ElectronicEnthusiast/ElectricSkateboard/Pictures/IDDK_V2_Level2_TestingLEMCurrentSensing/20170704_121624.jpg

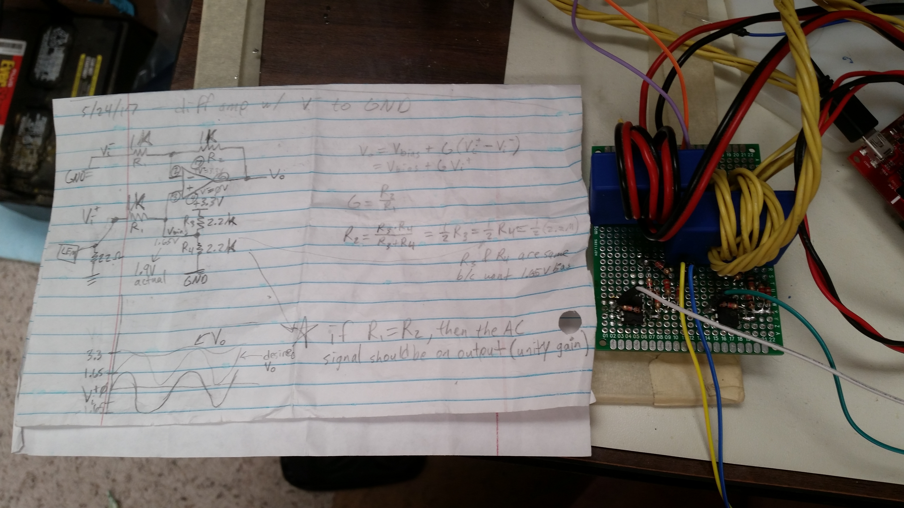
Pictures/IDDK_V2_Level2_TestingLEMCurrentSensing/20170704_121624.jpg
