ElectronicEnthusiast/ElectricSkateboard/Pictures/IDDK_V2_Level1_TestingSVPWM_DirectQuadratureTesting/20170227_211748.jpg-1230x0.jpg

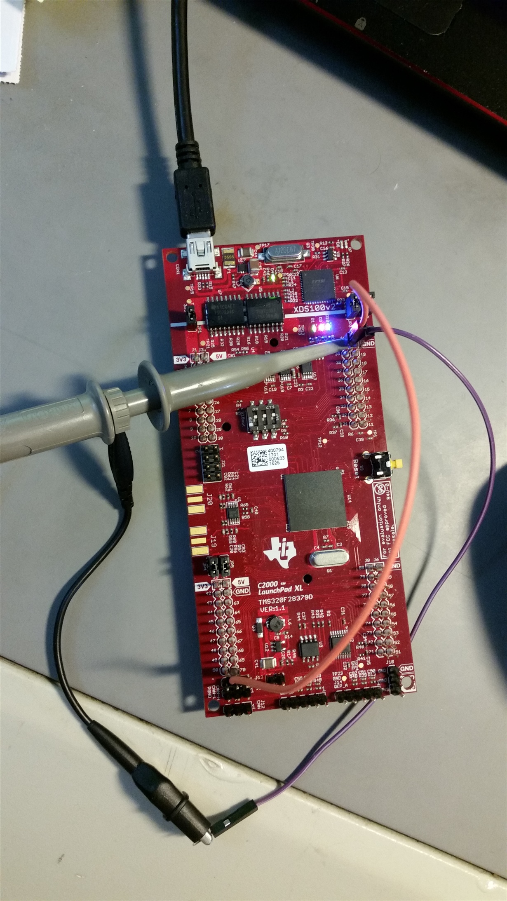
Pictures/IDDK_V2_Level1_TestingSVPWM_DirectQuadratureTesting/20170227_211748.jpg-1230x0.jpg
