ElectronicEnthusiast/ElectricSkateboard/README.md

# MotorController
Inverter Motor Control Board For BLDC Motor - 100V,100A

The motor controller board is generic, so it will comply with all Texas Instruments Launchpads using their "Boosterpack pin layout".
The board software utilizes a high performance F28379D Launchpad microcontroller development board from Texas Instruments.
The motor controller uses Texas Instruments integrated circuits to isolate the logic from the power components.
