ElectronicEnthusiast/ElectricSkateboard/Hardware/Calculations_GateDriverBoard.xlsx

Sheet: MOSFETGateDriver
MOSFET Gate Drive Circuit Component Value Determinations
Referencing TexasInstruments: "tidubx1b.pdf"
VDD input (Volts) | 17
VDDA voltage after diode (volts) | 16.7
UCC21520DW GateDriver IC Limitations:
Max Source current (amps) | 4amps
Max Sink current (amps) | 6amps
Max voltage (VDDA & VDDB) | 25volts
IRFSL4115PBF MOSFET Limitations
Max voltage (Vgs) (volts) | 20
R_MosfetGate (ohms) minimum | 2.2
Source Current Calculation
Rg_ON (ohms) | 10
Rg_OFF (ohms) | 0
Bootstrap Diode and Off Diode | VS-MBRS130L-M3
Schottky Diode (low on time and low diode resistance
Voltage Drop Vdiode (Volts) | 0.3
Sink Current:
Current Consumption per MOSFET turn on (Bootstrap Circuit pumps charge to MOSFET gate)

Sheet: BusVoltageAnalogSensing
Bus Voltage Scaling
Referencing TexasInstruments: "tidubx1b.pdf"
Maximum Input Bus Voltage (Volt) | 100
Sense Voltage Range (Volt) | 0.5 | // this is the input capability of the amplifier (+/- 250mV for AMC1301)
 |  | // 500mV is total range of input +250mV - (-250mV)
R_batt1 (Ohm) | 1000000
R_batt2 (Ohm) | 1000000
R_batt3 (Ohm) | 1000000
R_batt4 (Ohm) | 1000000
HighVoltageResistance (Ohm) | 4000000
Solved Sense Resistor Value (ohm) | 20100.50251 |  | Maximum Output Voltage (Volt) | 0.5
Calculate Voltage Divider after larger voltage divider that shifts the input voltage from 0V-500mV to +/-250mV
Premise: Offset the bottom of the differential signal to give value of +250mV there. This will give -250mV if the top rail sees 0V for the Battery+ voltage
Vsense | 0.5
DesiredVoltageBiasOfBottomVoltage | 0.25
Bias Input Voltage (Volt) | 3.3
R_topSecondVoltageDivider (ohm) | 50000
RBottomSecondVoltageDivider_Solver (ohm) | 4098.360656
Bias Voltage (Volt) | 0.25
AMC1301 Input Differential Low-Pass Filter | fc = 1/(2πRC)
Capacitor | 1e-08
Resistor | 78
Desired Cutoff Frequency | 204044.7988
AMC1301 Output Differential Low-Pass Filter | fc = 1/(2πRC)
Capacitor | 1e-08
Resistor | 9400
Desired Cutoff Frequency | 1693.1377
OPA320 Feedback Low-Pass Filter | fc = 1/(2πRC)
Capacitor | 1e-08
Resistor | 7500
Desired Cutoff Frequency | 2122.0659
OPA320 Output Low-Pass Filter | fc = 1/(2πRC)
Capacitor | 1e-07
Resistor | 100
Desired Cutoff Frequency | 15915.4943

Sheet: TemperatureSensing
H-Bridge Temperature Analog Scaling
Referencing TexasInstruments: "tidubx1b.pdf"
Vsense_Thermistor (Volt) | 0.5 | // this is the input capability of the amplifier (+/- 250mV for AMC1301)
 |  | // 500mV is total range of input +250mV - (-250mV)
Input Thermistor Voltage Divider (Volt) | 3.3
R_thermistor (ohm) | 10000 | //chose common thermistor restance value
R_topThermistorVoltageDivider (ohm) | 56000.0000
Thermistor Resistance (25degC) | 10000
Thermistor Resistance (100degC) | 1000
TemperatureRangeMin (25degC) (Volt) | 0.5 | //at 25degC, the resistance is 10kΩ and voltage at output of thermistor divider is 500mV
TemperatureRangeMax (100degC) (Volt) | 0.05789473684 | //at 100degC, the resistance is 1kΩ and voltage at output of thermistor divider is 57mV
Calculate Voltage Divider after larger voltage divider that shifts the input voltage from 0V-500mV to +/-250mV
Premise: Offset the bottom of the differential signal to give value of +250mV there. This will give -250mV if the thermistor reads 100degC and reads about 0.05789V
Vsense | 0.5
DesiredVoltageBiasOfBottomVoltage | 0.25
Bias Input Voltage (Volt) | 3.3
R_topSecondVoltageDivider (ohm) | 50000
RBottomSecondVoltageDivider_Solver (ohm) | 4098.360656
Bias Voltage (Volt) | 0.25
AMC1301 Input Differential Low-Pass Filter | fc = 1/(2πRC)
Capacitor | 1e-08 | 1.8e-10
Resistor | 78 | 9400
Desired Cutoff Frequency | 204044.7988
AMC1301 Output Differential Low-Pass Filter | fc = 1/(2πRC)
Capacitor | 1e-08
Resistor | 9400
Desired Cutoff Frequency | 1693.1377
OPA320 Feedback Low-Pass Filter | fc = 1/(2πRC)
Capacitor | 1e-08
Resistor | 7500
Desired Cutoff Frequency | 2122.0659
OPA320 Output Low-Pass Filter | fc = 1/(2πRC)
Capacitor | 1e-07
Resistor | 100
Desired Cutoff Frequency | 15915.4943

Sheet: PhaseCurrentSensing
Closed Loop Hall Current Sensing Analog Scaling for "LEM LA 100-P"
Referencing TexasInstruments: "tidubx1b.pdf"
Desired HallCurrentSensor Scaled (AC Volts) | 1.65
Desired DC Bias after Scaling to [-1.65V,1.65V]
Reading 0Amps at Microcontroller [Volts] | 0
Reading 150Amps at Microcontroller [Volts] | 1.65
Input HallCurrentSensor Voltage Divider [Volts] | 15
LEM Rm_total (ohm) == R1+R2 [ohms] | 22 | //total output impedance [ohms] of Hall Sensor (from LEM LA-100P datasheet under 85degC 150Amps max current condition)
Voltage Divider to Calculate Measuring Resistor Values for LEM Current Transducer
R1 | 2.42
R2 | 19.58
IsenseCurrent on secondary @ full LEM primary current of 100A | 0.6818181818
Vin_Max | 15
Vin_Min | -15
Vin range | 30
Vout_Max | 3.3
Vout_Min | 0
Vout range | 3.3
Vbias | 3.3
Vout_bias | 1.65
LEM Full Scale Range Measurement [Amps] | 150
LEM Conversion Turns Ratio [N wire turns] | 2000 | //Denoted by Kn (Conversion Ratio on Datasheet of LEM)
LEM Full Scale Secondary Transformer Current [Amps] | 0.075
Rm | 22

Sheet: Sheet1
LA 100-P | Units
Conversion Turns Ratio | Turns | 2000
Ip_max | Amps | 150
Secondary Current | Amps | 0.075
Measure Resistor | Ohms | 22
Max Voltage | Volts | 1.65
