ElectronicEnthusiast/ElectricSkateboard/Hardware/GateDriver_BLDC_MOSFET_PDF/GateDriver_BLDC_MOSFET.jpg

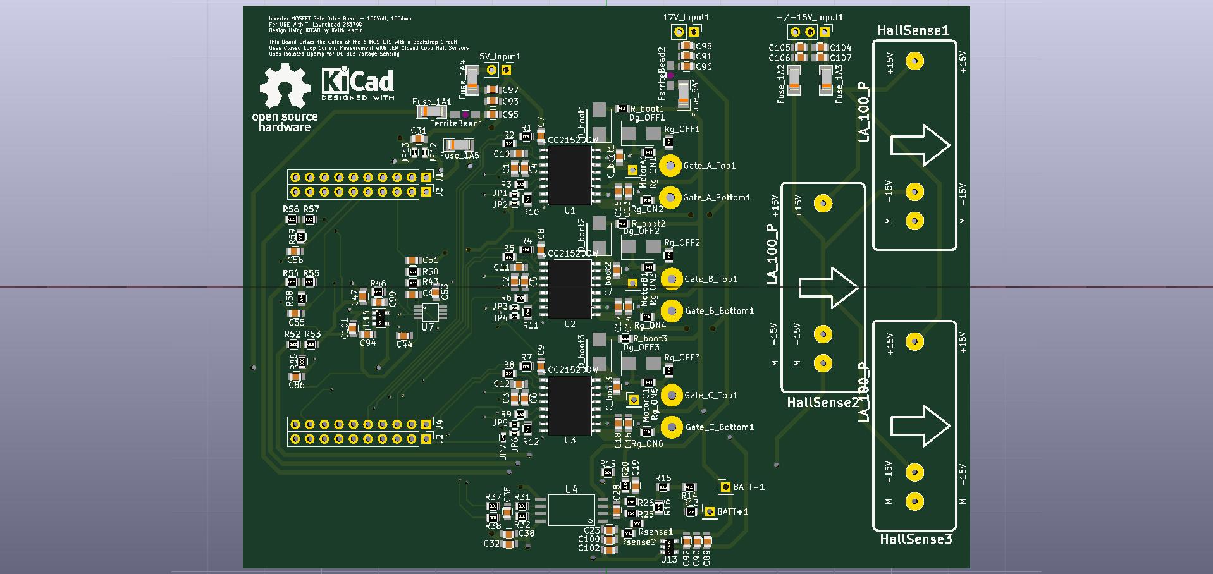
Hardware/GateDriver_BLDC_MOSFET_PDF/GateDriver_BLDC_MOSFET.jpg
