ElectronicEnthusiast/ElectricSkateboard/Hardware/BOM1_Mouser.xlsx

Web Link | Added To Mouser | ref | value5 | Description | footprint |  | part | names | tstamps6 | tstamp | lib7 | part8 | field | name9 | num | name10 | type | description2 | fp | logical | uri | code | name11 | ref12 | pin
 | Y | +/-15V_Input1 | CONN_01X03 |  | Socket_Strips:Socket_Strip_Straight_1x03_Pitch2.54mm |  | CONN_01X03 | /Power_Inputs/ | /581F1F0E/ | 581F75B2
 | Y | 17V_Input1 | CONN_01X02 |  | Socket_Strips:Socket_Strip_Straight_1x02_Pitch2.54mm |  | CONN_01X02 | /Power_Inputs/ | /581F1F0E/ | 582BFE9A
 | Y | 5V_Input1 | CONN_01X02 |  | Socket_Strips:Socket_Strip_Straight_1x02_Pitch2.54mm |  | CONN_01X02 | /Power_Inputs/ | /581F1F0E/ | 582C5D3C
 | Y | BATT+1 | BATT+ |  | Socket_Strips:Socket_Strip_Straight_1x01_Pitch2.54mm |  | PowerPin | /Power_Inputs/ | /581F1F0E/ | 58707C93
 | Y | BATT-1 | BATT- |  | Socket_Strips:Socket_Strip_Straight_1x01_Pitch2.54mm |  | PowerPin | /Power_Inputs/ | /581F1F0E/ | 58707D56
http://www.mouser.com/ProductDetail/GE-Critical-Power/SHHN000A3CL41Z/ | Y | +/-15V_Converter | SHHN000A3CL41Z |  | Isolated DC/DC Converters 9-36Vin, +/-15V out 9W Out | http://www.mouser.com/GE-Critical-Power/ | 894-SHHN000A3CL41Z
http://www.digikey.com/product-detail/en/aavid-thermalloy/6237BG/HS411-ND/1625500 | N | MOSFET Heat Sinks TO-220 HORIZ/VERT HAT SECT. CLIP ON |  |  | 6237BG | http://www.mouser.com/Aavid-Thermalloy/ | HS411-ND
http://www.mouser.com/ProductDetail/TDK/C2012X5R1H475K125AB/ | Y | C_boot1 | 0.47uF_ceramic |  | Capacitors_SMD:C_0805 |  | C | /GateDriveSheet/ | /5802F342/ | 5803E753
http://www.mouser.com/ProductDetail/TDK/C2012X5R1H475K125AB/ | Y | C_boot2 | 0.47uF_ceramic |  | Capacitors_SMD:C_0805 |  | C | /GateDriveSheet/ | /5802F342/ | 5806E60D
http://www.mouser.com/ProductDetail/TDK/C2012X5R1H475K125AB/ | Y | C_boot3 | 0.47uF_ceramic |  | Capacitors_SMD:C_0805 |  | C | /GateDriveSheet/ | /5802F342/ | 58070707
http://www.mouser.com/ProductDetail/Murata-Electronics/GRM21BR61E106KA73L/ | Y | C1 | 10uF_ceramic | Multilayer Ceramic Capacitors MLCC - SMD/SMT 0805 X5R 25V 10uF | Capacitors_SMD:C_0805 |  | C | /GateDriveSheet/ | /5802F342/ | 58038EB1
http://www.mouser.com/ProductDetail/KEMET/C0805C100J5GACTU/?qs=sGAEpiMZZMs0AnBnWHyRQAOlcDrFW2iELdDAK38U86U%3d | Y | C10 | 10pF_ceramic | Multilayer Ceramic Capacitors MLCC - SMD/SMT 50volts 10pF C0G 5% | Capacitors_SMD:C_0805 |  | C | /GateDriveSheet/ | /5802F342/ | 5803D299
http://www.mouser.com/ProductDetail/Murata-Electronics/GRM21BR61E106KA73L/ | Y | C100 | 10uF_ceramic | Multilayer Ceramic Capacitors MLCC - SMD/SMT 0805 X5R 25V 10uF | Capacitors_SMD:C_0805 |  | C_Small | /Power_Inputs/ | /581F1F0E/ | 589CA2C8
http://www.mouser.com/ProductDetail/KEMET/C0805C104K5RACTU/ | Y | C101 | 0.1uF_ceramic | Multilayer Ceramic Capacitors MLCC - SMD/SMT 50volts 0.1uF X7R 10% | Capacitors_SMD:C_0805 |  | C_Small | /Power_Inputs/ | /581F1F0E/ | 582D51F0
http://www.mouser.com/ProductDetail/KEMET/C0805C104K5RACTU/ | Y | C102 | 0.1uF_ceramic | Multilayer Ceramic Capacitors MLCC - SMD/SMT 50volts 0.1uF X7R 10% | Capacitors_SMD:C_0805 |  | C_Small | /Power_Inputs/ | /581F1F0E/ | 58221FE9
http://www.mouser.com/ProductDetail/KEMET/C0805C104K5RACTU/ | Y | C104 | 0.1uF_ceramic | Multilayer Ceramic Capacitors MLCC - SMD/SMT 50volts 0.1uF X7R 10% | Capacitors_SMD:C_0805 |  | C_Small | /Power_Inputs/ | /581F1F0E/ | 5822C599
http://www.mouser.com/ProductDetail/KEMET/C0805C104K5RACTU/ | Y | C105 | 0.1uF_ceramic | Multilayer Ceramic Capacitors MLCC - SMD/SMT 50volts 0.1uF X7R 10% | Capacitors_SMD:C_0805 |  | C_Small | /Power_Inputs/ | /581F1F0E/ | 5822C614
http://www.mouser.com/ProductDetail/Murata-Electronics/GRM21BR61E106KA73L/ | Y | C106 | 10uF_ceramic | Multilayer Ceramic Capacitors MLCC - SMD/SMT 0805 X5R 25V 10uF | Capacitors_SMD:C_0805 |  | C_Small | /Power_Inputs/ | /581F1F0E/ | 5822F04E
http://www.mouser.com/ProductDetail/Murata-Electronics/GRM21BR61E106KA73L/ | Y | C107 | 10uF_ceramic | Multilayer Ceramic Capacitors MLCC - SMD/SMT 0805 X5R 25V 10uF | Capacitors_SMD:C_0805 |  | C_Small | /Power_Inputs/ | /581F1F0E/ | 5822FAB2
http://www.mouser.com/ProductDetail/KEMET/C0805C100J5GACTU/?qs=sGAEpiMZZMs0AnBnWHyRQAOlcDrFW2iELdDAK38U86U%3d | Y | C11 | 10pF_ceramic | Multilayer Ceramic Capacitors MLCC - SMD/SMT 50volts 10pF C0G 5% | Capacitors_SMD:C_0805 |  | C | /GateDriveSheet/ | /5802F342/ | 5806E5E8
http://www.mouser.com/ProductDetail/KEMET/C0805C100J5GACTU/?qs=sGAEpiMZZMs0AnBnWHyRQAOlcDrFW2iELdDAK38U86U%3d | Y | C12 | 10pF_ceramic | Multilayer Ceramic Capacitors MLCC - SMD/SMT 50volts 10pF C0G 5% | Capacitors_SMD:C_0805 |  | C | /GateDriveSheet/ | /5802F342/ | 580706E6
http://www.mouser.com/ProductDetail/Murata-Electronics/GRM21BR61E106KA73L/ | Y | C13 | 10uF_ceramic | Multilayer Ceramic Capacitors MLCC - SMD/SMT 0805 X5R 25V 10uF | Capacitors_SMD:C_0805 |  | C | /GateDriveSheet/ | /5802F342/ | 5803E0BF
http://www.mouser.com/ProductDetail/Murata-Electronics/GRM21BR61E106KA73L/ | Y | C14 | 10uF_ceramic | Multilayer Ceramic Capacitors MLCC - SMD/SMT 0805 X5R 25V 10uF | Capacitors_SMD:C_0805 |  | C | /GateDriveSheet/ | /5802F342/ | 5806E5FE
http://www.mouser.com/ProductDetail/Murata-Electronics/GRM21BR61E106KA73L/ | Y | C15 | 10uF_ceramic | Multilayer Ceramic Capacitors MLCC - SMD/SMT 0805 X5R 25V 10uF | Capacitors_SMD:C_0805 |  | C | /GateDriveSheet/ | /5802F342/ | 580706FC
http://www.mouser.com/ProductDetail/KEMET/C0805C104K5RACTU/ | Y | C16 | 0.1uF_ceramic | Multilayer Ceramic Capacitors MLCC - SMD/SMT 50volts 0.1uF X7R 10% | Capacitors_SMD:C_0805 |  | C | /GateDriveSheet/ | /5802F342/ | 580404E9
http://www.mouser.com/ProductDetail/KEMET/C0805C104K5RACTU/ | Y | C17 | 0.1uF_ceramic | Multilayer Ceramic Capacitors MLCC - SMD/SMT 50volts 0.1uF X7R 10% | Capacitors_SMD:C_0805 |  | C | /GateDriveSheet/ | /5802F342/ | 5806E640
http://www.mouser.com/ProductDetail/KEMET/C0805C104K5RACTU/ | Y | C18 | 0.1uF_ceramic | Multilayer Ceramic Capacitors MLCC - SMD/SMT 50volts 0.1uF X7R 10% | Capacitors_SMD:C_0805 |  | C | /GateDriveSheet/ | /5802F342/ | 58070732
http://www.mouser.com/ProductDetail/KEMET/C0805C103K5RACTU/ | Y | C19 | 0.01uF_ceramic | Multilayer Ceramic Capacitors MLCC - SMD/SMT 50volts 10000pF X7R 10% | Capacitors_SMD:C_0805 |  | C_Small | /AnalogSenseSheet/ | /5802F349/ | 5824C580
http://www.mouser.com/ProductDetail/Murata-Electronics/GRM21BR61E106KA73L/ | Y | C2 | 10uF_ceramic | Multilayer Ceramic Capacitors MLCC - SMD/SMT 0805 X5R 25V 10uF | Capacitors_SMD:C_0805 |  | C | /GateDriveSheet/ | /5802F342/ | 5806E5BF
http://www.mouser.com/ProductDetail/KEMET/C0805C104K5RACTU/ | Y | C23 | 0.1uF_ceramic | Multilayer Ceramic Capacitors MLCC - SMD/SMT 50volts 0.1uF X7R 10% | Capacitors_SMD:C_0805 |  | C_Small | /AnalogSenseSheet/ | /5802F349/ | 589807D1
http://www.mouser.com/ProductDetail/KEMET/C0805C103K5RACTU/ | Y | C28 | 0.01uF_ceramic | Multilayer Ceramic Capacitors MLCC - SMD/SMT 50volts 10000pF X7R 10% | Capacitors_SMD:C_0805 |  | C_Small | /AnalogSenseSheet/ | /5802F349/ | 58237B37
http://www.mouser.com/ProductDetail/Murata-Electronics/GRM21BR61E106KA73L/ | Y | C3 | 10uF_ceramic | Multilayer Ceramic Capacitors MLCC - SMD/SMT 0805 X5R 25V 10uF | Capacitors_SMD:C_0805 |  | C | /GateDriveSheet/ | /5802F342/ | 580706BD
http://www.mouser.com/ProductDetail/KEMET/C0805C103K5RACTU/ | Y | C31 | 0.01uF_ceramic | Multilayer Ceramic Capacitors MLCC - SMD/SMT 50volts 10000pF X7R 10% | Capacitors_SMD:C_0805 |  | C_Small | /AnalogSenseSheet/ | /5802F349/ | 585CB118
http://www.mouser.com/ProductDetail/Murata-Electronics/GRM21BR61E475MA12L/ | Y | C32 | 4.7uF_ceramic | Multilayer Ceramic Capacitors MLCC - SMD/SMT 4.7uF 25Volts 20% | Capacitors_SMD:C_0805 |  | C_Small | /AnalogSenseSheet/ | /5802F349/ | 58237B45
http://www.mouser.com/ProductDetail/KEMET/C0805C103K5RACTU/ | Y | C35 | 0.01uF_ceramic | Multilayer Ceramic Capacitors MLCC - SMD/SMT 50volts 10000pF X7R 10% | Capacitors_SMD:C_0805 |  | C_Small | /AnalogSenseSheet/ | /5802F349/ | 5829134F
http://www.mouser.com/ProductDetail/KEMET/C0805C104K5RACTU/ | Y | C38 | 0.1uF_ceramic | Multilayer Ceramic Capacitors MLCC - SMD/SMT 50volts 0.1uF X7R 10% | Capacitors_SMD:C_0805 |  | C_Small | /AnalogSenseSheet/ | /5802F349/ | 58237B3E
http://www.mouser.com/ProductDetail/KEMET/C0805C104K5RACTU/ | Y | C4 | 0.1uF_ceramic | Multilayer Ceramic Capacitors MLCC - SMD/SMT 50volts 0.1uF X7R 10% | Capacitors_SMD:C_0805 |  | C | /GateDriveSheet/ | /5802F342/ | 5803F699
http://www.mouser.com/ProductDetail/KEMET/C0805C181K5GACTU/ | Y | C43 | 180pF_ceramic | Multilayer Ceramic Capacitors MLCC - SMD/SMT 50volts 180pF C0G 10% | Capacitors_SMD:C_0805 |  | C_Small | /AnalogSenseSheet/ | /5802F349/ | 5829B698
http://www.mouser.com/ProductDetail/KEMET/C0805C103K5RACTU/ | Y | C44 | 0.01uF_ceramic | Multilayer Ceramic Capacitors MLCC - SMD/SMT 50volts 10000pF X7R 10% | Capacitors_SMD:C_0805 |  | C_Small | /AnalogSenseSheet/ | /5802F349/ | 58274015
http://www.mouser.com/ProductDetail/KEMET/C0805C103K5RACTU/ | Y | C47 | 0.01uF_ceramic | Multilayer Ceramic Capacitors MLCC - SMD/SMT 50volts 10000pF X7R 10% | Capacitors_SMD:C_0805 |  | C_Small | /AnalogSenseSheet/ | /5802F349/ | 58292266
http://www.mouser.com/ProductDetail/KEMET/C0805C104K5RACTU/ | Y | C5 | 0.1uF_ceramic | Multilayer Ceramic Capacitors MLCC - SMD/SMT 50volts 0.1uF X7R 10% | Capacitors_SMD:C_0805 |  | C | /GateDriveSheet/ | /5802F342/ | 5806E630
http://www.mouser.com/ProductDetail/KEMET/C0805C104K5RACTU/ | Y | C51 | 0.1uF_ceramic | Multilayer Ceramic Capacitors MLCC - SMD/SMT 50volts 0.1uF X7R 10% | Capacitors_SMD:C_0805 |  | C_Small | /AnalogSenseSheet/ | /5802F349/ | 587D199E
http://www.mouser.com/ProductDetail/KEMET/C0805C103K5RACTU/ | Y | C53 | 0.01uF_ceramic | Multilayer Ceramic Capacitors MLCC - SMD/SMT 50volts 10000pF X7R 10% | Capacitors_SMD:C_0805 |  | C_Small | /AnalogSenseSheet/ | /5802F349/ | 582ABBA9
http://www.mouser.com/ProductDetail/AVX/08051A152JAT2A/?qs=sGAEpiMZZMs0AnBnWHyRQFTaD8luxIJIHyCBcpdDB0k%3d | Y | C55 | 1500pF_ceramic | Multilayer Ceramic Capacitors MLCC - SMD/SMT 100V 1500pF C0G 0805 5% Tol | Capacitors_SMD:C_0805 |  | C_Small | /AnalogSenseSheet/ | /5802F349/ | 589B255D
http://www.mouser.com/ProductDetail/AVX/08051A152JAT2A/?qs=sGAEpiMZZMs0AnBnWHyRQFTaD8luxIJIHyCBcpdDB0k%3d | Y | C56 | 1500pF_ceramic | Multilayer Ceramic Capacitors MLCC - SMD/SMT 100V 1500pF C0G 0805 5% Tol | Capacitors_SMD:C_0805 |  | C_Small | /AnalogSenseSheet/ | /5802F349/ | 589B6A22
http://www.mouser.com/ProductDetail/KEMET/C0805C104K5RACTU/ | Y | C6 | 0.1uF_ceramic | Multilayer Ceramic Capacitors MLCC - SMD/SMT 50volts 0.1uF X7R 10% | Capacitors_SMD:C_0805 |  | C | /GateDriveSheet/ | /5802F342/ | 58070728
http://www.mouser.com/ProductDetail/KEMET/C0805C100J5GACTU/?qs=sGAEpiMZZMs0AnBnWHyRQAOlcDrFW2iELdDAK38U86U%3d | Y | C7 | 10pF_ceramic | Multilayer Ceramic Capacitors MLCC - SMD/SMT 50volts 10pF C0G 5% | Capacitors_SMD:C_0805 |  | C | /GateDriveSheet/ | /5802F342/ | 5803D228
http://www.mouser.com/ProductDetail/KEMET/C0805C100J5GACTU/?qs=sGAEpiMZZMs0AnBnWHyRQAOlcDrFW2iELdDAK38U86U%3d | Y | C8 | 10pF_ceramic | Multilayer Ceramic Capacitors MLCC - SMD/SMT 50volts 10pF C0G 5% | Capacitors_SMD:C_0805 |  | C | /GateDriveSheet/ | /5802F342/ | 5806E5E2
http://www.mouser.com/ProductDetail/AVX/08051A152JAT2A/?qs=sGAEpiMZZMs0AnBnWHyRQFTaD8luxIJIHyCBcpdDB0k%3d | Y | C86 | 1500pF_ceramic | Multilayer Ceramic Capacitors MLCC - SMD/SMT 100V 1500pF C0G 0805 5% Tol | Capacitors_SMD:C_0805 |  | C_Small | /AnalogSenseSheet/ | /5802F349/ | 587F38EC
http://www.mouser.com/ProductDetail/Murata-Electronics/GRM21BR61E106KA73L/ | Y | C89 | 10uF_ceramic | Multilayer Ceramic Capacitors MLCC - SMD/SMT 0805 X5R 25V 10uF | Capacitors_SMD:C_0805 |  | C_Small | /Power_Inputs/ | /581F1F0E/ | 58221F6A
http://www.mouser.com/ProductDetail/KEMET/C0805C100J5GACTU/?qs=sGAEpiMZZMs0AnBnWHyRQAOlcDrFW2iELdDAK38U86U%3d | Y | C9 | 10pF_ceramic | Multilayer Ceramic Capacitors MLCC - SMD/SMT 50volts 10pF C0G 5% | Capacitors_SMD:C_0805 |  | C | /GateDriveSheet/ | /5802F342/ | 580706E0
http://www.mouser.com/ProductDetail/Murata-Electronics/GRM21BR61E106KA73L/ | Y | C90 | 10uF_ceramic | Multilayer Ceramic Capacitors MLCC - SMD/SMT 0805 X5R 25V 10uF | Capacitors_SMD:C_0805 |  | C_Small | /Power_Inputs/ | /581F1F0E/ | 589CB414
http://www.mouser.com/ProductDetail/Murata-Electronics/GRM21BR61E475MA12L/ | Y | C91 | 4.7uF_ceramic | Multilayer Ceramic Capacitors MLCC - SMD/SMT 4.7uF 25Volts 20% | Capacitors_SMD:C_0805 |  | C_Small | /Power_Inputs/ | /581F1F0E/ | 5821CE02
http://www.mouser.com/ProductDetail/KEMET/C0805C104K5RACTU/ | Y | C92 | 0.1uF_ceramic | Multilayer Ceramic Capacitors MLCC - SMD/SMT 50volts 0.1uF X7R 10% | Capacitors_SMD:C_0805 |  | C_Small | /Power_Inputs/ | /581F1F0E/ | 58221CE4
http://www.mouser.com/ProductDetail/Murata-Electronics/GRM21BR61E475MA12L/ | Y | C93 | 4.7uF_ceramic | Multilayer Ceramic Capacitors MLCC - SMD/SMT 4.7uF 25Volts 20% | Capacitors_SMD:C_0805 |  | C_Small | /Power_Inputs/ | /581F1F0E/ | 582C678D
http://www.mouser.com/ProductDetail/KEMET/C0805C104K5RACTU/ | Y | C94 | 0.1uF_ceramic | Multilayer Ceramic Capacitors MLCC - SMD/SMT 50volts 0.1uF X7R 10% | Capacitors_SMD:C_0805 |  | C_Small | /Power_Inputs/ | /581F1F0E/ | 582D725C
http://www.mouser.com/ProductDetail/Murata-Electronics/GRM21BR61E106KA73L/ | Y | C95 | 10uF_ceramic | Multilayer Ceramic Capacitors MLCC - SMD/SMT 0805 X5R 25V 10uF | Capacitors_SMD:C_0805 |  | C_Small | /Power_Inputs/ | /581F1F0E/ | 582C6794
http://www.mouser.com/ProductDetail/Murata-Electronics/GRM21BR61E106KA73L/ | Y | C96 | 10uF_ceramic | Multilayer Ceramic Capacitors MLCC - SMD/SMT 0805 X5R 25V 10uF | Capacitors_SMD:C_0805 |  | C_Small | /Power_Inputs/ | /581F1F0E/ | 5821E84D
http://www.mouser.com/ProductDetail/KEMET/C0805C104K5RACTU/ | Y | C97 | 0.1uF_ceramic | Multilayer Ceramic Capacitors MLCC - SMD/SMT 50volts 0.1uF X7R 10% | Capacitors_SMD:C_0805 |  | C_Small | /Power_Inputs/ | /581F1F0E/ | 582C6786
http://www.mouser.com/ProductDetail/KEMET/C0805C104K5RACTU/ | Y | C98 | 0.1uF_ceramic | Multilayer Ceramic Capacitors MLCC - SMD/SMT 50volts 0.1uF X7R 10% | Capacitors_SMD:C_0805 |  | C_Small | /Power_Inputs/ | /581F1F0E/ | 5821CDE9
http://www.mouser.com/ProductDetail/KEMET/C0805C104K5RACTU/ | Y | C99 | 0.1uF_ceramic | Multilayer Ceramic Capacitors MLCC - SMD/SMT 50volts 0.1uF X7R 10% | Capacitors_SMD:C_0805 |  | C_Small | /Power_Inputs/ | /581F1F0E/ | 582D63D0
http://www.mouser.com/ProductDetail/Vishay/VS-MBRS130L-M3-5BT/ | Y | D_boot1 | VS-MBRS130L-M3 | Schottky Diodes & Rectifiers 1A 30V Single Die Schottky Rectifier | Diodes_SMD:D_SMB_Standard |  | D_Schottky | /GateDriveSheet/ | /5802F342/ | 58A5D18F
http://www.mouser.com/ProductDetail/Vishay/VS-MBRS130L-M3-5BT/ | Y | D_boot2 | VS-MBRS130L-M3 | Schottky Diodes & Rectifiers 1A 30V Single Die Schottky Rectifier | Diodes_SMD:D_SMB_Standard |  | D_Schottky | /GateDriveSheet/ | /5802F342/ | 58A650B2
http://www.mouser.com/ProductDetail/Vishay/VS-MBRS130L-M3-5BT/ | Y | D_boot3 | VS-MBRS130L-M3 | Schottky Diodes & Rectifiers 1A 30V Single Die Schottky Rectifier | Diodes_SMD:D_SMB_Standard |  | D_Schottky | /GateDriveSheet/ | /5802F342/ | 58A6A6DD
http://www.mouser.com/ProductDetail/Vishay/VS-MBRS130L-M3-5BT/ | Y | Dg_OFF1 | VS-MBRS130L-M3 | Schottky Diodes & Rectifiers 1A 30V Single Die Schottky Rectifier | Diodes_SMD:D_SMB_Standard |  | D_Schottky | /GateDriveSheet/ | /5802F342/ | 58A5BA1F
http://www.mouser.com/ProductDetail/Vishay/VS-MBRS130L-M3-5BT/ | Y | Dg_OFF2 | VS-MBRS130L-M3 | Schottky Diodes & Rectifiers 1A 30V Single Die Schottky Rectifier | Diodes_SMD:D_SMB_Standard |  | D_Schottky | /GateDriveSheet/ | /5802F342/ | 58A69641
http://www.mouser.com/ProductDetail/Vishay/VS-MBRS130L-M3-5BT/ | Y | Dg_OFF3 | VS-MBRS130L-M3 | Schottky Diodes & Rectifiers 1A 30V Single Die Schottky Rectifier | Diodes_SMD:D_SMB_Standard |  | D_Schottky | /GateDriveSheet/ | /5802F342/ | 58A6AE3D
http://www.mouser.com/ProductDetail/Murata/BLM31SN500SH1L/ | Y | FerriteBead1 | BLM31SN500SH1L | Ferrite Beads 1206 50ohms 12A DCR=.0016ohm AutoPWR | Choke_SMD:Choke_SMD_1206_Standard |  | L_Small | /Power_Inputs/ | /581F1F0E/ | 582C8724
http://www.mouser.com/ProductDetail/Murata/BLM31SN500SH1L/ | Y | FerriteBead2 | BLM31SN500SH1L | Ferrite Beads 1206 50ohms 12A DCR=.0016ohm AutoPWR | Choke_SMD:Choke_SMD_1206_Standard |  | L_Small | /Power_Inputs/ | /581F1F0E/ | 582206E3
http://www.mouser.com/ProductDetail/Vishay/MFU1206FF01000P100/ | Y | Fuse_1A1 | MFU1206FF01000P100 | Surface Mount Fuses 63V 1.0A Fast Act Very Quick | SMD_Packages:SMD-1206_Pol |  | F_Small | /Power_Inputs/ | /581F1F0E/ | 582C8E2D
http://www.mouser.com/ProductDetail/Vishay/MFU1206FF01000P100/ | Y | Fuse_1A2 | MFU1206FF01000P100 | Surface Mount Fuses 63V 1.0A Fast Act Very Quick | SMD_Packages:SMD-1206_Pol |  | F_Small | /Power_Inputs/ | /581F1F0E/ | 5820C334
http://www.mouser.com/ProductDetail/Vishay/MFU1206FF01000P100/ | Y | Fuse_1A3 | MFU1206FF01000P100 | Surface Mount Fuses 63V 1.0A Fast Act Very Quick | SMD_Packages:SMD-1206_Pol |  | F_Small | /Power_Inputs/ | /581F1F0E/ | 5820B4DE
http://www.mouser.com/ProductDetail/Vishay/MFU1206FF01000P100/ | Y | Fuse_1A4 | MFU1206FF01000P100 | Surface Mount Fuses 63V 1.0A Fast Act Very Quick | SMD_Packages:SMD-1206_Pol |  | F_Small | /Power_Inputs/ | /581F1F0E/ | 58A8478B
http://www.mouser.com/ProductDetail/Vishay/MFU1206FF01000P100/ | Y | Fuse_1A5 | MFU1206FF01000P100 | Surface Mount Fuses 63V 1.0A Fast Act Very Quick | SMD_Packages:SMD-1206_Pol |  | F_Small | /AnalogSenseSheet/ | /5802F349/ | 58A9F4D3
http://www.mouser.com/ProductDetail/Vishay/MFU1206FF05000P100/ | Y | Fuse_5A1 | MFU1206FF05000P100 | Surface Mount Fuses 63V 5.0A Fast Act Very Quick | SMD_Packages:SMD-1206_Pol |  | F_Small | /Power_Inputs/ | /581F1F0E/ | 5820B73F
 | Y | Gate_A_Bottom1 | Gate_A_Bottom |  | Wire_Pads:SolderWirePad_single_1-5mmDrill |  | TEST_1P | /GateDriveSheet/ | /5802F342/ | 5899AA7E
 | Y | Gate_A_Top1 | Gate_A_Top |  | Wire_Pads:SolderWirePad_single_1-5mmDrill |  | TEST_1P | /GateDriveSheet/ | /5802F342/ | 58999AFA
 | Y | Gate_B_Bottom1 | Gate_B_Bottom |  | Wire_Pads:SolderWirePad_single_1-5mmDrill |  | TEST_1P | /GateDriveSheet/ | /5802F342/ | 589A1964
 | Y | Gate_B_Top1 | Gate_B_Top |  | Wire_Pads:SolderWirePad_single_1-5mmDrill |  | TEST_1P | /GateDriveSheet/ | /5802F342/ | 589A1C06
 | Y | Gate_C_Bottom1 | Gate_C_Bottom |  | Wire_Pads:SolderWirePad_single_1-5mmDrill |  | TEST_1P | /GateDriveSheet/ | /5802F342/ | 589C7ACE
 | Y | Gate_C_Top1 | Gate_C_Top |  | Wire_Pads:SolderWirePad_single_1-5mmDrill |  | TEST_1P | /GateDriveSheet/ | /5802F342/ | 589D212C
 | N | HallSense1 | LA_100_P |  | KicadPcbPackages:la_55_p |  | LA_55_P | /AnalogSenseSheet/ | /5802F349/ | 589E9DB1
 | N | HallSense2 | LA_100_P |  | KicadPcbPackages:la_55_p |  | LA_55_P | /AnalogSenseSheet/ | /5802F349/ | 589F2BB4
 | N | HallSense3 | LA_100_P |  | KicadPcbPackages:la_55_p |  | LA_55_P | /AnalogSenseSheet/ | /5802F349/ | 589F76D2
 | N | J1 | TI_BOOSTER_40_J1 |  | Socket_Strips:Socket_Strip_Straight_1x10_Pitch2.54mm |  | Ti_Booster_40_J1 | /AnalogSenseSheet/ | /5802F349/ | 5802FB8D
 | N | J2 | TI_BOOSTER_40_J2 |  | Socket_Strips:Socket_Strip_Straight_1x10_Pitch2.54mm |  | Ti_Booster_40_J2 | /GateDriveSheet/ | /5802F342/ | 5802FC8E
 | N | J3 | TI_BOOSTER_40_J3 |  | Socket_Strips:Socket_Strip_Straight_1x10_Pitch2.54mm |  | Ti_Booster_40_J3 | /AnalogSenseSheet/ | /5802F349/ | 5802FB94
 | N | J4 | TI_BOOSTER_40_J4 |  | Socket_Strips:Socket_Strip_Straight_1x10_Pitch2.54mm |  | Ti_Booster_40_J4 | /GateDriveSheet/ | /5802F342/ | 5802FC95
 | Y | JP1 | Jumper_NC_Small |  | Resistors_SMD:R_0603 |  | Jumper_NC_Small | /GateDriveSheet/ | /5802F342/ | 580351DD
 | Y | JP12 | Jumper_NC_Small |  | Resistors_SMD:R_0603 |  | Jumper_NC_Small | /AnalogSenseSheet/ | /5802F349/ | 582105B3
 | Y | JP13 | Jumper_NC_Small |  | Resistors_SMD:R_0603 |  | Jumper_NC_Small | /AnalogSenseSheet/ | /5802F349/ | 5809CADA
 | Y | JP2 | Jumper_NO_Small |  | Resistors_SMD:R_0603 |  | Jumper_NO_Small | /GateDriveSheet/ | /5802F342/ | 5803523C
 | Y | JP3 | Jumper_NC_Small |  | Resistors_SMD:R_0603 |  | Jumper_NC_Small | /GateDriveSheet/ | /5802F342/ | 5806E5AF
 | Y | JP4 | Jumper_NO_Small |  | Resistors_SMD:R_0603 |  | Jumper_NO_Small | /GateDriveSheet/ | /5802F342/ | 5806E5B5
 | Y | JP5 | Jumper_NC_Small |  | Resistors_SMD:R_0603 |  | Jumper_NC_Small | /GateDriveSheet/ | /5802F342/ | 580706AE
 | Y | JP6 | Jumper_NO_Small |  | Resistors_SMD:R_0603 |  | Jumper_NO_Small | /GateDriveSheet/ | /5802F342/ | 580706B4
 | Y | JP7 | Jumper_NC_Small |  | Resistors_SMD:R_0603 |  | Jumper_NC_Small | /GateDriveSheet/ | /5802F342/ | 58212600
 | Y | MotorA1 | MotorA |  | Socket_Strips:Socket_Strip_Straight_1x01_Pitch2.54mm |  | PowerPin | /GateDriveSheet/ | /5802F342/ | 58702D9C
 | Y | MotorB1 | MotorB |  | Socket_Strips:Socket_Strip_Straight_1x01_Pitch2.54mm |  | PowerPin | /GateDriveSheet/ | /5802F342/ | 587053F1
 | Y | MotorC1 | MotorC |  | Socket_Strips:Socket_Strip_Straight_1x01_Pitch2.54mm |  | PowerPin | /GateDriveSheet/ | /5802F342/ | 589B7308
http://www.mouser.com/ProductDetail/Vishay-Draloric/CRCW08052R20JNEAHP/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 | Y | R_boot1 | 2.2 | Thick Film Resistors - SMD 1/2watt 2.2ohms 5% High Power AEC-Q200 | Resistors_SMD:R_0805 |  | R | /GateDriveSheet/ | /5802F342/ | 5803DBCA
http://www.mouser.com/ProductDetail/Vishay-Draloric/CRCW08052R20JNEAHP/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 | Y | R_boot2 | 2.2 | Thick Film Resistors - SMD 1/2watt 2.2ohms 5% High Power AEC-Q200 | Resistors_SMD:R_0805 |  | R | /GateDriveSheet/ | /5802F342/ | 5806E5F2
http://www.mouser.com/ProductDetail/Vishay-Draloric/CRCW08052R20JNEAHP/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 | Y | R_boot3 | 2.2 | Thick Film Resistors - SMD 1/2watt 2.2ohms 5% High Power AEC-Q200 | Resistors_SMD:R_0805 |  | R | /GateDriveSheet/ | /5802F342/ | 580706F0
http://www.mouser.com/ProductDetail/Vishay-Draloric/CRCW080510R0FKEAHP/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 | Y | R1 | 10 |  | Resistors_SMD:R_0805 |  | R | /GateDriveSheet/ | /5802F342/ | 580338C3
http://www.mouser.com/ProductDetail/Panasonic/ERJ-6ENF1001V/ | Y | R10 | 1k | Thick Film Resistors - SMD 0805 1Kohms 1% AEC-Q200 | Resistors_SMD:R_0805 |  | R | /GateDriveSheet/ | /5802F342/ | 5803A80F
http://www.mouser.com/ProductDetail/Panasonic/ERJ-6ENF1001V/ | Y | R11 | 1k | Thick Film Resistors - SMD 0805 1Kohms 1% AEC-Q200 | Resistors_SMD:R_0805 |  | R | /GateDriveSheet/ | /5802F342/ | 5806E5DA
http://www.mouser.com/ProductDetail/Panasonic/ERJ-6ENF1001V/ | Y | R12 | 1k | Thick Film Resistors - SMD 0805 1Kohms 1% AEC-Q200 | Resistors_SMD:R_0805 |  | R | /GateDriveSheet/ | /5802F342/ | 580706D8
http://www.mouser.com/ProductDetail/ROHM-Semiconductor/KTR10EZPF1004/ | Y | R13 | 1M | Thick Film Resistors - SMD 0805 1MOhm 1% High VoltageAEC-Q200 | Resistors_SMD:R_0805 |  | R | /AnalogSenseSheet/ | /5802F349/ | 5823DD0F
http://www.mouser.com/ProductDetail/ROHM-Semiconductor/KTR10EZPF1004/ | Y | R14 | 1M | Thick Film Resistors - SMD 0805 1MOhm 1% High VoltageAEC-Q201 | Resistors_SMD:R_0805 |  | R | /AnalogSenseSheet/ | /5802F349/ | 5823D851
http://www.mouser.com/ProductDetail/ROHM-Semiconductor/KTR10EZPF1004/ | Y | R15 | 1M | Thick Film Resistors - SMD 0805 1MOhm 1% High VoltageAEC-Q202 | Resistors_SMD:R_0805 |  | R | /AnalogSenseSheet/ | /5802F349/ | 5823D7CE
http://www.mouser.com/ProductDetail/ROHM-Semiconductor/KTR10EZPF1004/ | Y | R16 | 1M | Thick Film Resistors - SMD 0805 1MOhm 1% High VoltageAEC-Q203 | Resistors_SMD:R_0805 |  | R | /AnalogSenseSheet/ | /5802F349/ | 5823D41F
http://www.mouser.com/ProductDetail/Panasonic/ERJ-6ENF4992V/ | Y | R19 | 50k | Thick Film Resistors - SMD 0805 49.9Kohms 1% AEC-Q200 | Resistors_SMD:R_0805 |  | R | /AnalogSenseSheet/ | /5802F349/ | 58242DC5
http://www.mouser.com/ProductDetail/Vishay-Draloric/CRCW080510R0FKEAHP/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 | Y | R2 | 10 | Thick Film Resistors - SMD 1/2watt 10ohms 1% High Power AEC-Q200 | Resistors_SMD:R_0805 |  | R | /GateDriveSheet/ | /5802F342/ | 58033B11
http://www.mouser.com/ProductDetail/Vishay/CRCW08054K12FKEA/ | Y | R20 | 4.1k | Thick Film Resistors - SMD 1/8watt 4.12Kohms 1% 100ppm | Resistors_SMD:R_0805 |  | R | /AnalogSenseSheet/ | /5802F349/ | 582426F3
http://www.mouser.com/ProductDetail/Vishay/CRCW080539R0FKEA/ | Y | R25 | 39 | Thick Film Resistors - SMD 1/8watt 39ohms 1% | Resistors_SMD:R_0805 |  | R | /AnalogSenseSheet/ | /5802F349/ | 58237B23
http://www.mouser.com/ProductDetail/Vishay/CRCW080539R0FKEA/ | Y | R26 | 39 | Thick Film Resistors - SMD 1/8watt 39ohms 1% | Resistors_SMD:R_0805 |  | R | /AnalogSenseSheet/ | /5802F349/ | 58237B2A
http://www.mouser.com/ProductDetail/Vishay-Draloric/CRCW080510R0FKEAHP/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 | Y | R3 | 10 | Thick Film Resistors - SMD 1/2watt 10ohms 1% High Power AEC-Q200 | Resistors_SMD:R_0805 |  | R | /GateDriveSheet/ | /5802F342/ | 58035181
http://www.mouser.com/ProductDetail/Vishay/CRCW08054K70JNEA/ | Y | R31 | 4.7k | Thick Film Resistors - SMD 1/8watt 4.7Kohms 5% 200ppm | Resistors_SMD:R_0805 |  | R | /AnalogSenseSheet/ | /5802F349/ | 58237B04
http://www.mouser.com/ProductDetail/Vishay/CRCW08054K70JNEA/ | Y | R32 | 4.7k | Thick Film Resistors - SMD 1/8watt 4.7Kohms 5% 200ppm | Resistors_SMD:R_0805 |  | R | /AnalogSenseSheet/ | /5802F349/ | 58237B0B
http://www.mouser.com/ProductDetail/Vishay/CRCW08054K70JNEA/ | Y | R37 | 4.7k | Thick Film Resistors - SMD 1/8watt 4.7Kohms 5% 200ppm | Resistors_SMD:R_0805 |  | R | /AnalogSenseSheet/ | /5802F349/ | 5827277F
http://www.mouser.com/ProductDetail/Vishay/CRCW08054K70JNEA/ | Y | R38 | 4.7k | Thick Film Resistors - SMD 1/8watt 4.7Kohms 5% 200ppm | Resistors_SMD:R_0805 |  | R | /AnalogSenseSheet/ | /5802F349/ | 58272863
http://www.mouser.com/ProductDetail/Vishay-Draloric/CRCW080510R0FKEAHP/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 | Y | R4 | 10 | Thick Film Resistors - SMD 1/2watt 10ohms 1% High Power AEC-Q200 | Resistors_SMD:R_0805 |  | R | /GateDriveSheet/ | /5802F342/ | 5806E590
http://www.mouser.com/ProductDetail/Vishay/CRCW08057K50FKEA/ | Y | R43 | 7.5k | Thick Film Resistors - SMD 1/8watt 7.5Kohms 1% 100ppm | Resistors_SMD:R_0805 |  | R | /AnalogSenseSheet/ | /5802F349/ | 5829B559
http://www.mouser.com/ProductDetail/Vishay/CRCW08054K70JNEA/ | Y | R46 | 4.7k | Thick Film Resistors - SMD 1/8watt 4.7Kohms 5% 200ppm | Resistors_SMD:R_0805 |  | R | /AnalogSenseSheet/ | /5802F349/ | 58291CDA
http://www.mouser.com/ProductDetail/Vishay-Draloric/CRCW080510R0FKEAHP/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 | Y | R5 | 10 | Thick Film Resistors - SMD 1/2watt 10ohms 1% High Power AEC-Q200 | Resistors_SMD:R_0805 |  | R | /GateDriveSheet/ | /5802F342/ | 5806E596
http://www.mouser.com/ProductDetail/Vishay/CRCW0805100RFKEA/ | Y | R50 | 100 | Thick Film Resistors - SMD 1/8watt 100ohms 1% 100ppm | Resistors_SMD:R_0805 |  | R | /AnalogSenseSheet/ | /5802F349/ | 587D1998
 | N | R52 | 17.16 | USING 10kohm with potentiometer INSTEAD OF FIXED VALUES | Resistors_SMD:R_0805 |  | R | /AnalogSenseSheet/ | /5802F349/ | 58248DE7
http://www.mouser.com/ProductDetail/Bourns/3309P-11-103/?qs=sGAEpiMZZMtC25l1F4XBU9QhtPcWQTAN3zXdoT5i49g%3d | N | R53 | 4.84 | USING POTENTIOMETER INSTEAD OF FIXED VALUES | Resistors_SMD:R_0805 |  | R | /AnalogSenseSheet/ | /5802F349/ | 5824947A
 | N | R54 | 17.16 | USING 10kohm with potentiometer INSTEAD OF FIXED VALUES | Resistors_SMD:R_0805 |  | R | /AnalogSenseSheet/ | /5802F349/ | 583E861C
http://www.mouser.com/ProductDetail/Bourns/3309P-11-103/?qs=sGAEpiMZZMtC25l1F4XBU9QhtPcWQTAN3zXdoT5i49g%3d | N | R55 | 4.84 | USING POTENTIOMETER INSTEAD OF FIXED VALUES | Resistors_SMD:R_0805 |  | R | /AnalogSenseSheet/ | /5802F349/ | 583E8622
 | N | R56 | 17.16 | USING 10kohm with potentiometer INSTEAD OF FIXED VALUES | Resistors_SMD:R_0805 |  | R | /AnalogSenseSheet/ | /5802F349/ | 5856FB5C
http://www.mouser.com/ProductDetail/Bourns/3309P-11-103/?qs=sGAEpiMZZMtC25l1F4XBU9QhtPcWQTAN3zXdoT5i49g%3d | N | R57 | 4.84 | USING POTENTIOMETER INSTEAD OF FIXED VALUES | Resistors_SMD:R_0805 |  | R | /AnalogSenseSheet/ | /5802F349/ | 5856FB62
http://www.mouser.com/ProductDetail/Panasonic/ERJ-P06J220V/?qs=sGAEpiMZZMu61qfTUdNhG5rFB6Qizrus3R51PmrkmB4%3d | Y | R58 | 22 | Thick Film Resistors - SMD 0805 22ohms 0.5W 5% AEC-Q200 | Resistors_SMD:R_0805 |  | R | /AnalogSenseSheet/ | /5802F349/ | 589B2557
http://www.mouser.com/ProductDetail/Panasonic/ERJ-P06J220V/?qs=sGAEpiMZZMu61qfTUdNhG5rFB6Qizrus3R51PmrkmB4%3d | Y | R59 | 22 | Thick Film Resistors - SMD 0805 22ohms 0.5W 5% AEC-Q200 | Resistors_SMD:R_0805 |  | R | /AnalogSenseSheet/ | /5802F349/ | 589B6A1C
http://www.mouser.com/ProductDetail/Vishay-Draloric/CRCW080510R0FKEAHP/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 | Y | R6 | 10 | Thick Film Resistors - SMD 1/2watt 10ohms 1% High Power AEC-Q200 | Resistors_SMD:R_0805 |  | R | /GateDriveSheet/ | /5802F342/ | 5806E5A8
http://www.mouser.com/ProductDetail/Vishay-Draloric/CRCW080510R0FKEAHP/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 | Y | R7 | 10 | Thick Film Resistors - SMD 1/2watt 10ohms 1% High Power AEC-Q200 | Resistors_SMD:R_0805 |  | R | /GateDriveSheet/ | /5802F342/ | 58070691
http://www.mouser.com/ProductDetail/Vishay-Draloric/CRCW080510R0FKEAHP/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 | Y | R8 | 10 | Thick Film Resistors - SMD 1/2watt 10ohms 1% High Power AEC-Q200 | Resistors_SMD:R_0805 |  | R | /GateDriveSheet/ | /5802F342/ | 58070697
http://www.mouser.com/ProductDetail/Panasonic/ERJ-P06J220V/?qs=sGAEpiMZZMu61qfTUdNhG5rFB6Qizrus3R51PmrkmB4%3d | Y | R88 | 22 | Thick Film Resistors - SMD 0805 22ohms 0.5W 5% AEC-Q200 | Resistors_SMD:R_0805 |  | R | /AnalogSenseSheet/ | /5802F349/ | 587F38E6
http://www.mouser.com/ProductDetail/Vishay-Draloric/CRCW080510R0FKEAHP/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 | Y | R9 | 10 | Thick Film Resistors - SMD 1/2watt 10ohms 1% High Power AEC-Q200 | Resistors_SMD:R_0805 |  | R | /GateDriveSheet/ | /5802F342/ | 580706A7
http://www.mouser.com/ProductDetail/Vishay-Draloric/CRCW08050000Z0EAHP/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 | Y | Rg_OFF1 | 0 | Thick Film Resistors - SMD 1/2W Zeroohm Jumper High Power AEC-Q200 | Resistors_SMD:R_0805 |  | R | /GateDriveSheet/ | /5802F342/ | 5803F1D9
http://www.mouser.com/ProductDetail/Vishay-Draloric/CRCW08050000Z0EAHP/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 | Y | Rg_OFF2 | 0 | Thick Film Resistors - SMD 1/2W Zeroohm Jumper High Power AEC-Q201 | Resistors_SMD:R_0805 |  | R | /GateDriveSheet/ | /5802F342/ | 5806E62A
http://www.mouser.com/ProductDetail/Vishay-Draloric/CRCW08050000Z0EAHP/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 | Y | Rg_OFF3 | 0 | Thick Film Resistors - SMD 1/2W Zeroohm Jumper High Power AEC-Q202 | Resistors_SMD:R_0805 |  | R | /GateDriveSheet/ | /5802F342/ | 58070722
http://www.mouser.com/ProductDetail/Vishay-Draloric/CRCW080510R0FKEAHP/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 | Y | Rg_ON1 | 10 | Thick Film Resistors - SMD 1/2watt 10ohms 1% High Power AEC-Q200 | Resistors_SMD:R_0805 |  | R | /GateDriveSheet/ | /5802F342/ | 5803F0BF
http://www.mouser.com/ProductDetail/Vishay-Draloric/CRCW080510R0FKEAHP/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 | Y | Rg_ON2 | 10 | Thick Film Resistors - SMD 1/2watt 10ohms 1% High Power AEC-Q200 | Resistors_SMD:R_0805 |  | R | /GateDriveSheet/ | /5802F342/ | 5803F171
http://www.mouser.com/ProductDetail/Vishay-Draloric/CRCW080510R0FKEAHP/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 | Y | Rg_ON3 | 10 | Thick Film Resistors - SMD 1/2watt 10ohms 1% High Power AEC-Q200 | Resistors_SMD:R_0805 |  | R | /GateDriveSheet/ | /5802F342/ | 5806E61E
http://www.mouser.com/ProductDetail/Vishay-Draloric/CRCW080510R0FKEAHP/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 | Y | Rg_ON4 | 10 | Thick Film Resistors - SMD 1/2watt 10ohms 1% High Power AEC-Q200 | Resistors_SMD:R_0805 |  | R | /GateDriveSheet/ | /5802F342/ | 5806E624
http://www.mouser.com/ProductDetail/Vishay-Draloric/CRCW080510R0FKEAHP/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 | Y | Rg_ON5 | 10 | Thick Film Resistors - SMD 1/2watt 10ohms 1% High Power AEC-Q200 | Resistors_SMD:R_0805 |  | R | /GateDriveSheet/ | /5802F342/ | 58070716
http://www.mouser.com/ProductDetail/Vishay-Draloric/CRCW080510R0FKEAHP/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 | Y | Rg_ON6 | 10 | Thick Film Resistors - SMD 1/2watt 10ohms 1% High Power AEC-Q200 | Resistors_SMD:R_0805 |  | R | /GateDriveSheet/ | /5802F342/ | 5807071C
http://www.mouser.com/ProductDetail/Vishay/CRCW0805100RFKEA/ | Y | Rsense1 | 100 | Thick Film Resistors - SMD 1/8watt 100ohms 1% 100ppm | Resistors_SMD:R_0805 |  | R | /AnalogSenseSheet/ | /5802F349/ | 58241C41
http://www.mouser.com/ProductDetail/Vishay-Draloric/CRCW080520K0FKEAHP/ | Y | Rsense2 | 20k | Thick Film Resistors - SMD 1/2watt 20Kohms 1% High Power AEC-Q200 | Resistors_SMD:R_0805 |  | R | /AnalogSenseSheet/ | /5802F349/ | 58266936
http://www.mouser.com/ProductDetail/Texas-Instruments/UCC21520DW/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 | Y | U1 | UCC21520DW | Gate Drivers 4A/6A, 5.7 kVrms Isolated Dual Channel Gate Driver 16-SOIC -40 to 125 | KicadPcbPackages:SOIC-16W_7.5x10.3mm_Pitch1.27mm |  | UCC21520DW | /GateDriveSheet/ | /5802F342/ | 580304BA
http://www.mouser.com/ProductDetail/Texas-Instruments/TLV70433DBVR/ | Y | U13 | TLV70433DBVR | LDO Voltage Regulators 150mAUltra-Low IQ High Vin LDO Reg | TO_SOT_Packages_SMD:SOT-23-5 |  | TLV70433DBVR | /Power_Inputs/ | /581F1F0E/ | 58221B44
http://www.mouser.com/ProductDetail/Texas-Instruments/REF2033AIDDCR/ | Y | U14 | REF2033AIDDCR | Voltage References Low-Drift, Lw-Pwr Dual Output Volt Ref | TO_SOT_Packages_SMD:SOT-23-5 |  | REF2033AIDDCR | /Power_Inputs/ | /581F1F0E/ | 582B9EFA
http://www.mouser.com/ProductDetail/Texas-Instruments/UCC21520DW/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 | Y | U2 | UCC21520DW | Gate Drivers 4A/6A, 5.7 kVrms Isolated Dual Channel Gate Driver 16-SOIC -40 to 125 | KicadPcbPackages:SOIC-16W_7.5x10.3mm_Pitch1.27mm |  | UCC21520DW | /GateDriveSheet/ | /5802F342/ | 5806E578
http://www.mouser.com/ProductDetail/Texas-Instruments/UCC21520DW/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 | Y | U3 | UCC21520DW | Gate Drivers 4A/6A, 5.7 kVrms Isolated Dual Channel Gate Driver 16-SOIC -40 to 125 | KicadPcbPackages:SOIC-16W_7.5x10.3mm_Pitch1.27mm |  | UCC21520DW | /GateDriveSheet/ | /5802F342/ | 58070679
http://www.mouser.com/ProductDetail/Texas-Instruments/AMC1301DWVR/ | Y | U4 | AMC1301DWVR | Isolation Amplifiers +/-250-mV Input 3-us Delay | KicadPcbPackages:SOIC-8-DWV |  | AMC1301DWVR | /AnalogSenseSheet/ | /5802F349/ | 58237AEA
http://www.mouser.com/ProductDetail/Texas-Instruments/OPA2320AIDGKR/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 | Y | U7 | OPA2320AIDGKR | Precision Amplifiers Prec20MHz0.9pA Ib RRIOCMOS Op Amp | KicadPcbPackages:VSSOP-8 |  | OPA2320AIDGKR | /AnalogSenseSheet/ | /5802F349/ | 5828517B
 |  |  |  |  |  |  |  |  |  |  | GateDriver_BLDC_MOSFET-cache | AMC1301DWVR | U | Reference
 |  |  |  |  |  |  |  |  |  |  | GateDriver_BLDC_MOSFET-cache | AMC1301DWVR | AMC1301DWVR | Value
 |  |  |  |  |  |  |  |  |  |  | GateDriver_BLDC_MOSFET-cache | AMC1301DWVR |  |  | 1 | VDD1 | input
 |  |  |  |  |  |  |  |  |  |  | GateDriver_BLDC_MOSFET-cache | AMC1301DWVR |  |  | 2 | VINP | input
 |  |  |  |  |  |  |  |  |  |  | GateDriver_BLDC_MOSFET-cache | AMC1301DWVR |  |  | 3 | VINN | input
 |  |  |  |  |  |  |  |  |  |  | GateDriver_BLDC_MOSFET-cache | AMC1301DWVR |  |  | 4 | GND1 | input
 |  |  |  |  |  |  |  |  |  |  | GateDriver_BLDC_MOSFET-cache | AMC1301DWVR |  |  | 5 | GND2 | input
 |  |  |  |  |  |  |  |  |  |  | GateDriver_BLDC_MOSFET-cache | AMC1301DWVR |  |  | 6 | VOUTN | input
 |  |  |  |  |  |  |  |  |  |  | GateDriver_BLDC_MOSFET-cache | AMC1301DWVR |  |  | 7 | VOUTP | input
 |  |  |  |  |  |  |  |  |  |  | GateDriver_BLDC_MOSFET-cache | AMC1301DWVR |  |  | 8 | VDD2 | input
 |  |  |  |  |  |  |  |  |  |  | device | C | C | Reference |  |  |  | Unpolarized capacitor
 |  |  |  |  |  |  |  |  |  |  | device | C | C | Value |  |  |  | Unpolarized capacitor
 |  |  |  |  |  |  |  |  |  |  | device | C |  |  | 1 | ~ | passive | Unpolarized capacitor
 |  |  |  |  |  |  |  |  |  |  | device | C |  |  | 2 | ~ | passive | Unpolarized capacitor
 |  |  |  |  |  |  |  |  |  |  | device | C |  |  |  |  |  | Unpolarized capacitor | C?
 |  |  |  |  |  |  |  |  |  |  | device | C |  |  |  |  |  | Unpolarized capacitor | C_????_*
 |  |  |  |  |  |  |  |  |  |  | device | C |  |  |  |  |  | Unpolarized capacitor | C_????
 |  |  |  |  |  |  |  |  |  |  | device | C |  |  |  |  |  | Unpolarized capacitor | SMD*_c
 |  |  |  |  |  |  |  |  |  |  | device | C |  |  |  |  |  | Unpolarized capacitor | Capacitor*
 |  |  |  |  |  |  |  |  |  |  | conn | CONN_01X02 | P | Reference |  |  |  | Connector, single row, 01x02
 |  |  |  |  |  |  |  |  |  |  | conn | CONN_01X02 | CONN_01X02 | Value |  |  |  | Connector, single row, 01x02
 |  |  |  |  |  |  |  |  |  |  | conn | CONN_01X02 |  |  | 1 | P1 | passive | Connector, single row, 01x02
 |  |  |  |  |  |  |  |  |  |  | conn | CONN_01X02 |  |  | 2 | P2 | passive | Connector, single row, 01x02
 |  |  |  |  |  |  |  |  |  |  | conn | CONN_01X02 |  |  |  |  |  | Connector, single row, 01x02 | Pin_Header_Straight_1X02
 |  |  |  |  |  |  |  |  |  |  | conn | CONN_01X02 |  |  |  |  |  | Connector, single row, 01x02 | Pin_Header_Angled_1X02
 |  |  |  |  |  |  |  |  |  |  | conn | CONN_01X02 |  |  |  |  |  | Connector, single row, 01x02 | Socket_Strip_Straight_1X02
 |  |  |  |  |  |  |  |  |  |  | conn | CONN_01X02 |  |  |  |  |  | Connector, single row, 01x02 | Socket_Strip_Angled_1X02
 |  |  |  |  |  |  |  |  |  |  | conn | CONN_01X03 | P | Reference |  |  |  | Connector, single row, 01x03
 |  |  |  |  |  |  |  |  |  |  | conn | CONN_01X03 | CONN_01X03 | Value |  |  |  | Connector, single row, 01x03
 |  |  |  |  |  |  |  |  |  |  | conn | CONN_01X03 |  |  | 1 | P1 | passive | Connector, single row, 01x03
 |  |  |  |  |  |  |  |  |  |  | conn | CONN_01X03 |  |  | 2 | P2 | passive | Connector, single row, 01x03
 |  |  |  |  |  |  |  |  |  |  | conn | CONN_01X03 |  |  | 3 | P3 | passive | Connector, single row, 01x03
 |  |  |  |  |  |  |  |  |  |  | conn | CONN_01X03 |  |  |  |  |  | Connector, single row, 01x03 | Pin_Header_Straight_1X03
 |  |  |  |  |  |  |  |  |  |  | conn | CONN_01X03 |  |  |  |  |  | Connector, single row, 01x03 | Pin_Header_Angled_1X03
 |  |  |  |  |  |  |  |  |  |  | conn | CONN_01X03 |  |  |  |  |  | Connector, single row, 01x03 | Socket_Strip_Straight_1X03
 |  |  |  |  |  |  |  |  |  |  | conn | CONN_01X03 |  |  |  |  |  | Connector, single row, 01x03 | Socket_Strip_Angled_1X03
 |  |  |  |  |  |  |  |  |  |  | device | C_Small | C | Reference |  |  |  | Unpolarized capacitor
 |  |  |  |  |  |  |  |  |  |  | device | C_Small | C_Small | Value |  |  |  | Unpolarized capacitor
 |  |  |  |  |  |  |  |  |  |  | device | C_Small |  |  | 1 | ~ | passive | Unpolarized capacitor
 |  |  |  |  |  |  |  |  |  |  | device | C_Small |  |  | 2 | ~ | passive | Unpolarized capacitor
 |  |  |  |  |  |  |  |  |  |  | device | C_Small |  |  |  |  |  | Unpolarized capacitor | C?
 |  |  |  |  |  |  |  |  |  |  | device | C_Small |  |  |  |  |  | Unpolarized capacitor | C_????_*
 |  |  |  |  |  |  |  |  |  |  | device | C_Small |  |  |  |  |  | Unpolarized capacitor | C_????
 |  |  |  |  |  |  |  |  |  |  | device | C_Small |  |  |  |  |  | Unpolarized capacitor | SMD*_c
 |  |  |  |  |  |  |  |  |  |  | device | C_Small |  |  |  |  |  | Unpolarized capacitor | Capacitor*
 |  |  |  |  |  |  |  |  |  |  | device | D_Schottky | D | Reference |  |  |  | Schottky diode
 |  |  |  |  |  |  |  |  |  |  | device | D_Schottky | D_Schottky | Value |  |  |  | Schottky diode
 |  |  |  |  |  |  |  |  |  |  | device | D_Schottky |  |  | 1 | K | passive | Schottky diode
 |  |  |  |  |  |  |  |  |  |  | device | D_Schottky |  |  | 2 | A | passive | Schottky diode
 |  |  |  |  |  |  |  |  |  |  | device | D_Schottky |  |  |  |  |  | Schottky diode | Diode_*
 |  |  |  |  |  |  |  |  |  |  | device | D_Schottky |  |  |  |  |  | Schottky diode | D-*
 |  |  |  |  |  |  |  |  |  |  | device | D_Schottky |  |  |  |  |  | Schottky diode | *SingleDiode
 |  |  |  |  |  |  |  |  |  |  | device | D_Schottky |  |  |  |  |  | Schottky diode | *_Diode_*
 |  |  |  |  |  |  |  |  |  |  | device | D_Schottky |  |  |  |  |  | Schottky diode | *SingleDiode*
 |  |  |  |  |  |  |  |  |  |  | device | D_Schottky |  |  |  |  |  | Schottky diode | D_*
 |  |  |  |  |  |  |  |  |  |  | GateDriver_BLDC_MOSFET-cache | F_Small | F | Reference
 |  |  |  |  |  |  |  |  |  |  | GateDriver_BLDC_MOSFET-cache | F_Small | F_Small | Value
 |  |  |  |  |  |  |  |  |  |  | GateDriver_BLDC_MOSFET-cache | F_Small |  |  | 1 | ~ | passive
 |  |  |  |  |  |  |  |  |  |  | GateDriver_BLDC_MOSFET-cache | F_Small |  |  | 2 | ~ | passive
 |  |  |  |  |  |  |  |  |  |  | GateDriver_BLDC_MOSFET-cache | F_Small |  |  |  |  |  |  | CP*
 |  |  |  |  |  |  |  |  |  |  | GateDriver_BLDC_MOSFET-cache | F_Small |  |  |  |  |  |  | SM*
 |  |  |  |  |  |  |  |  |  |  | device | Jumper_NC_Small | JP | Reference |  |  |  | Jumper, normally closed
 |  |  |  |  |  |  |  |  |  |  | device | Jumper_NC_Small | Jumper_NC_Small | Value |  |  |  | Jumper, normally closed
 |  |  |  |  |  |  |  |  |  |  | device | Jumper_NC_Small |  |  | 1 | 1 | passive | Jumper, normally closed
 |  |  |  |  |  |  |  |  |  |  | device | Jumper_NC_Small |  |  | 2 | 2 | passive | Jumper, normally closed
 |  |  |  |  |  |  |  |  |  |  | device | Jumper_NO_Small | JP | Reference |  |  |  | Jumper, normally open
 |  |  |  |  |  |  |  |  |  |  | device | Jumper_NO_Small | Jumper_NO_Small | Value |  |  |  | Jumper, normally open
 |  |  |  |  |  |  |  |  |  |  | device | Jumper_NO_Small |  |  | 1 | 1 | passive | Jumper, normally open
 |  |  |  |  |  |  |  |  |  |  | device | Jumper_NO_Small |  |  | 2 | 2 | passive | Jumper, normally open
 |  |  |  |  |  |  |  |  |  |  | la_55_p | LA_55_P | HallSense | Reference
 |  |  |  |  |  |  |  |  |  |  | la_55_p | LA_55_P | LA_55_P | Value
 |  |  |  |  |  |  |  |  |  |  | la_55_p | LA_55_P |  |  | 1 | +15V | input
 |  |  |  |  |  |  |  |  |  |  | la_55_p | LA_55_P |  |  | 2 | -15V | input
 |  |  |  |  |  |  |  |  |  |  | la_55_p | LA_55_P |  |  | 3 | M | output
 |  |  |  |  |  |  |  |  |  |  | device | L_Small | L | Reference |  |  |  | Inductor, small symbol
 |  |  |  |  |  |  |  |  |  |  | device | L_Small | L_Small | Value |  |  |  | Inductor, small symbol
 |  |  |  |  |  |  |  |  |  |  | device | L_Small |  |  | 1 | ~ | passive | Inductor, small symbol
 |  |  |  |  |  |  |  |  |  |  | device | L_Small |  |  | 2 | ~ | passive | Inductor, small symbol
 |  |  |  |  |  |  |  |  |  |  | device | L_Small |  |  |  |  |  | Inductor, small symbol | Choke_*
 |  |  |  |  |  |  |  |  |  |  | device | L_Small |  |  |  |  |  | Inductor, small symbol | *Coil*
 |  |  |  |  |  |  |  |  |  |  | GateDriver_BLDC_MOSFET-cache | OPA2320AIDGKR | U | Reference
 |  |  |  |  |  |  |  |  |  |  | GateDriver_BLDC_MOSFET-cache | OPA2320AIDGKR | OPA2320AIDGKR | Value
 |  |  |  |  |  |  |  |  |  |  | GateDriver_BLDC_MOSFET-cache | OPA2320AIDGKR |  |  | 1 | OutA | input
 |  |  |  |  |  |  |  |  |  |  | GateDriver_BLDC_MOSFET-cache | OPA2320AIDGKR |  |  | 2 | -InA | input
 |  |  |  |  |  |  |  |  |  |  | GateDriver_BLDC_MOSFET-cache | OPA2320AIDGKR |  |  | 3 | +InA | input
 |  |  |  |  |  |  |  |  |  |  | GateDriver_BLDC_MOSFET-cache | OPA2320AIDGKR |  |  | 4 | V- | input
 |  |  |  |  |  |  |  |  |  |  | GateDriver_BLDC_MOSFET-cache | OPA2320AIDGKR |  |  | 5 | +InB | input
 |  |  |  |  |  |  |  |  |  |  | GateDriver_BLDC_MOSFET-cache | OPA2320AIDGKR |  |  | 6 | -InB | input
 |  |  |  |  |  |  |  |  |  |  | GateDriver_BLDC_MOSFET-cache | OPA2320AIDGKR |  |  | 7 | OutB | input
 |  |  |  |  |  |  |  |  |  |  | GateDriver_BLDC_MOSFET-cache | OPA2320AIDGKR |  |  | 8 | V+ | input
 |  |  |  |  |  |  |  |  |  |  | GateDriver_BLDC_MOSFET-cache | PowerPin | Pin | Reference
 |  |  |  |  |  |  |  |  |  |  | GateDriver_BLDC_MOSFET-cache | PowerPin | PowerPin | Value
 |  |  |  |  |  |  |  |  |  |  | GateDriver_BLDC_MOSFET-cache | PowerPin |  |  | 1 | Power | input
 |  |  |  |  |  |  |  |  |  |  | GateDriver_BLDC_MOSFET-cache | PowerPin |  |  | ?? | Power | input
 |  |  |  |  |  |  |  |  |  |  | device | R | R | Reference |  |  |  | Resistor
 |  |  |  |  |  |  |  |  |  |  | device | R | R | Value |  |  |  | Resistor
 |  |  |  |  |  |  |  |  |  |  | device | R |  |  | 1 | ~ | passive | Resistor
 |  |  |  |  |  |  |  |  |  |  | device | R |  |  | 2 | ~ | passive | Resistor
 |  |  |  |  |  |  |  |  |  |  | device | R |  |  |  |  |  | Resistor | R_*
 |  |  |  |  |  |  |  |  |  |  | device | R |  |  |  |  |  | Resistor | Resistor_*
 |  |  |  |  |  |  |  |  |  |  | GateDriver_BLDC_MOSFET-cache | REF2033AIDDCR | U | Reference
 |  |  |  |  |  |  |  |  |  |  | GateDriver_BLDC_MOSFET-cache | REF2033AIDDCR | REF2033AIDDCR | Value
 |  |  |  |  |  |  |  |  |  |  | GateDriver_BLDC_MOSFET-cache | REF2033AIDDCR |  |  | 1 | VBIAS | input
 |  |  |  |  |  |  |  |  |  |  | GateDriver_BLDC_MOSFET-cache | REF2033AIDDCR |  |  | 2 | GND | input
 |  |  |  |  |  |  |  |  |  |  | GateDriver_BLDC_MOSFET-cache | REF2033AIDDCR |  |  | 3 | EN | input
 |  |  |  |  |  |  |  |  |  |  | GateDriver_BLDC_MOSFET-cache | REF2033AIDDCR |  |  | 4 | VIN | input
 |  |  |  |  |  |  |  |  |  |  | GateDriver_BLDC_MOSFET-cache | REF2033AIDDCR |  |  | 5 | VREF | input
 |  |  |  |  |  |  |  |  |  |  | conn | TEST_1P | W | Reference |  |  |  | point
 |  |  |  |  |  |  |  |  |  |  | conn | TEST_1P | TEST_1P | Value |  |  |  | point
 |  |  |  |  |  |  |  |  |  |  | conn | TEST_1P |  |  | 1 | 1 | passive | point
 |  |  |  |  |  |  |  |  |  |  | GateDriver_BLDC_MOSFET-cache | TLV70433DBVR | U | Reference
 |  |  |  |  |  |  |  |  |  |  | GateDriver_BLDC_MOSFET-cache | TLV70433DBVR | TLV70433DBVR | Value
 |  |  |  |  |  |  |  |  |  |  | GateDriver_BLDC_MOSFET-cache | TLV70433DBVR |  |  | 1 | GND | input
 |  |  |  |  |  |  |  |  |  |  | GateDriver_BLDC_MOSFET-cache | TLV70433DBVR |  |  | 2 | IN | input
 |  |  |  |  |  |  |  |  |  |  | GateDriver_BLDC_MOSFET-cache | TLV70433DBVR |  |  | 3 | OUT | input
 |  |  |  |  |  |  |  |  |  |  | GateDriver_BLDC_MOSFET-cache | TLV70433DBVR |  |  | 4 | NC1 | NotConnected
 |  |  |  |  |  |  |  |  |  |  | GateDriver_BLDC_MOSFET-cache | TLV70433DBVR |  |  | 5 | NC1 | NotConnected
 |  |  |  |  |  |  |  |  |  |  | boosterpack | Ti_Booster_40_J1 | J | Reference
 |  |  |  |  |  |  |  |  |  |  | boosterpack | Ti_Booster_40_J1 | Ti_Booster_40_J1 | Value
 |  |  |  |  |  |  |  |  |  |  | boosterpack | Ti_Booster_40_J1 |  |  | 1 | 1.01/Vcc | power_out
 |  |  |  |  |  |  |  |  |  |  | boosterpack | Ti_Booster_40_J1 |  |  | 2 | 1.02/PB5 | BiDi
 |  |  |  |  |  |  |  |  |  |  | boosterpack | Ti_Booster_40_J1 |  |  | 3 | 1.03/PB0/Rxd | BiDi
 |  |  |  |  |  |  |  |  |  |  | boosterpack | Ti_Booster_40_J1 |  |  | 4 | 1.04/PB1/TxD | BiDi
 |  |  |  |  |  |  |  |  |  |  | boosterpack | Ti_Booster_40_J1 |  |  | 5 | 1.05/PE4 | BiDi
 |  |  |  |  |  |  |  |  |  |  | boosterpack | Ti_Booster_40_J1 |  |  | 6 | 1.06/PE5 | BiDi
 |  |  |  |  |  |  |  |  |  |  | boosterpack | Ti_Booster_40_J1 |  |  | 7 | 1.07/PB4 | BiDi
 |  |  |  |  |  |  |  |  |  |  | boosterpack | Ti_Booster_40_J1 |  |  | 8 | 1.08/PA5 | BiDi
 |  |  |  |  |  |  |  |  |  |  | boosterpack | Ti_Booster_40_J1 |  |  | 9 | 1.09/PA6 | BiDi
 |  |  |  |  |  |  |  |  |  |  | boosterpack | Ti_Booster_40_J1 |  |  | 10 | 1.10/PA7 | BiDi
 |  |  |  |  |  |  |  |  |  |  | boosterpack | Ti_Booster_40_J2 | J | Reference
 |  |  |  |  |  |  |  |  |  |  | boosterpack | Ti_Booster_40_J2 | Ti_Booster_40_J2 | Value
 |  |  |  |  |  |  |  |  |  |  | boosterpack | Ti_Booster_40_J2 |  |  | 1 | 2.01/GND | power_out
 |  |  |  |  |  |  |  |  |  |  | boosterpack | Ti_Booster_40_J2 |  |  | 2 | 2.02/PB2 | BiDi
 |  |  |  |  |  |  |  |  |  |  | boosterpack | Ti_Booster_40_J2 |  |  | 3 | 2.03/PE0 | BiDi
 |  |  |  |  |  |  |  |  |  |  | boosterpack | Ti_Booster_40_J2 |  |  | 4 | 2.04/PF0 | BiDi
 |  |  |  |  |  |  |  |  |  |  | boosterpack | Ti_Booster_40_J2 |  |  | 5 | 2.05/RESET | BiDi
 |  |  |  |  |  |  |  |  |  |  | boosterpack | Ti_Booster_40_J2 |  |  | 6 | 2.06/PB7 | BiDi
 |  |  |  |  |  |  |  |  |  |  | boosterpack | Ti_Booster_40_J2 |  |  | 7 | 2.07/PB6 | BiDi
 |  |  |  |  |  |  |  |  |  |  | boosterpack | Ti_Booster_40_J2 |  |  | 8 | 2.08/PA4 | BiDi
 |  |  |  |  |  |  |  |  |  |  | boosterpack | Ti_Booster_40_J2 |  |  | 9 | 2.09/PA3 | BiDi
 |  |  |  |  |  |  |  |  |  |  | boosterpack | Ti_Booster_40_J2 |  |  | 10 | 2.10/PA2 | BiDi
 |  |  |  |  |  |  |  |  |  |  | boosterpack | Ti_Booster_40_J3 | J | Reference
 |  |  |  |  |  |  |  |  |  |  | boosterpack | Ti_Booster_40_J3 | Ti_Booster_40_J3 | Value
 |  |  |  |  |  |  |  |  |  |  | boosterpack | Ti_Booster_40_J3 |  |  | 1 | 3.01/+5V | power_out
 |  |  |  |  |  |  |  |  |  |  | boosterpack | Ti_Booster_40_J3 |  |  | 2 | 3.02/GND | BiDi
 |  |  |  |  |  |  |  |  |  |  | boosterpack | Ti_Booster_40_J3 |  |  | 3 | 3.03/PD0 | BiDi
 |  |  |  |  |  |  |  |  |  |  | boosterpack | Ti_Booster_40_J3 |  |  | 4 | 3.04/PD1 | BiDi
 |  |  |  |  |  |  |  |  |  |  | boosterpack | Ti_Booster_40_J3 |  |  | 5 | 3.05/PD2 | BiDi
 |  |  |  |  |  |  |  |  |  |  | boosterpack | Ti_Booster_40_J3 |  |  | 6 | 3.06/PD3 | BiDi
 |  |  |  |  |  |  |  |  |  |  | boosterpack | Ti_Booster_40_J3 |  |  | 7 | 3.07/PE1 | BiDi
 |  |  |  |  |  |  |  |  |  |  | boosterpack | Ti_Booster_40_J3 |  |  | 8 | 3.08/PE2 | BiDi
 |  |  |  |  |  |  |  |  |  |  | boosterpack | Ti_Booster_40_J3 |  |  | 9 | 3.09/PE3 | BiDi
 |  |  |  |  |  |  |  |  |  |  | boosterpack | Ti_Booster_40_J3 |  |  | 10 | 3.10/PF1 | BiDi
 |  |  |  |  |  |  |  |  |  |  | boosterpack | Ti_Booster_40_J4 | J | Reference
 |  |  |  |  |  |  |  |  |  |  | boosterpack | Ti_Booster_40_J4 | Ti_Booster_40_J4 | Value
 |  |  |  |  |  |  |  |  |  |  | boosterpack | Ti_Booster_40_J4 |  |  | 1 | 4.01/PF2 | BiDi
 |  |  |  |  |  |  |  |  |  |  | boosterpack | Ti_Booster_40_J4 |  |  | 2 | 4.02/PF3 | BiDi
 |  |  |  |  |  |  |  |  |  |  | boosterpack | Ti_Booster_40_J4 |  |  | 3 | 4.03/PB3 | BiDi
 |  |  |  |  |  |  |  |  |  |  | boosterpack | Ti_Booster_40_J4 |  |  | 4 | 4.04/PC4 | BiDi
 |  |  |  |  |  |  |  |  |  |  | boosterpack | Ti_Booster_40_J4 |  |  | 5 | 4.05/PC5 | BiDi
 |  |  |  |  |  |  |  |  |  |  | boosterpack | Ti_Booster_40_J4 |  |  | 6 | 4.06/PC6 | BiDi
 |  |  |  |  |  |  |  |  |  |  | boosterpack | Ti_Booster_40_J4 |  |  | 7 | 4.07/PC7 | BiDi
 |  |  |  |  |  |  |  |  |  |  | boosterpack | Ti_Booster_40_J4 |  |  | 8 | 4.08/PD6 | BiDi
 |  |  |  |  |  |  |  |  |  |  | boosterpack | Ti_Booster_40_J4 |  |  | 9 | 4.09/PD7 | BiDi
 |  |  |  |  |  |  |  |  |  |  | boosterpack | Ti_Booster_40_J4 |  |  | 10 | 4.10/PF4 | BiDi
 |  |  |  |  |  |  |  |  |  |  | GateDriver_BLDC_MOSFET-cache | UCC21520DW | U | Reference
 |  |  |  |  |  |  |  |  |  |  | GateDriver_BLDC_MOSFET-cache | UCC21520DW | UCC21520DW | Value
 |  |  |  |  |  |  |  |  |  |  | GateDriver_BLDC_MOSFET-cache | UCC21520DW |  |  | 1 | INA | input
 |  |  |  |  |  |  |  |  |  |  | GateDriver_BLDC_MOSFET-cache | UCC21520DW |  |  | 2 | INB | input
 |  |  |  |  |  |  |  |  |  |  | GateDriver_BLDC_MOSFET-cache | UCC21520DW |  |  | 3 | VCCI | input
 |  |  |  |  |  |  |  |  |  |  | GateDriver_BLDC_MOSFET-cache | UCC21520DW |  |  | 4 | GND | input
 |  |  |  |  |  |  |  |  |  |  | GateDriver_BLDC_MOSFET-cache | UCC21520DW |  |  | 5 | DISABLE | input
 |  |  |  |  |  |  |  |  |  |  | GateDriver_BLDC_MOSFET-cache | UCC21520DW |  |  | 6 | DeadTime | input
 |  |  |  |  |  |  |  |  |  |  | GateDriver_BLDC_MOSFET-cache | UCC21520DW |  |  | 8 | VCCI | input
 |  |  |  |  |  |  |  |  |  |  | GateDriver_BLDC_MOSFET-cache | UCC21520DW |  |  | 9 | VSSB | input
 |  |  |  |  |  |  |  |  |  |  | GateDriver_BLDC_MOSFET-cache | UCC21520DW |  |  | 10 | OUTB | output
 |  |  |  |  |  |  |  |  |  |  | GateDriver_BLDC_MOSFET-cache | UCC21520DW |  |  | 11 | VDDB | input
 |  |  |  |  |  |  |  |  |  |  | GateDriver_BLDC_MOSFET-cache | UCC21520DW |  |  | 14 | VSSA | input
 |  |  |  |  |  |  |  |  |  |  | GateDriver_BLDC_MOSFET-cache | UCC21520DW |  |  | 15 | OUTA | output
 |  |  |  |  |  |  |  |  |  |  | GateDriver_BLDC_MOSFET-cache | UCC21520DW |  |  | 16 | VDDA | input
 |  |  |  |  |  |  |  |  |  |  |  |  |  |  |  |  |  |  |  | device | C:\Program Files\KiCad\share\kicad\library\device.lib
 |  |  |  |  |  |  |  |  |  |  |  |  |  |  |  |  |  |  |  | conn | C:\Program Files\KiCad\share\kicad\library\conn.lib
 |  |  |  |  |  |  |  |  |  |  |  |  |  |  |  |  |  |  |  | la_55_p | C:\Users\Keith\Documents\GitHub\MotorController\Hardware\GateDriver_BLDC_MOSFET\Kicad_Custom_Libraries\la_55_p.lib
 |  |  |  |  |  |  |  |  |  |  |  |  |  |  |  |  |  |  |  | GateDriver_BLDC_MOSFET-cache | C:\Users\Keith\Documents\GitHub\MotorController\Hardware\GateDriver_BLDC_MOSFET\GateDriver_BLDC_MOSFET-cache.lib
 |  |  |  |  |  |  |  |  |  |  |  |  |  |  |  |  |  |  |  | boosterpack | C:\Users\Keith\Documents\GitHub\MotorController\Hardware\GateDriver_BLDC_MOSFET\boosterpack.lib
 |  |  |  |  |  |  |  |  |  |  |  |  |  |  |  |  |  |  |  |  |  | 1 | Net-(Dg_OFF1-Pad2) | Rg_OFF1 | 2
 |  |  |  |  |  |  |  |  |  |  |  |  |  |  |  |  |  |  |  |  |  | 1 | Net-(Dg_OFF1-Pad2) | Dg_OFF1 | 2
 |  |  |  |  |  |  |  |  |  |  |  |  |  |  |  |  |  |  |  |  |  | 2 | Net-(JP3-Pad2) | R11 | 1
 |  |  |  |  |  |  |  |  |  |  |  |  |  |  |  |  |  |  |  |  |  | 2 | Net-(JP3-Pad2) | U2 | 6
 |  |  |  |  |  |  |  |  |  |  |  |  |  |  |  |  |  |  |  |  |  | 2 | Net-(JP3-Pad2) | JP3 | 2
 |  |  |  |  |  |  |  |  |  |  |  |  |  |  |  |  |  |  |  |  |  | 3 | Net-(J4-Pad9) | R6 | 2
 |  |  |  |  |  |  |  |  |  |  |  |  |  |  |  |  |  |  |  |  |  | 3 | Net-(J4-Pad9) | J4 | 9
 |  |  |  |  |  |  |  |  |  |  |  |  |  |  |  |  |  |  |  |  |  | 4 | Net-(R6-Pad1) | R6 | 1
 |  |  |  |  |  |  |  |  |  |  |  |  |  |  |  |  |  |  |  |  |  | 4 | Net-(R6-Pad1) | U2 | 5
 |  |  |  |  |  |  |  |  |  |  |  |  |  |  |  |  |  |  |  |  |  | 5 | Net-(J4-Pad4) | R5 | 2
 |  |  |  |  |  |  |  |  |  |  |  |  |  |  |  |  |  |  |  |  |  | 5 | Net-(J4-Pad4) | J4 | 4
 |  |  |  |  |  |  |  |  |  |  |  |  |  |  |  |  |  |  |  |  |  | 6 | Net-(J4-Pad3) | R4 | 2
 |  |  |  |  |  |  |  |  |  |  |  |  |  |  |  |  |  |  |  |  |  | 6 | Net-(J4-Pad3) | J4 | 3
 |  |  |  |  |  |  |  |  |  |  |  |  |  |  |  |  |  |  |  |  |  | 7 | Net-(Gate_A_Top1-Pad1) | Rg_OFF1 | 1
 |  |  |  |  |  |  |  |  |  |  |  |  |  |  |  |  |  |  |  |  |  | 7 | Net-(Gate_A_Top1-Pad1) | Gate_A_Top1 | 1
 |  |  |  |  |  |  |  |  |  |  |  |  |  |  |  |  |  |  |  |  |  | 7 | Net-(Gate_A_Top1-Pad1) | Rg_ON1 | 1
 |  |  |  |  |  |  |  |  |  |  |  |  |  |  |  |  |  |  |  |  |  | 8 | Net-(C_boot2-Pad1) | D_boot2 | 1
 |  |  |  |  |  |  |  |  |  |  |  |  |  |  |  |  |  |  |  |  |  | 8 | Net-(C_boot2-Pad1) | U2 | 16
 |  |  |  |  |  |  |  |  |  |  |  |  |  |  |  |  |  |  |  |  |  | 8 | Net-(C_boot2-Pad1) | C_boot2 | 1
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
 |  |  |  |  |  |  |  |  |  |  |  |  |  |  |  |  |  |  |  |  |  | 122 | Net-(+/-15V_Input1-Pad3) | +/-15V_Input1 | 3
 |  |  |  |  |  |  |  |  |  |  |  |  |  |  |  |  |  |  |  |  |  | 122 | Net-(+/-15V_Input1-Pad3) | C106 | 2
 |  |  |  |  |  |  |  |  |  |  |  |  |  |  |  |  |  |  |  |  |  | 122 | Net-(+/-15V_Input1-Pad3) | C105 | 2
 |  |  |  |  |  |  |  |  |  |  |  |  |  |  |  |  |  |  |  |  |  | 123 | Net-(17V_Input1-Pad2) | 17V_Input1 | 2
 |  |  |  |  |  |  |  |  |  |  |  |  |  |  |  |  |  |  |  |  |  | 123 | Net-(17V_Input1-Pad2) | FerriteBead2 | 2
 |  |  |  |  |  |  |  |  |  |  |  |  |  |  |  |  |  |  |  |  |  | 123 | Net-(17V_Input1-Pad2) | C96 | 1
 |  |  |  |  |  |  |  |  |  |  |  |  |  |  |  |  |  |  |  |  |  | 123 | Net-(17V_Input1-Pad2) | C98 | 1
 |  |  |  |  |  |  |  |  |  |  |  |  |  |  |  |  |  |  |  |  |  | 123 | Net-(17V_Input1-Pad2) | C91 | 1
