ElectronicEnthusiast/ElectricSkateboard/Hardware/Mouser_Cart_Mar09_0848PM_Final_WithDoubleOfEachItem.xls

SHOPPING CART
This is not an invoice
Mar 09, 2017 20:57:15
 | Mouser # | Mfr. # | Manufacturer | Customer # | Description | RoHS | Lifecycle | Order Qty. | Price (USD) | Ext.: (USD)
1 | 894-SHHN000A3CL41Z | SHHN000A3CL41Z | GE (General Electric) |  | Isolated DC/DC Converters 9-36Vin, +/-15V out 9W Out | RoHS Compliant |  | 2 | $13.98 | $27.96
2 | 810-C2012X5R1H475K | C2012X5R1H475K125AB | TDK |  | Multilayer Ceramic Capacitors MLCC - SMD/SMT 0805 4.7uF 50volts X5R 10% | RoHS Compliant |  | 10 | $0.67 | $6.70
3 | 81-GRM21BR61E106MA3L | GRM21BR61E106MA73L | Murata |  | Multilayer Ceramic Capacitors MLCC - SMD/SMT 0805 10uF 25volts X5R 20% | RoHS Compliant |  | 30 | $0.085 | $2.55
4 | 80-C0805C100J5G | C0805C100J5GACTU | Kemet |  | Multilayer Ceramic Capacitors MLCC - SMD/SMT 50volts 10pF C0G 5% | RoHS Compliant |  | 20 | $0.035 | $0.70
5 | 80-C0805C104K5R | C0805C104K5RACTU | Kemet |  | Multilayer Ceramic Capacitors MLCC - SMD/SMT 50volts 0.1uF X7R 10% | RoHS Compliant |  | 40 | $0.027 | $1.08
6 | 80-C0805C103K5R | C0805C103K5RACTU | Kemet |  | Multilayer Ceramic Capacitors MLCC - SMD/SMT 50volts 10000pF X7R 10% | RoHS Compliant |  | 20 | $0.018 | $0.36
7 | 81-GRM21BR61E475MA2L | GRM21BR61E475MA12L | Murata |  | Multilayer Ceramic Capacitors MLCC - SMD/SMT 4.7uF 25Volts 20% | RoHS Compliant |  | 20 | $0.057 | $1.14
8 | 581-08051A152JAT2A | 08051A152JAT2A | AVX |  | Multilayer Ceramic Capacitors MLCC - SMD/SMT 100V 1500pF C0G 0805 5% Tol | RoHS Compliant | New Product | 6 | $0.15 | $0.90
9 | 80-C0805C181K5G | C0805C181K5GACTU | Kemet |  | Multilayer Ceramic Capacitors MLCC - SMD/SMT 50volts 180pF C0G 10% | RoHS Compliant |  | 2 | $0.10 | $0.20
10 | 78-VS-MBRS130L-M35BT | VS-MBRS130L-M3/5BT | Vishay |  | Schottky Diodes & Rectifiers 1A 30V Single Die Schottky Rectifier | RoHS Compliant | New At Mouser | 12 | $0.261 | $3.13
11 | 81-BLM31SN500SH1L | BLM31SN500SH1L | Murata |  | Ferrite Beads 1206 50ohms 12A DCR=.0016ohm AutoPWR | RoHS Compliant | New Product | 10 | $0.223 | $2.23
12 | 594-MFU1206FF01000P1 | MFU1206FF01000P100 | Vishay |  | Surface Mount Fuses 63V 1.0A Fast Act Very Quick | RoHS Compliant |  | 10 | $0.54 | $5.40
13 | 594-MFU1206FF05000P1 | MFU1206FF05000P100 | Vishay |  | Surface Mount Fuses 63V 5.0A Fast Act Very Quick | RoHS Compliant |  | 2 | $0.54 | $1.08
14 | 71-CRCW08052R20JNEAH | CRCW08052R20JNEAHP | Vishay |  | Thick Film Resistors - SMD 1/2watt 2.2ohms 5% High Power AEC-Q200 | RoHS Compliant By Exemption |  | 6 | $0.41 | $2.46
15 | 71-CRCW080510R0FKEAH | CRCW080510R0FKEAHP | Vishay |  | Thick Film Resistors - SMD 1/2watt 10ohms 1% High Power AEC-Q200 | RoHS Compliant By Exemption |  | 30 | $0.16 | $4.80
16 | 667-ERJ-6ENF1001V | ERJ-6ENF1001V | Panasonic |  | Thick Film Resistors - SMD 0805 1Kohms 1% AEC-Q200 | RoHS Compliant By Exemption |  | 20 | $0.022 | $0.44
17 | 755-KTR10EZPF1004 | KTR10EZPF1004 | ROHM Semiconductor |  | Thick Film Resistors - SMD 0805 1MOhm 1% High VoltageAEC-Q200 | RoHS Compliant | New Product | 10 | $0.154 | $1.54
18 | 667-ERJ-6ENF4992V | ERJ-6ENF4992V | Panasonic |  | Thick Film Resistors - SMD 0805 49.9Kohms 1% AEC-Q200 | RoHS Compliant By Exemption |  | 2 | $0.10 | $0.20
19 | 71-CRCW0805-4.12K-E3 | CRCW08054K12FKEA | Vishay |  | Thick Film Resistors - SMD 1/8watt 4.12Kohms 1% 100ppm | RoHS Compliant By Exemption |  | 2 | $0.10 | $0.20
20 | 71-CRCW080539R0FKEA | CRCW080539R0FKEA | Vishay |  | Thick Film Resistors - SMD 1/8watt 39ohms 1% | RoHS Compliant By Exemption |  | 4 | $0.10 | $0.40
21 | 71-CRCW0805J-4.7K-E3 | CRCW08054K70JNEA | Vishay |  | Thick Film Resistors - SMD 1/8watt 4.7Kohms 5% 200ppm | RoHS Compliant By Exemption |  | 20 | $0.042 | $0.84
22 | 71-CRCW0805-7.5K-E3 | CRCW08057K50FKEA | Vishay |  | Thick Film Resistors - SMD 1/8watt 7.5Kohms 1% 100ppm | RoHS Compliant By Exemption |  | 2 | $0.10 | $0.20
23 | 71-CRCW0805-100-E3 | CRCW0805100RFKEA | Vishay |  | Thick Film Resistors - SMD 1/8watt 100ohms 1% 100ppm | RoHS Compliant By Exemption |  | 20 | $0.049 | $0.98
24 | 667-ERJ-P06J220V | ERJ-P06J220V | Panasonic |  | Thick Film Resistors - SMD 0805 22ohms 0.5W 5% AEC-Q200 | RoHS Compliant By Exemption |  | 20 | $0.058 | $1.16
25 | 652-PTV09A4020SB103 | PTV09A-4020S-B103 | Bourns |  | Potentiometers PANEL CONTROL 9MM-ST-CARBON | RoHS Compliant |  | 6 | $0.81 | $4.86
26 | 71-CRCW08050000Z0EAH | CRCW08050000Z0EAHP | Vishay |  | Thick Film Resistors - SMD 1/2W Zeroohm Jumper High Power AEC-Q200 | RoHS Compliant By Exemption |  | 30 | $0.148 | $4.44
27 | 71-CRCW080520K0FKEAH | CRCW080520K0FKEAHP | Vishay |  | Thick Film Resistors - SMD 1/2watt 20Kohms 1% High Power AEC-Q200 | RoHS Compliant By Exemption |  | 5 | $0.29 | $1.45
28 | 595-UCC21520DW | UCC21520DW | Texas Instruments |  | Gate Drivers 4A/6A, 5.7 kVrms Isolated Dual Channel Gate Driver 16-SOIC -40 to 125 | RoHS Compliant | New Product | 7 | $6.17 | $43.19
29 | 595-REF2033AIDDCR | REF2033AIDDCR | Texas Instruments |  | Voltage References Low-Drift, Lw-Pwr Dual Output Volt Ref | RoHS Compliant |  | 3 | $3.33 | $9.99
30 | 595-AMC1301DWVR | AMC1301DWVR | Texas Instruments |  | Isolation Amplifiers +/-250-mV Input 3-us Delay | RoHS Compliant | New Product | 3 | $6.21 | $18.63
31 | 595-OPA2320AIDGKR | OPA2320AIDGKR | Texas Instruments |  | Precision Amplifiers Prec20MHz0.9pA Ib RRIOCMOS Op Amp | RoHS Compliant |  | 3 | $2.98 | $8.94
32 | 905-KBPC5006T | KBPC5006T | GeneSiC Semiconductor |  | Bridge Rectifiers 600 V - 50 A | RoHS Compliant |  | 1 | $5.23 | $5.23
By submitting your order you agree to these terms and conditions. (http://www.mouser.com/saleterms) |  |  |  |  |  |  |  |  | Merchandise Total: | $163.38
Prices are reflected at the date and time shown. |  |  |  |  |  |  |  |  | Shipping Charge: | Estimate
