ElectronicEnthusiast/ElectricSkateboard/(list of files, cad)

Other CAD files:
Software/IDDK_PM_Servo_F2837x-v2/F2837x_FLASH/resolver.obj
Software/IDDK_PM_Servo_F2837x-v2/F2837x_RAM/F2837xD_GlobalVariableDefs.obj
Software/IDDK_PM_Servo_F2837x-v2/F2837x_FLASH/IDDK_PM_Servo_F2837x.obj
Software/IDDK_PM_Servo_F2837x-v2/F2837x_RAM/resolver.obj
Software/IDDK_PM_Servo_F2837x-v2/F2837x_FLASH/bissc.obj
Software/IDDK_PM_Servo_F2837x-v2/F2837x_RAM/F2837xD_PieVect.obj
Software/IDDK_PM_Servo_F2837x-v2/F2837x_FLASH/F2837xD_PieCtrl.obj
Software/IDDK_PM_Servo_F2837x-v2/F2837x_RAM/endat.obj
Software/IDDK_PM_Servo_F2837x-v2/F2837x_FLASH/F2837xD_GlobalVariableDefs.obj
Software/IDDK_PM_Servo_F2837x-v2/F2837x_RAM/IDDK_PM_Servo_F2837x.obj
Software/IDDK_PM_Servo_F2837x-v2/F2837x_FLASH/F2837xD_Gpio.obj
Software/IDDK_PM_Servo_F2837x-v2/F2837x_RAM/F2837xD_DefaultISR.obj
Software/IDDK_PM_Servo_F2837x-v2/F2837x_FLASH/F2837xD_Adc.obj
Software/IDDK_PM_Servo_F2837x-v2/F2837x_RAM/F2837xD_Gpio.obj
Software/IDDK_PM_Servo_F2837x-v2/F2837x_FLASH/endat.obj
Software/IDDK_PM_Servo_F2837x-v2/F2837x_RAM/F2837xD_EPwm.obj
Software/IDDK_PM_Servo_F2837x-v2/F2837x_FLASH/F2837xD_sdfm_drivers.obj
Software/IDDK_PM_Servo_F2837x-v2/F2837x_RAM/F2837xD_SysCtrl.obj
Software/IDDK_PM_Servo_F2837x-v2/F2837x_FLASH/F2837xD_EPwm.obj
Software/IDDK_PM_Servo_F2837x-v2/F2837x_RAM/F2837xD_CodeStartBranch.obj
Software/IDDK_PM_Servo_F2837x-v2/F2837x_FLASH/F2837xD_DefaultISR.obj
Software/IDDK_PM_Servo_F2837x-v2/F2837x_RAM/F2837xD_sdfm_drivers.obj
Software/IDDK_PM_Servo_F2837x-v2/F2837x_FLASH/F2837xD_CodeStartBranch.obj
Software/IDDK_PM_Servo_F2837x-v2/F2837x_RAM/DLOG_4CH_F.obj
Software/IDDK_PM_Servo_F2837x-v2/F2837x_FLASH/F2837xD_SysCtrl.obj
Software/IDDK_PM_Servo_F2837x-v2/F2837x_RAM/bissc.obj
Software/IDDK_PM_Servo_F2837x-v2/F2837x_FLASH/DLOG_4CH_F.obj
Software/IDDK_PM_Servo_F2837x-v2/F2837x_RAM/F2837xD_Adc.obj
Software/IDDK_PM_Servo_F2837x-v2/F2837x_FLASH/F2837xD_usDelay.obj
Software/IDDK_PM_Servo_F2837x-v2/F2837x_RAM/F2837xD_PieCtrl.obj
Software/IDDK_PM_Servo_F2837x-v2/F2837x_FLASH/F2837xD_PieVect.obj
Software/IDDK_PM_Servo_F2837x-v2/F2837x_RAM/F2837xD_usDelay.obj
