ElectronicEnthusiast/ElectricSkateboard/Pictures/IDDK_V2_Level1_TestingSVPWM_DirectQuadratureTesting/Step1_ImportProjectIntoCCS.png

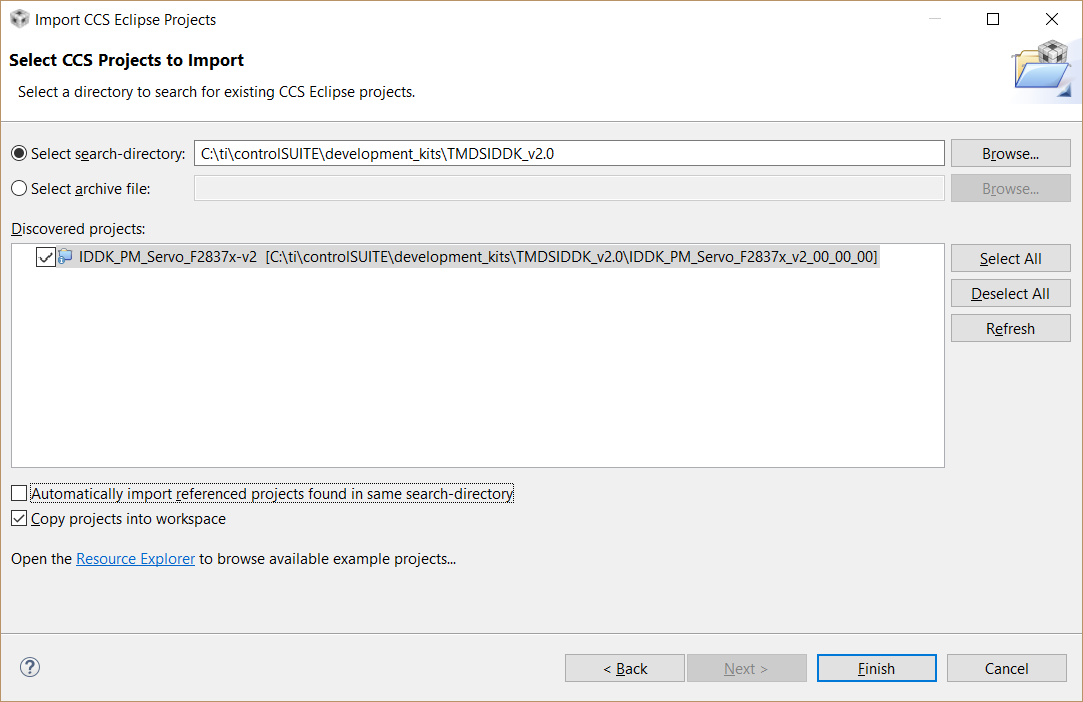
Pictures/IDDK_V2_Level1_TestingSVPWM_DirectQuadratureTesting/Step1_ImportProjectIntoCCS.png
