ElectronicEnthusiast/ElectricSkateboard/Pictures/IDDK_V2_Level1_TestingSVPWM_DirectQuadratureTesting/Step2_ProjectProperties_BuildSettings.png

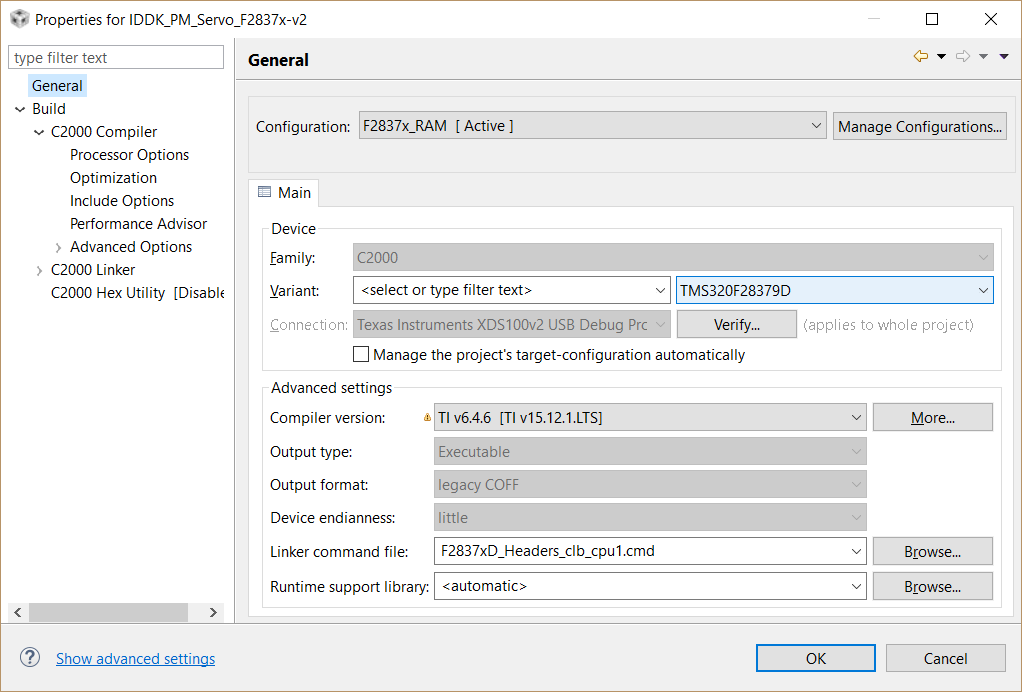
Pictures/IDDK_V2_Level1_TestingSVPWM_DirectQuadratureTesting/Step2_ProjectProperties_BuildSettings.png
