ElectronicEnthusiast/ElectricSkateboard/Pictures/IDDK_V2_Level1_TestingSVPWM_DirectQuadratureTesting/Step3_StrangeOutputFromOpenLoopPWMFor_IDDK_PM_Servo_F2837x-v2_UsingLaunchpadF28379D.png

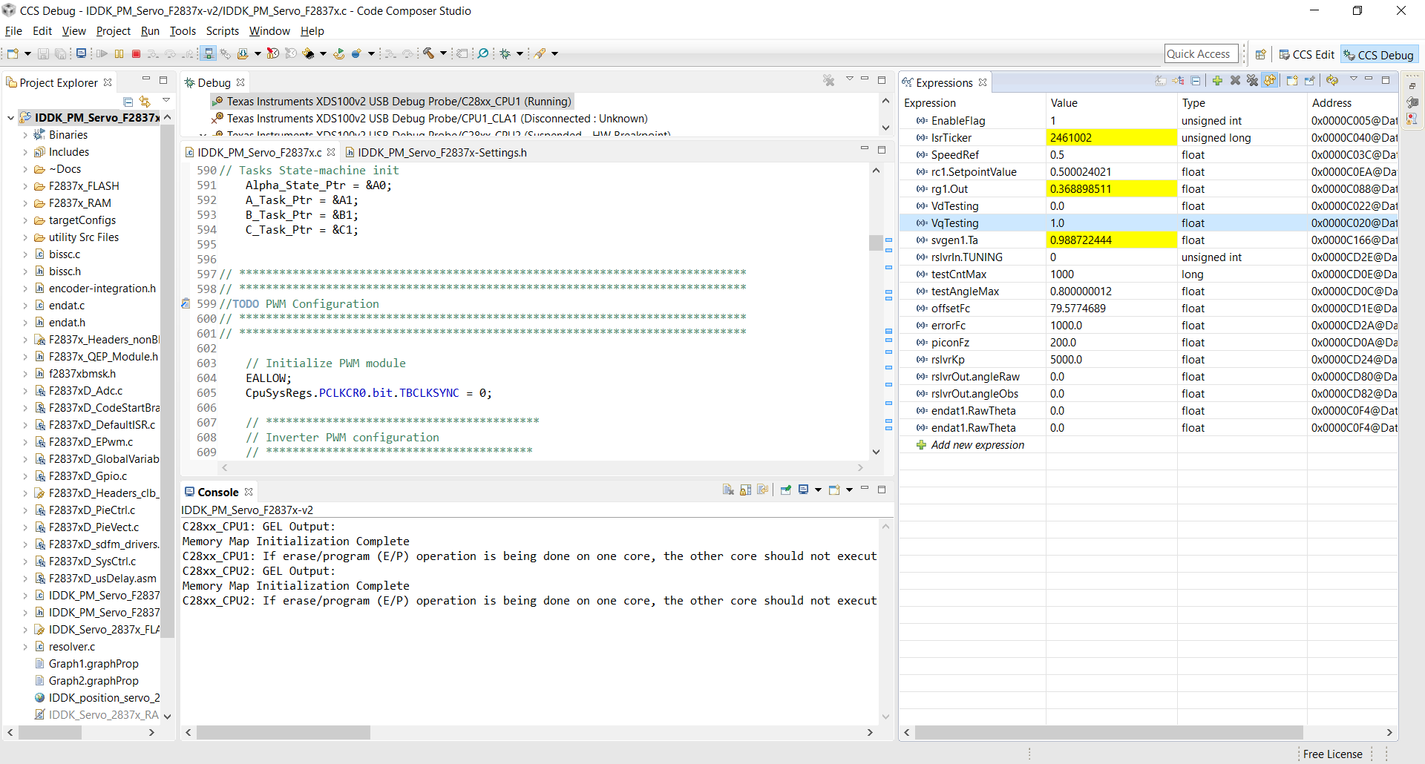
Pictures/IDDK_V2_Level1_TestingSVPWM_DirectQuadratureTesting/Step3_StrangeOutputFromOpenLoopPWMFor_IDDK_PM_Servo_F2837x-v2_UsingLaunchpadF28379D.png
