ElectronicEnthusiast/ElectricSkateboard/Pictures/IDDK_V2_Level2_TestingLEMCurrentSensing/WorkingLEM_CurrentSensing.png

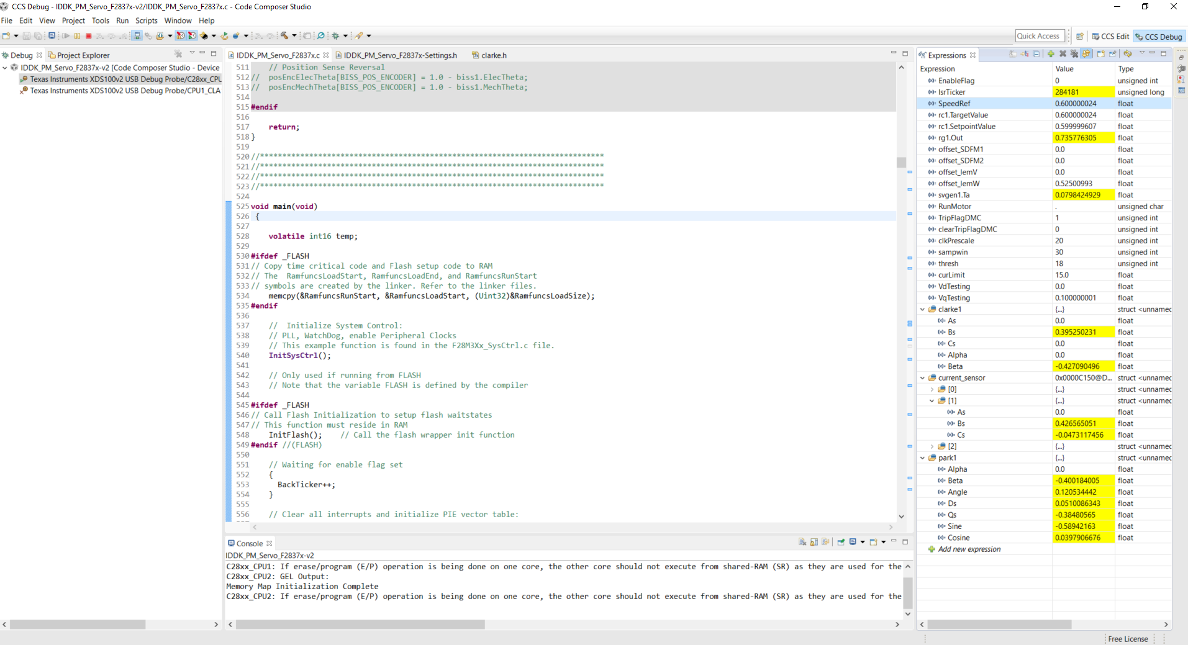
Pictures/IDDK_V2_Level2_TestingLEMCurrentSensing/WorkingLEM_CurrentSensing.png
