ElectronicEnthusiast/ElectricSkateboard/Pictures/LEM_CurrentSensorTestingWithScalingfor0To3.3V/LEMscalingFrom+-1.65V_To_0to3.3V_UsingMCP601opamp2.png

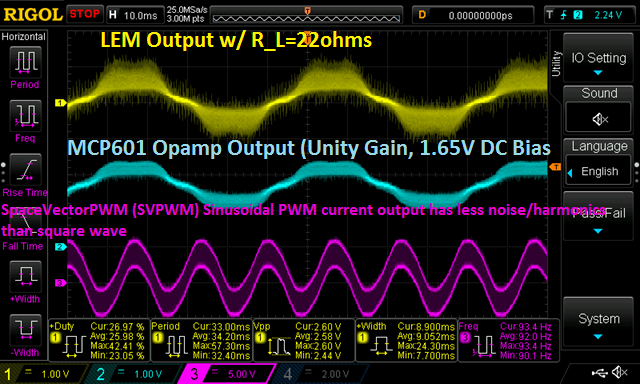
Pictures/LEM_CurrentSensorTestingWithScalingfor0To3.3V/LEMscalingFrom+-1.65V_To_0to3.3V_UsingMCP601opamp2.png
