ElectronicEnthusiast/ElectricSkateboard/Pictures/LEM_CurrentSensorTestingWithScalingfor0To3.3V/Schematic_TestingOpampDCoffsetWithLEMusingOPAMP.png

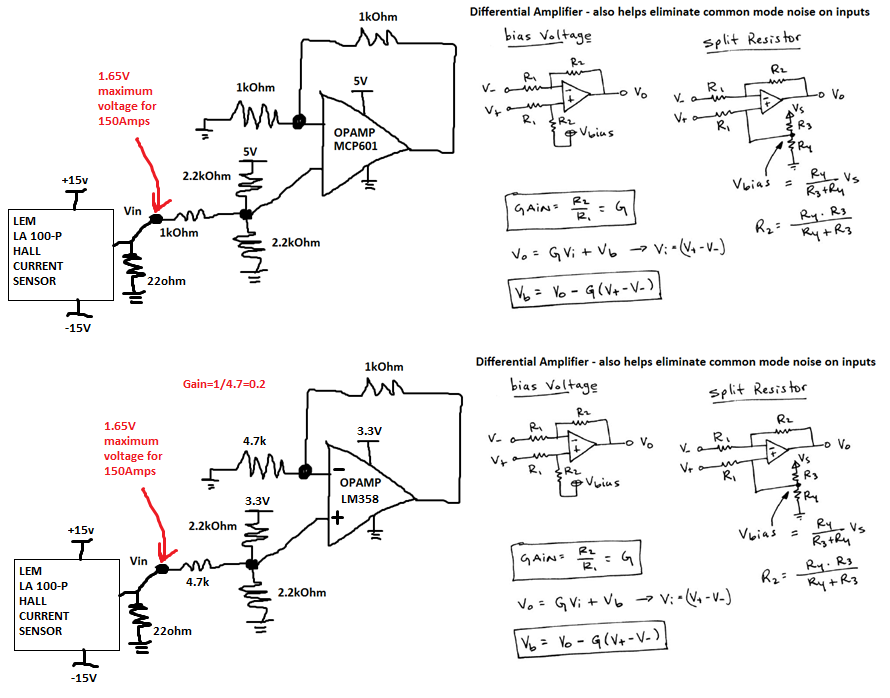
Pictures/LEM_CurrentSensorTestingWithScalingfor0To3.3V/Schematic_TestingOpampDCoffsetWithLEMusingOPAMP.png
