ElectronicEnthusiast/ElectricSkateboard/Hardware/DebuggingUCC21520WithTI/GateDriveSheet-GateDriveSheet.pdf

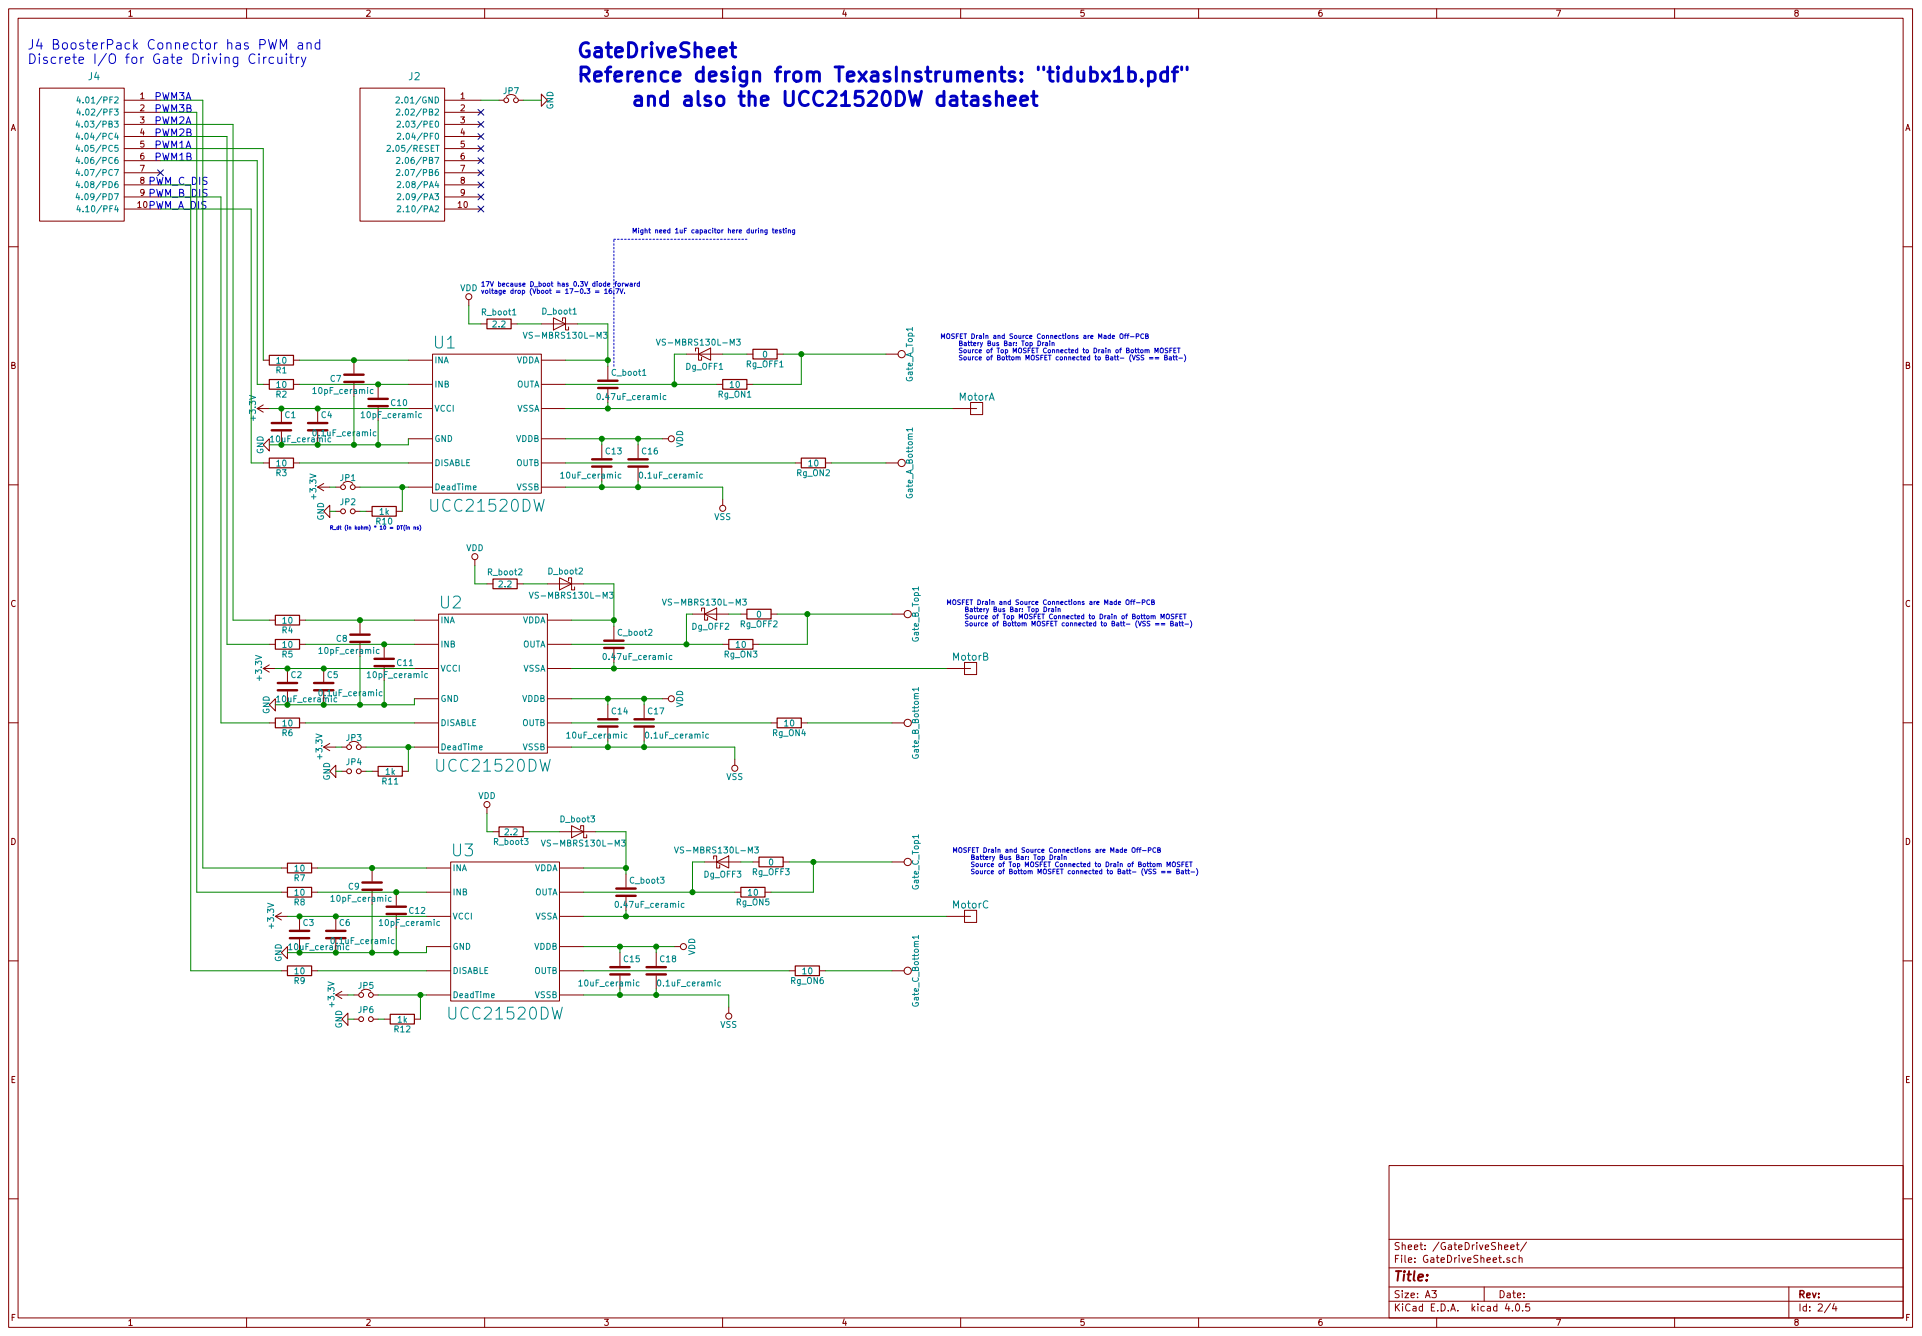
[picture p21: page 1]

Might need 1uF capacitor here during testing J4 BoosterPack Connector has PWM and
Discrete I/O for Gate Driving Circuitry

Reference design from TexasInstruments: "tidubx1b.pdf"
and also the UCC21520DW datasheet

VSS VDD VDD VDD

MOSFET Drain and Source Connections are Made Off-PCB
Battery Bus Bar: Top Drain
Source of Top MOSFET Connected to Drain of Bottom MOSFET

Source of Bottom MOSFET connected to Batt- (VSS == Batt-) MOSFET Drain and Source Connections are Made Off-PCB

Source of Bottom MOSFET connected to Batt- (VSS == Batt-)
