ElectronicEnthusiast/ElectricSkateboard/Hardware/GateDriver_BLDC_MOSFET_PDF/GateDriver_BLDC_MOSFET-F.SilkS.pdf

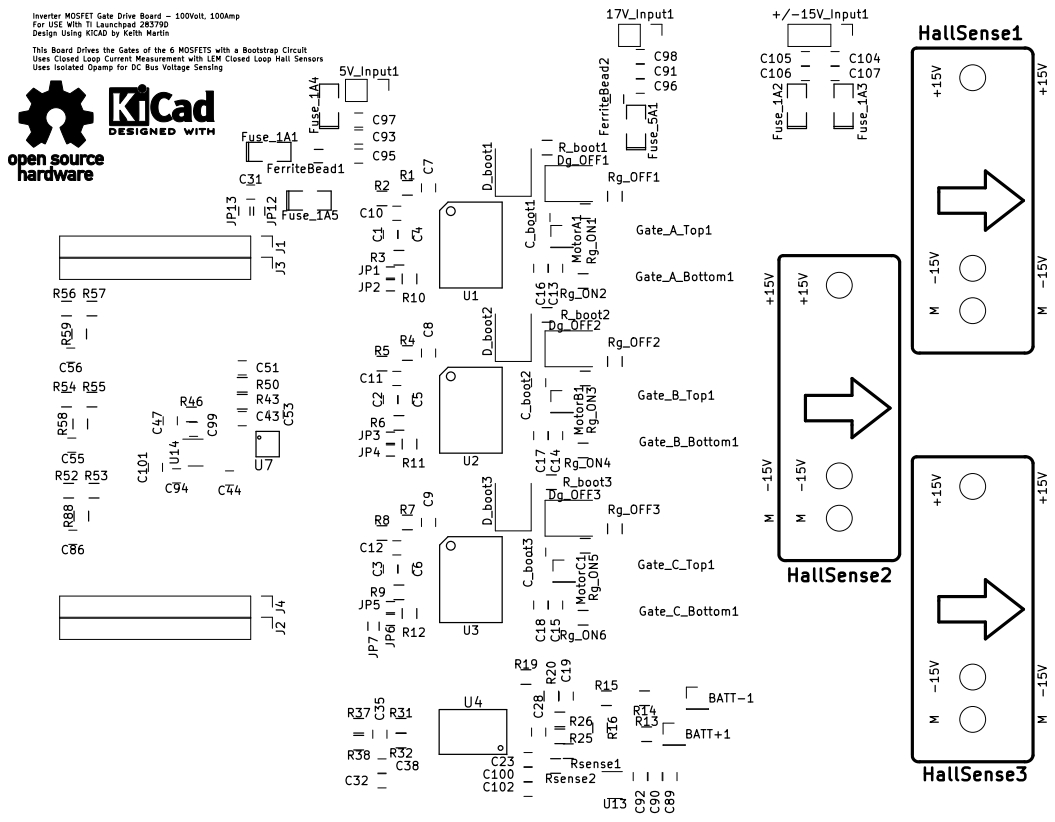
[picture p22: page 1]

Inverter MOSFET Gate Drive Board - 100Volt, 100Amp
For USE With TI Launchpad 28379D
Design Using KiCAD by Keith Martin
