ElectronicEnthusiast/ElectricSkateboard/Hardware/GateDriver_BLDC_MOSFET_PDF_Exports_V3.pdf

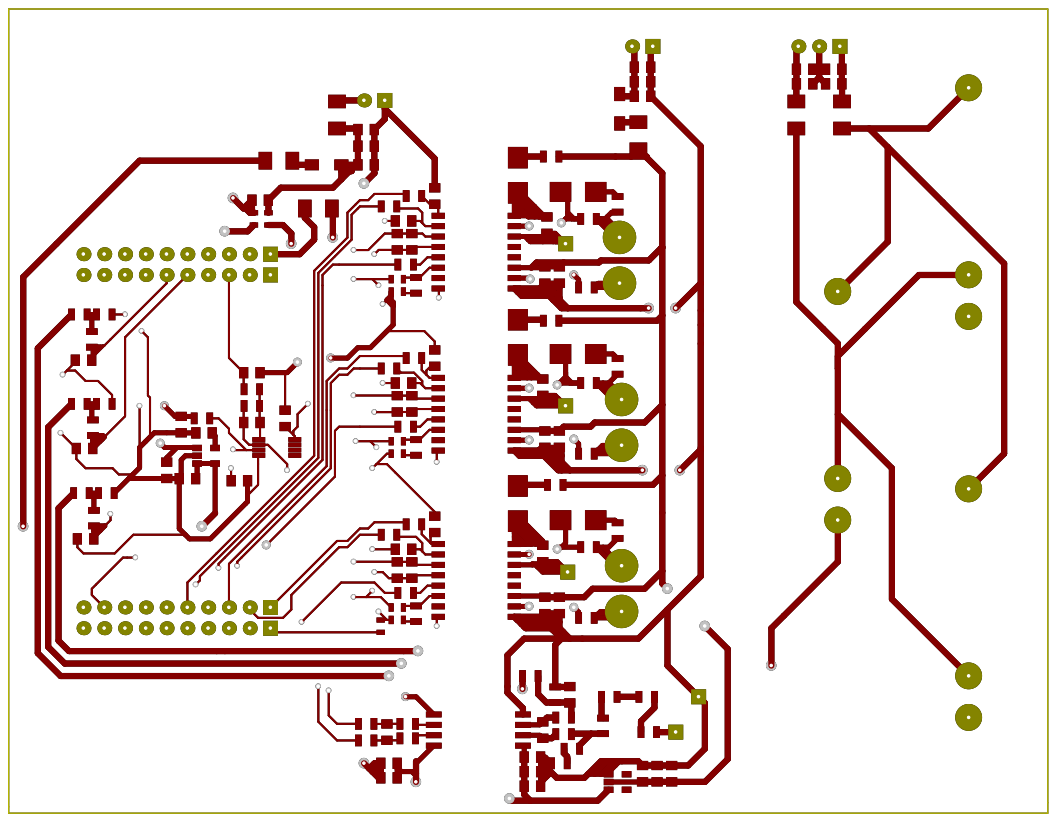
[picture p23: page 1]

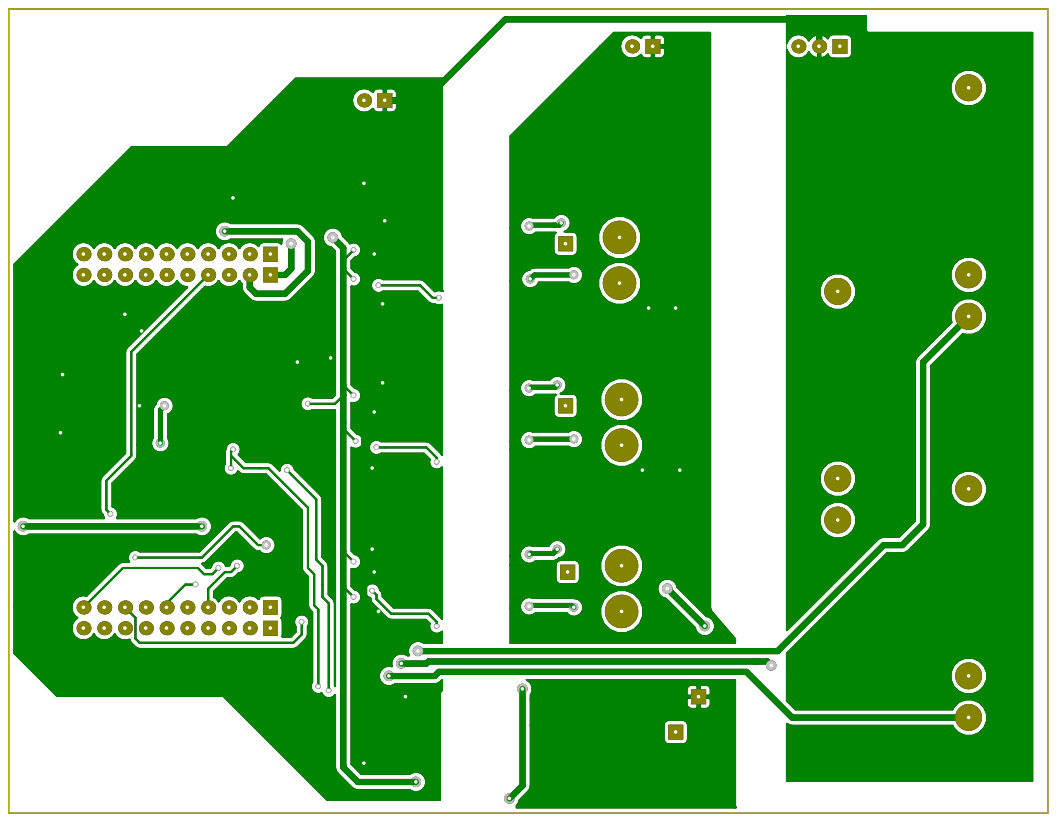
[picture p24: page 2]

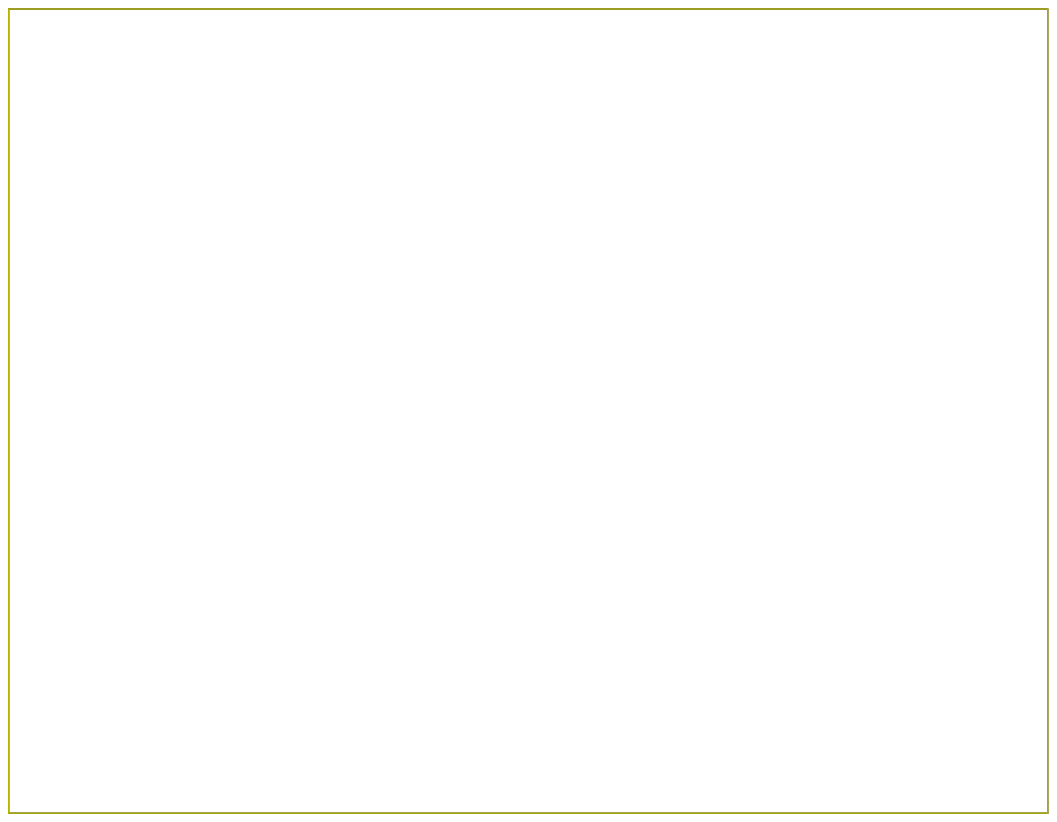
[picture p25: page 3]

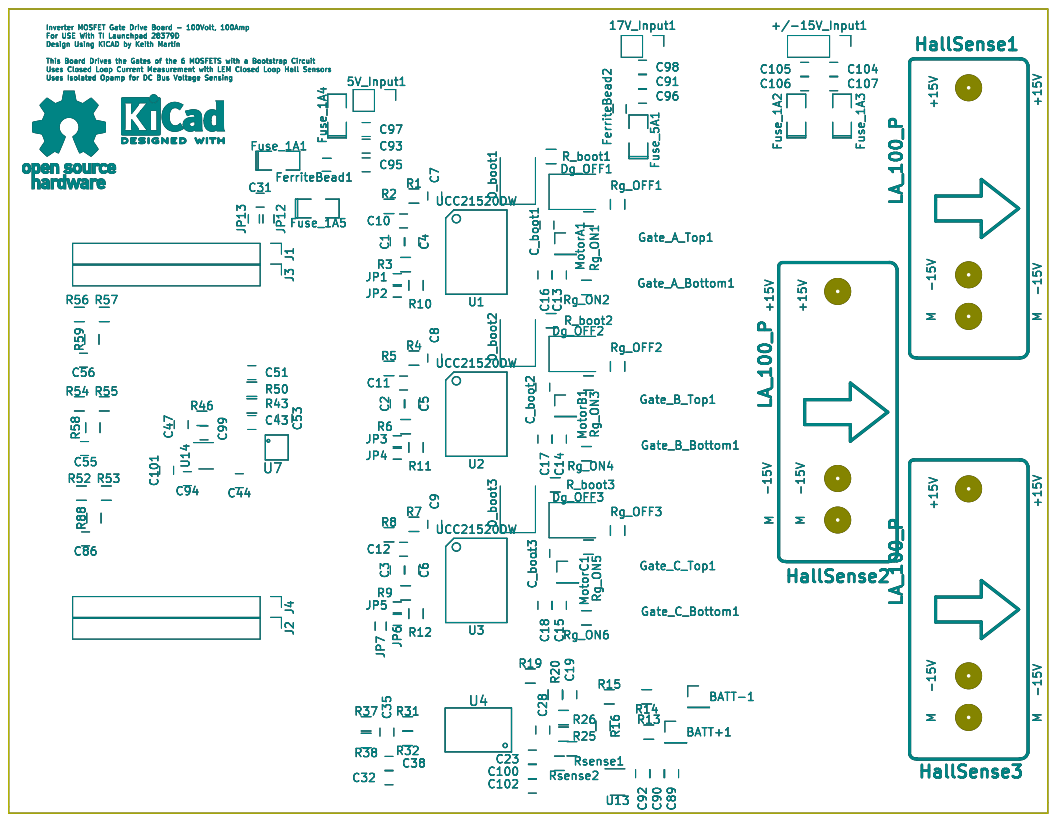
[picture p26: page 4]

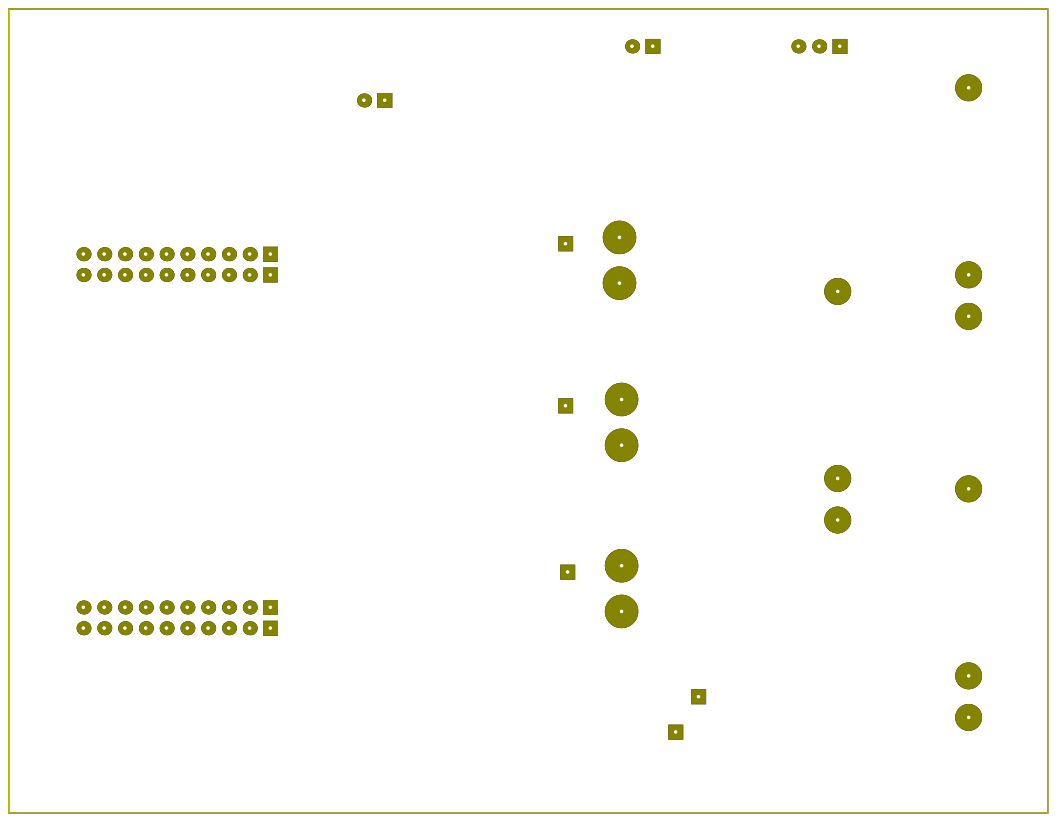
[picture p27: page 5]

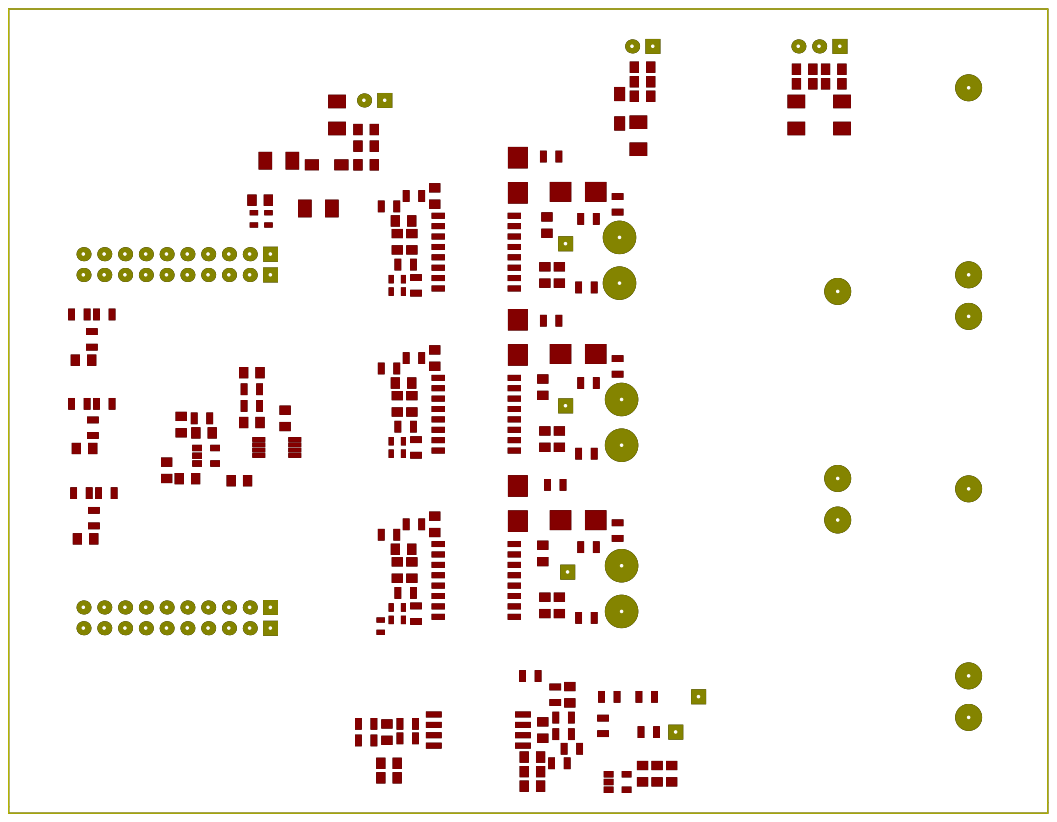
[picture p28: page 6]
