ElectronicEnthusiast/ElectricSkateboard/Hardware/GateDriver_BLDC_MOSFET_PDF/GateDriver_BLDC_MOSFET-B.Cu.pdf

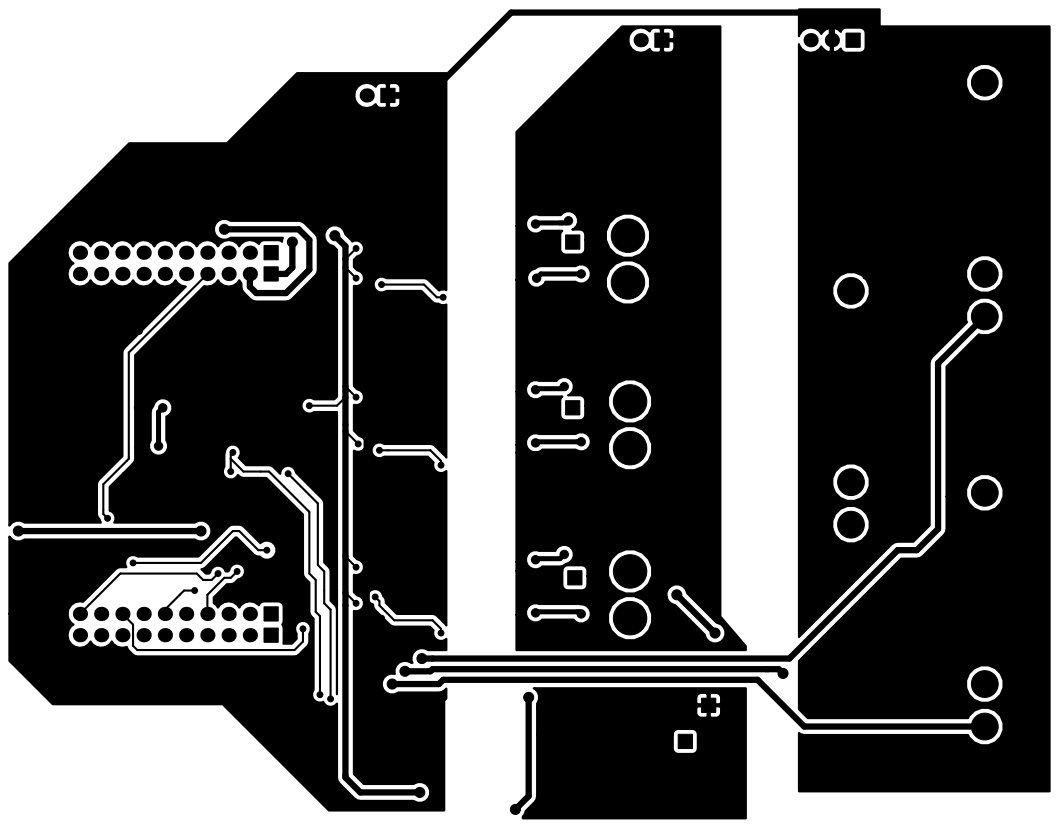
[picture p29: page 1]
