ElectronicEnthusiast/ElectricSkateboard/Hardware/GateDriver_BLDC_MOSFET_PDF/GateDriver_BLDC_MOSFET-B.Mask.pdf

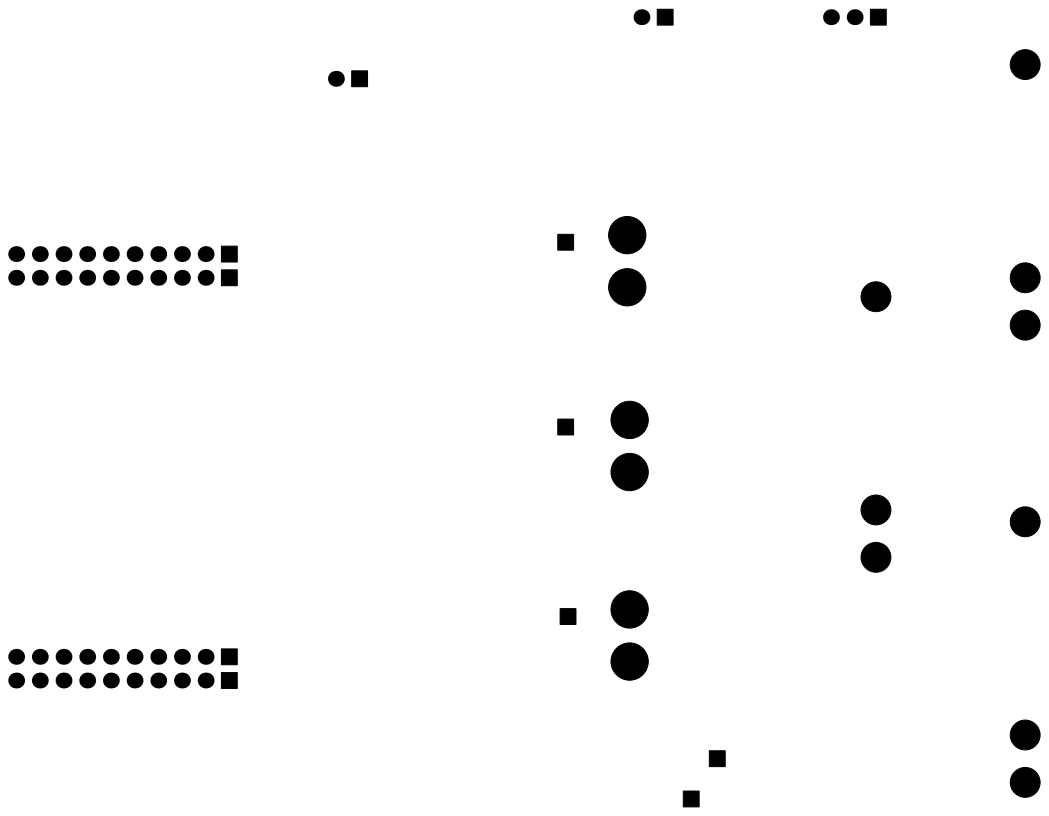
[picture p30: page 1]
