ElectronicEnthusiast/ElectricSkateboard/Hardware/GateDriver_BLDC_MOSFET_PDF/GateDriver_BLDC_MOSFET-F.Cu.pdf

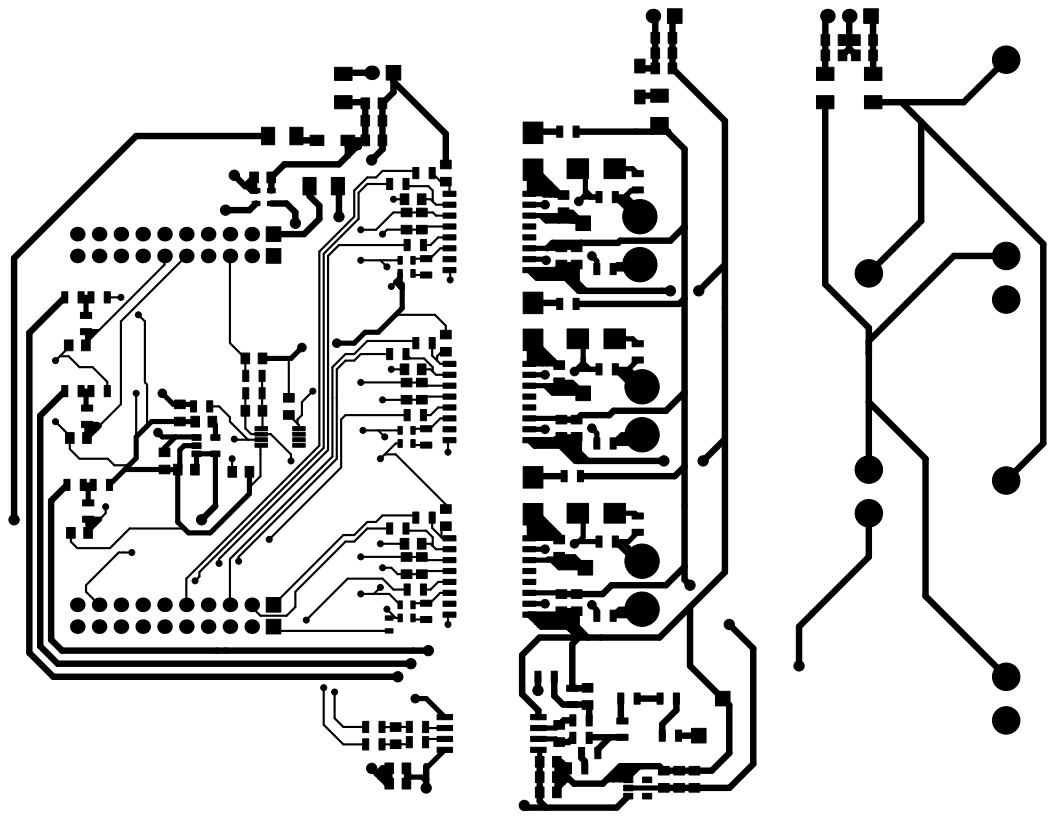
[picture p31: page 1]
