ElectronicEnthusiast/ElectricSkateboard/Hardware/GateDriver_BLDC_MOSFET_PDF_Exports_V2_old.pdf

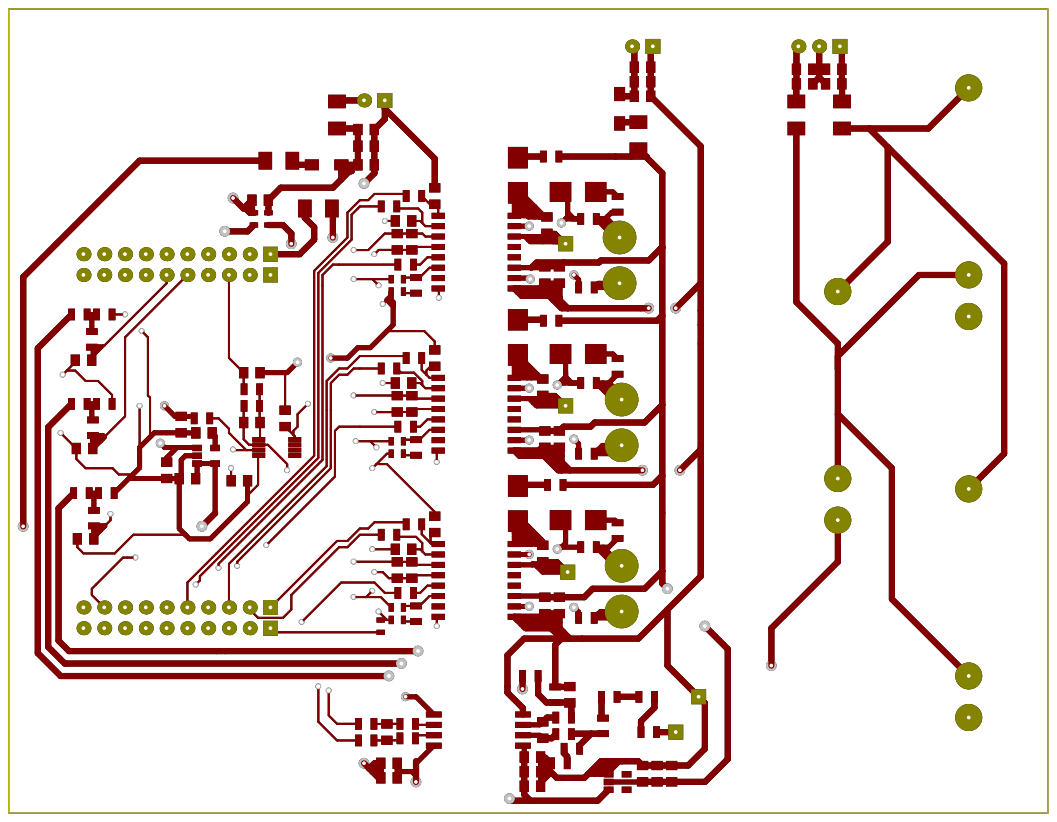
[picture p34: page 1]

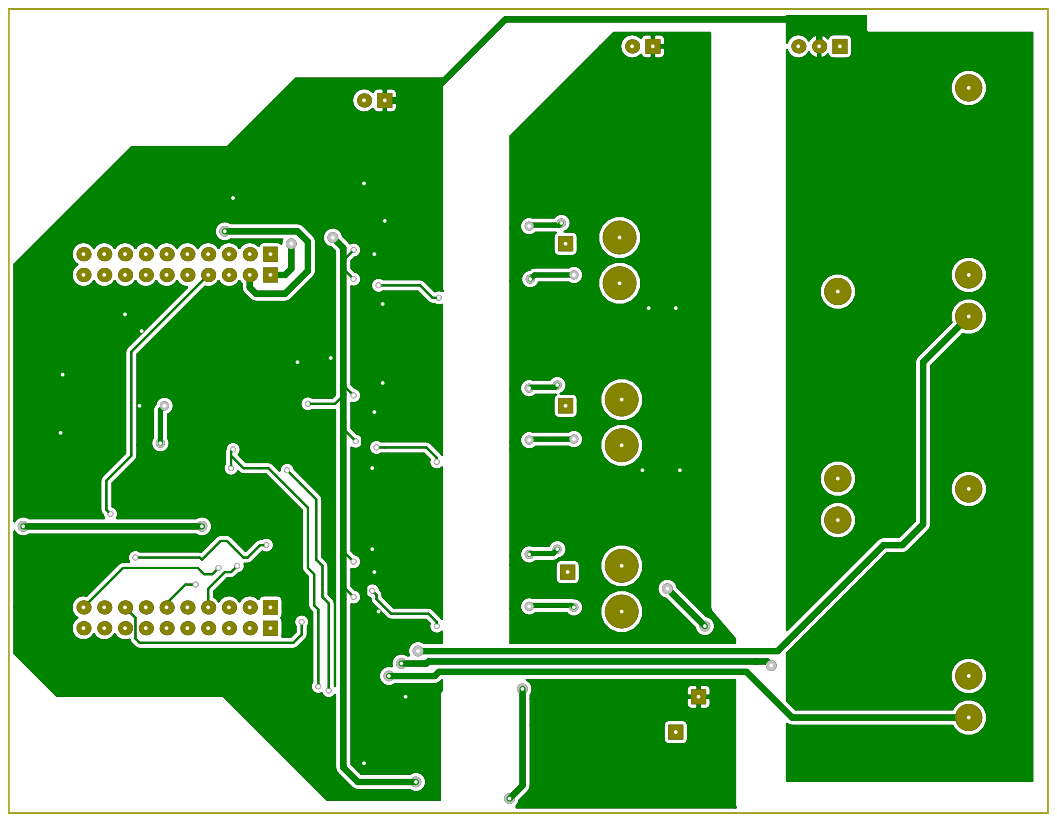
[picture p35: page 2]

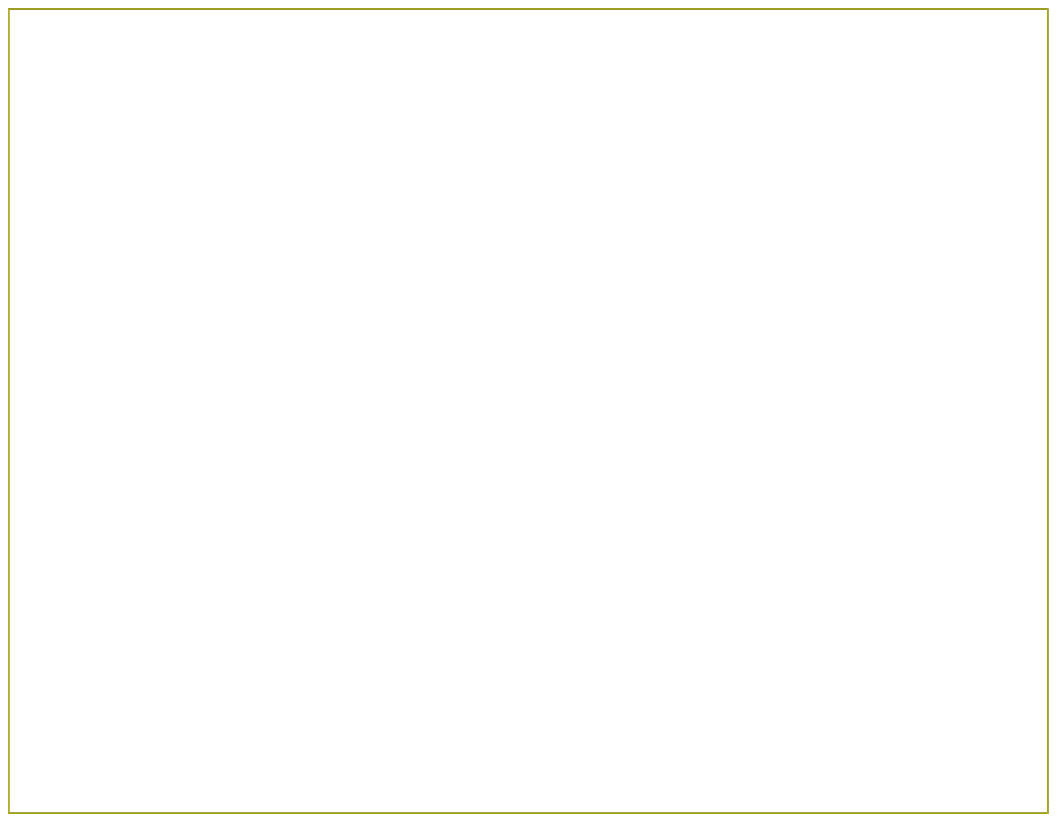
[picture p36: page 3]

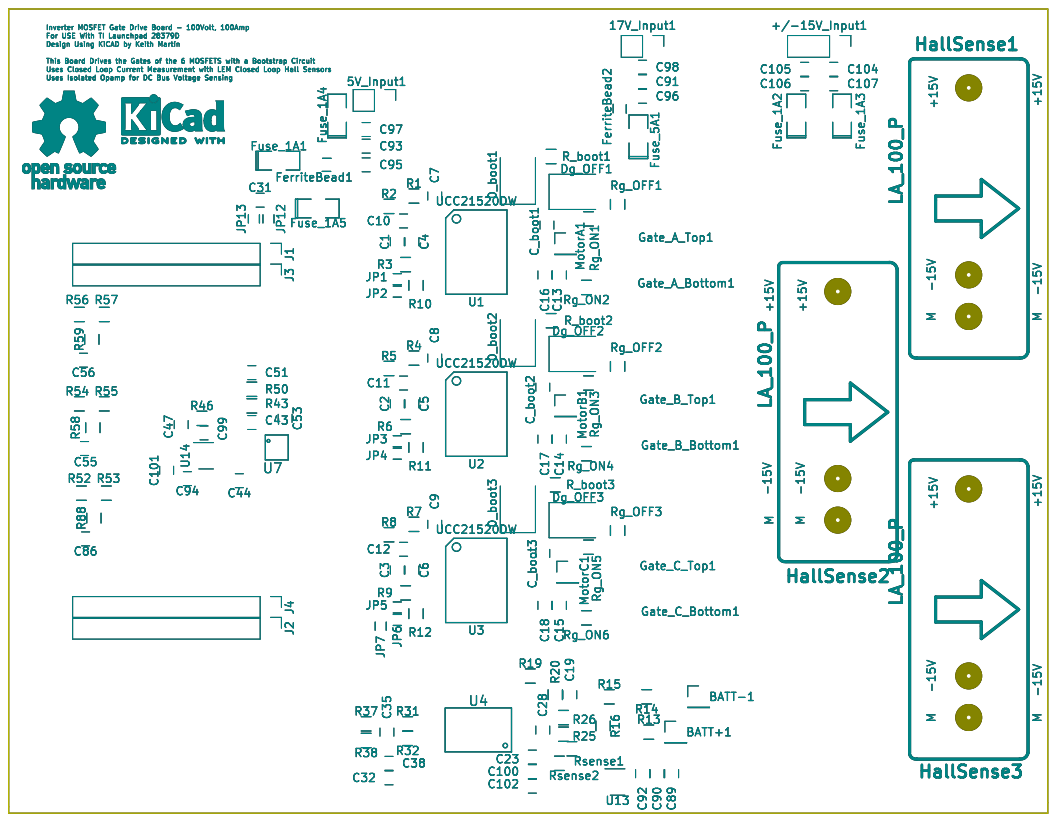
[picture p37: page 4]

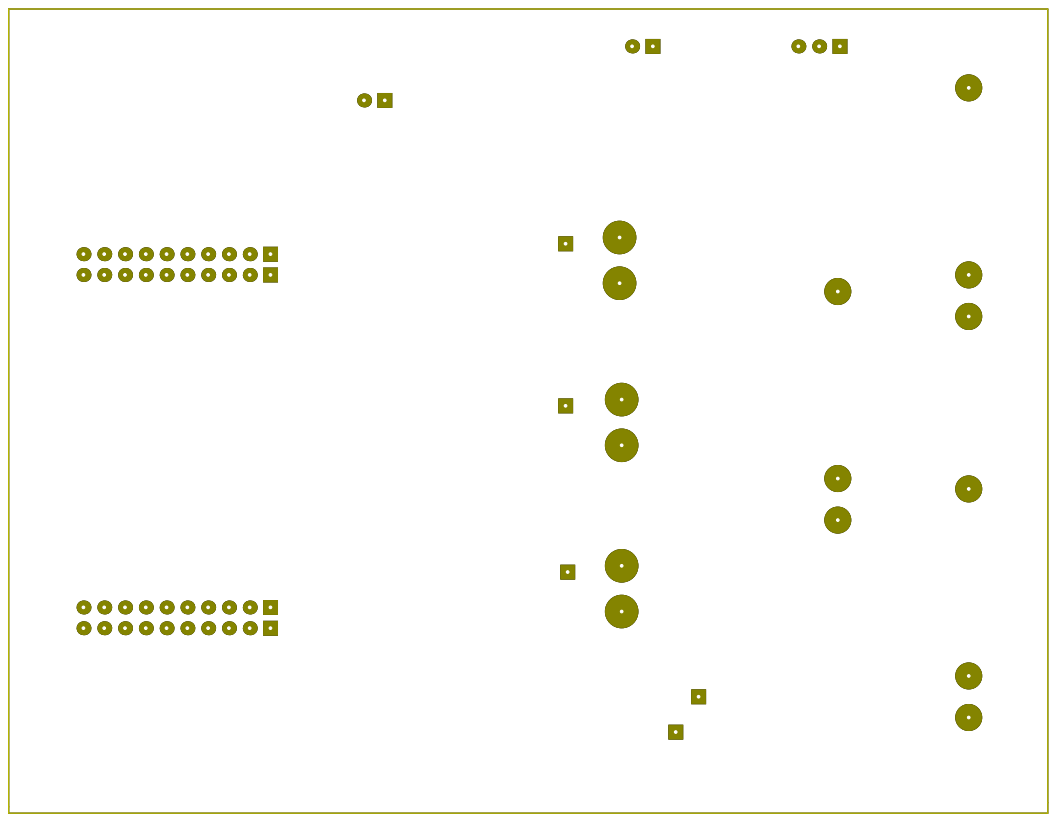
[picture p38: page 5]

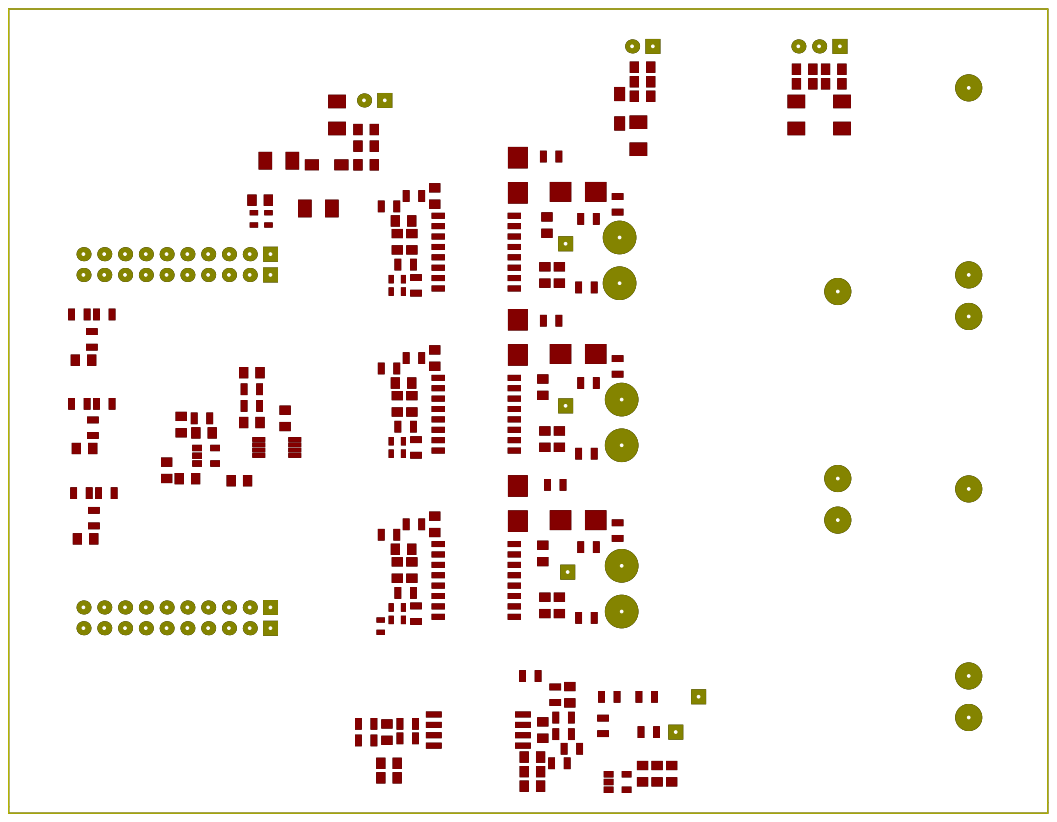
[picture p39: page 6]
