ElectronicEnthusiast/ElectricSkateboard/Hardware/GateDriver_BLDC_MOSFET/GateDriver_BLDC_MOSFET.kicad_pcb

## KiCad design Hardware/GateDriver_BLDC_MOSFET/GateDriver_BLDC_MOSFET.kicad_pcb (2017-05-28)

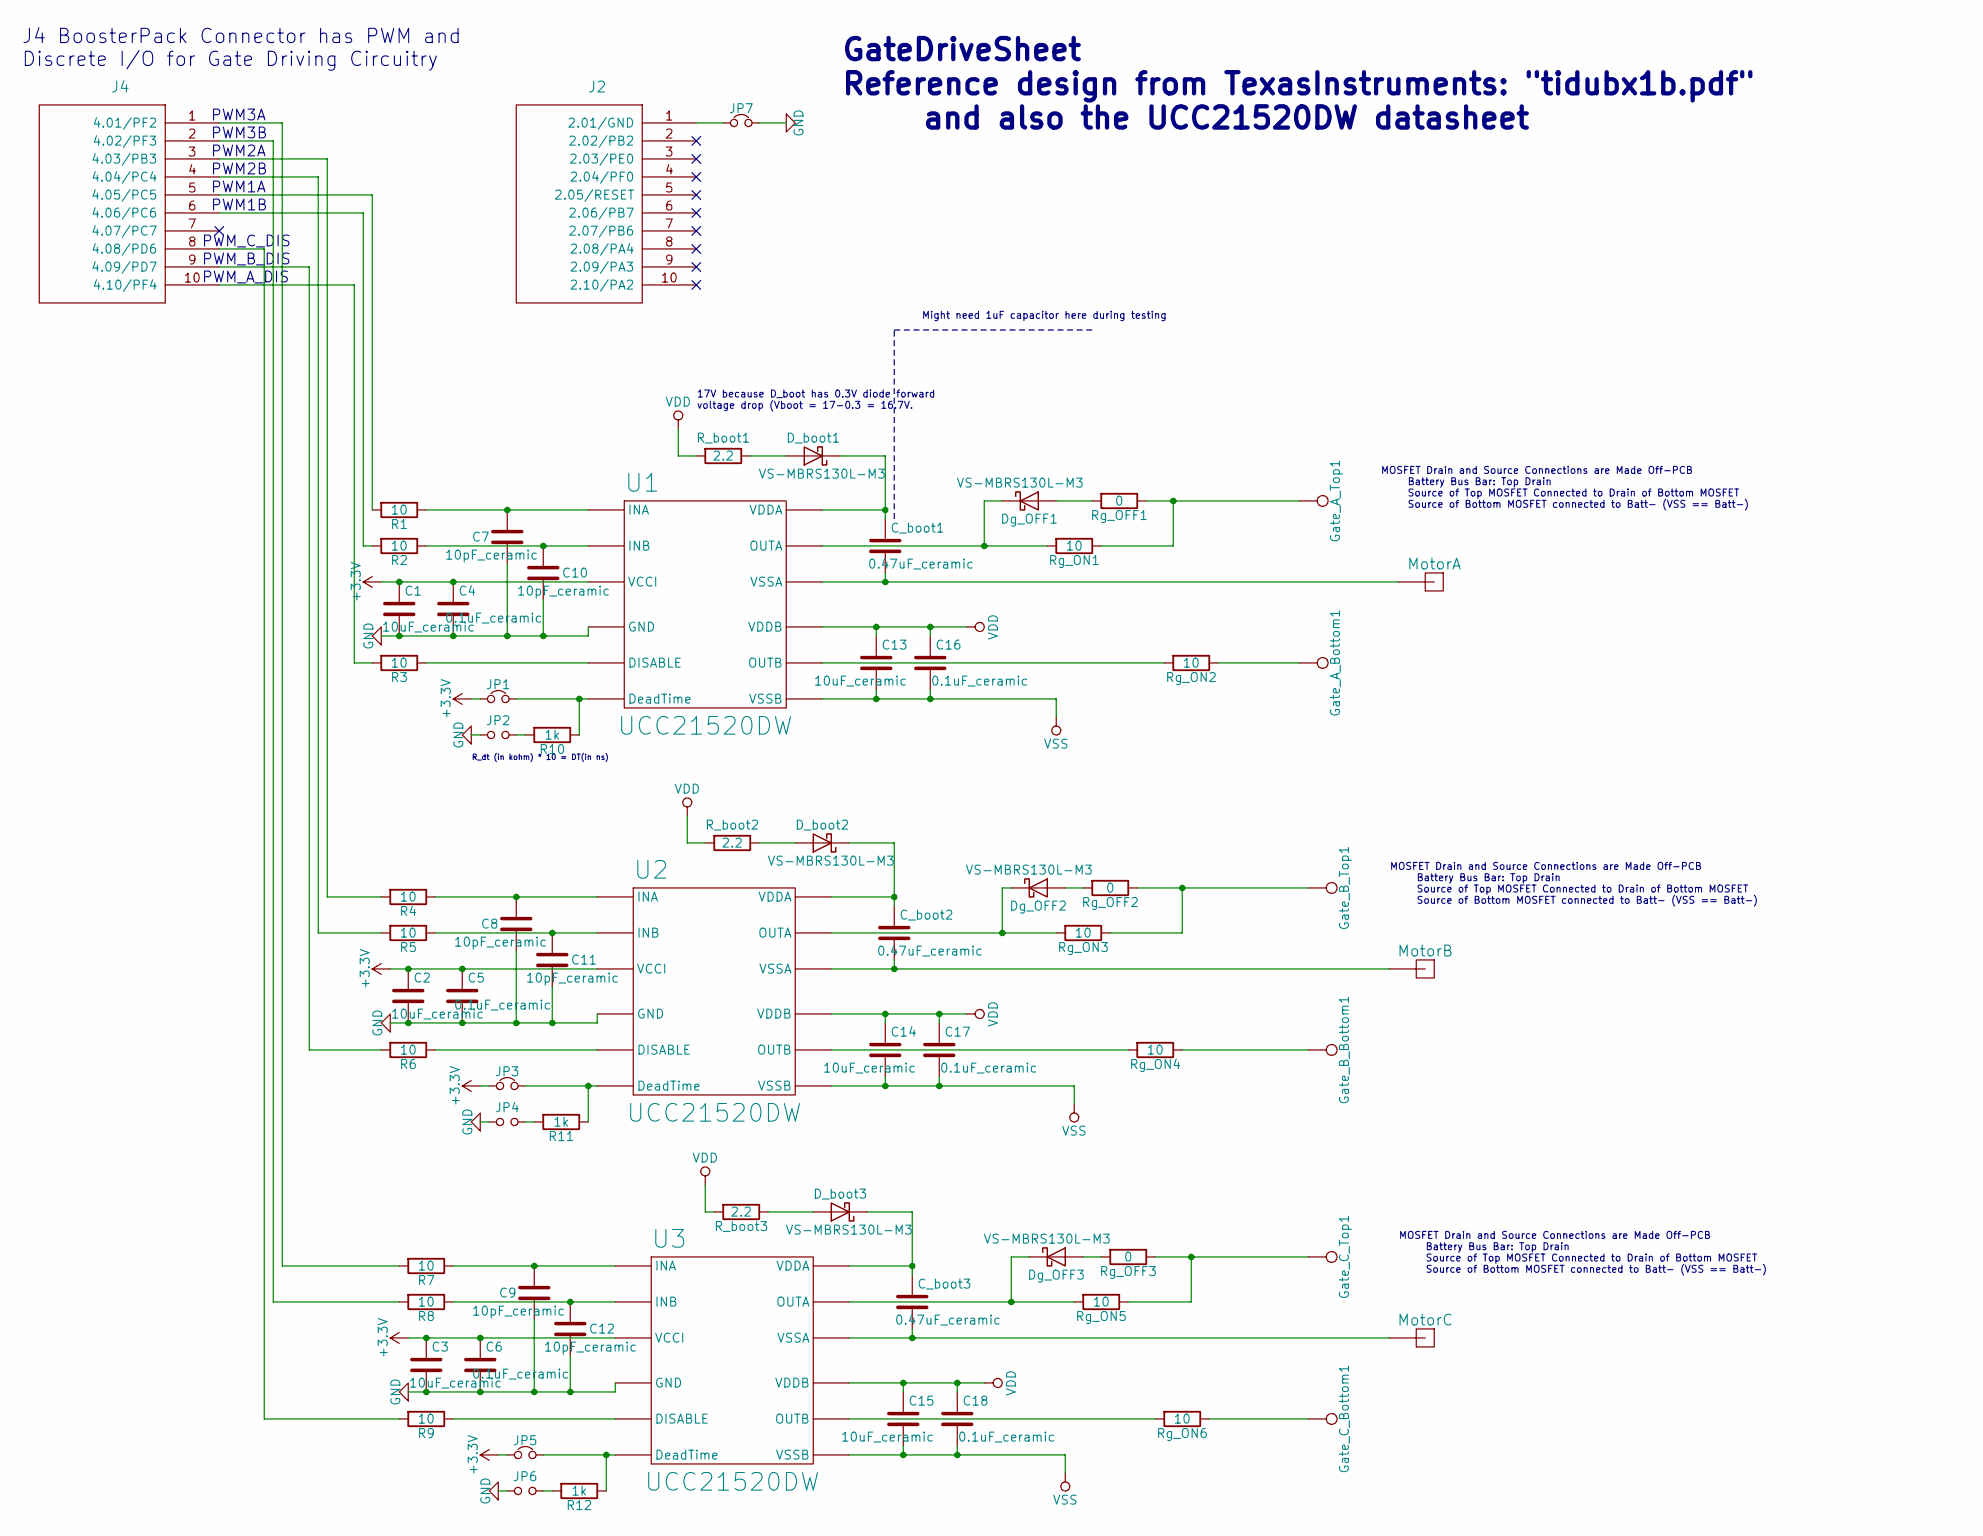
[picture p40: schematic GateDriveSheet.sch]

Parts:
C1, C2, C3, C13, C14, C15: 10uF_ceramic; C_0805
C4, C5, C6, C16, C17, C18: 0.1uF_ceramic; C_0805
C7, C8, C9, C10, C11, C12: 10pF_ceramic; C_0805
C_boot1, C_boot2, C_boot3: 0.47uF_ceramic; C_0805
D_boot1, D_boot2, D_boot3: VS-MBRS130L-M3; D_SMB_Standard
Dg_OFF1, Dg_OFF2, Dg_OFF3: VS-MBRS130L-M3; D_SMB_Standard
Gate_A_Bottom1: Gate_A_Bottom; SolderWirePad_single_1-5mmDrill
Gate_A_Top1: Gate_A_Top; SolderWirePad_single_1-5mmDrill
Gate_B_Bottom1: Gate_B_Bottom; SolderWirePad_single_1-5mmDrill
Gate_B_Top1: Gate_B_Top; SolderWirePad_single_1-5mmDrill
Gate_C_Bottom1: Gate_C_Bottom; SolderWirePad_single_1-5mmDrill
Gate_C_Top1: Gate_C_Top; SolderWirePad_single_1-5mmDrill
J2: TI_BOOSTER_40_J2; Socket_Strip_Straight_1x10_Pitch2.54mm
J4: TI_BOOSTER_40_J4; Socket_Strip_Straight_1x10_Pitch2.54mm
JP1, JP3, JP5, JP7: Jumper_NC_Small; R_0603
JP2, JP4, JP6: Jumper_NO_Small; R_0603
MotorA1: MotorA; Socket_Strip_Straight_1x01_Pitch2.54mm
MotorB1: MotorB; Socket_Strip_Straight_1x01_Pitch2.54mm
MotorC1: MotorC; Socket_Strip_Straight_1x01_Pitch2.54mm
R1, R2, R3, R4, R5, R6, R7, R8, R9: 10; R_0805
R10, R11, R12: 1k; R_0805
R_boot1, R_boot2, R_boot3: 2.2; R_0805
Rg_OFF1, Rg_OFF2, Rg_OFF3: 0; R_0805
Rg_ON1, Rg_ON2, Rg_ON3, Rg_ON4, Rg_ON5, Rg_ON6: 10; R_0805
U1, U2, U3: UCC21520DW; SOIC-16W_7.5x10.3mm_Pitch1.27mm

Connections:
+3V3: C1.1, C2.1, C3.1, C4.1, C5.1, C6.1, JP1.1, JP3.1, JP5.1, U1.3 (VCCI), U1.8 (VCCI), U2.3 (VCCI), U2.8 (VCCI), U3.3 (VCCI), U3.8 (VCCI); also elsewhere on the board
GND: C1.2, C2.2, C3.2, C4.2, C5.2, C6.2, C7.2, C8.2, C9.2, C10.2, C11.2, C12.2, JP2.1, JP4.1, JP6.1, JP7.2, U1.4 (GND), U2.4 (GND), U3.4 (GND); also elsewhere on the board
unnamed: C7.1, R1.1, U1.1 (INA)
unnamed: C8.1, R4.1, U2.1 (INA)
unnamed: C9.1, R7.1, U3.1 (INA)
unnamed: C10.1, R2.1, U1.2 (INB)
unnamed: C11.1, R5.1, U2.2 (INB)
unnamed: C12.1, R8.1, U3.2 (INB)
unnamed: C_boot1.1, D_boot1.1 (K), U1.16 (VDDA)
unnamed: C_boot1.2, MotorA1.1, U1.14 (VSSA)
unnamed: C_boot2.1, D_boot2.1 (K), U2.16 (VDDA)
unnamed: C_boot2.2, MotorB1.1, U2.14 (VSSA)
unnamed: C_boot3.1, D_boot3.1 (K), U3.16 (VDDA)
unnamed: C_boot3.2, MotorC1.1, U3.14 (VSSA)
unnamed: D_boot1.2 (A), R_boot1.1
unnamed: D_boot2.2 (A), R_boot2.1
unnamed: D_boot3.2 (A), R_boot3.1
unnamed: Dg_OFF1.1 (K), Rg_ON1.2, U1.15 (OUTA)
unnamed: Dg_OFF1.2 (A), Rg_OFF1.2
unnamed: Dg_OFF2.1 (K), Rg_ON3.2, U2.15 (OUTA)
unnamed: Dg_OFF2.2 (A), Rg_OFF2.2
unnamed: Dg_OFF3.1 (K), Rg_ON5.2, U3.15 (OUTA)
unnamed: Dg_OFF3.2 (A), Rg_OFF3.2
unnamed: Gate_A_Bottom1.1, Rg_ON2.1
unnamed: Gate_A_Top1.1, Rg_OFF1.1, Rg_ON1.1
unnamed: Gate_B_Bottom1.1, Rg_ON4.1
unnamed: Gate_B_Top1.1, Rg_OFF2.1, Rg_ON3.1
unnamed: Gate_C_Bottom1.1, Rg_ON6.1
unnamed: Gate_C_Top1.1, Rg_OFF3.1, Rg_ON5.1
unnamed: J2.1 (2.01/GND), JP7.1
unnamed: J4.1 (4.01/PF2), R7.2
unnamed: J4.2 (4.02/PF3), R8.2
unnamed: J4.3 (4.03/PB3), R4.2
unnamed: J4.4 (4.04/PC4), R5.2
unnamed: J4.5 (4.05/PC5), R1.2
unnamed: J4.6 (4.06/PC6), R2.2
unnamed: J4.8 (4.08/PD6), R9.2
unnamed: J4.9 (4.09/PD7), R6.2
unnamed: J4.10 (4.10/PF4), R3.2
unnamed: JP1.2, R10.1, U1.6 (DeadTime)
unnamed: JP2.2, R10.2
unnamed: JP3.2, R11.1, U2.6 (DeadTime)
unnamed: JP4.2, R11.2
unnamed: JP5.2, R12.1, U3.6 (DeadTime)
unnamed: JP6.2, R12.2
unnamed: R3.1, U1.5 (DISABLE)
unnamed: R6.1, U2.5 (DISABLE)
unnamed: R9.1, U3.5 (DISABLE)
unnamed: Rg_ON2.2, U1.10 (OUTB)
unnamed: Rg_ON4.2, U2.10 (OUTB)
unnamed: Rg_ON6.2, U3.10 (OUTB)
VDD: C13.1, C14.1, C15.1, C16.1, C17.1, C18.1, R_boot1.2, R_boot2.2, R_boot3.2, U1.11 (VDDB), U2.11 (VDDB), U3.11 (VDDB); also elsewhere on the board
VSS: C13.2, C14.2, C15.2, C16.2, C17.2, C18.2, U1.9 (VSSB), U2.9 (VSSB), U3.9 (VSSB); also elsewhere on the board

Notes on the sheet:
GateDriveSheet Reference design from TexasInstruments: "tidubx1b.pdf" and also the UCC21520DW datasheet
R_dt (in kohm) * 10 = DT(in ns)
17V because D_boot has 0.3V diode forward voltage drop (Vboot = 17-0.3 = 16.7V.
Might need 1uF capacitor here during testing
J4 BoosterPack Connector has PWM and Discrete I/O for Gate Driving Circuitry
PWM3A
PWM3B
PWM2A
PWM2B
PWM1A
PWM1B
PWM_C_DIS
PWM_B_DIS
PWM_A_DIS
MOSFET Drain and Source Connections are Made Off-PCB Battery Bus Bar: Top Drain Source of Top MOSFET Connected to Drain of Bottom MOSFET Source of Bottom MOSFET connected to Batt- (VSS == Batt-)

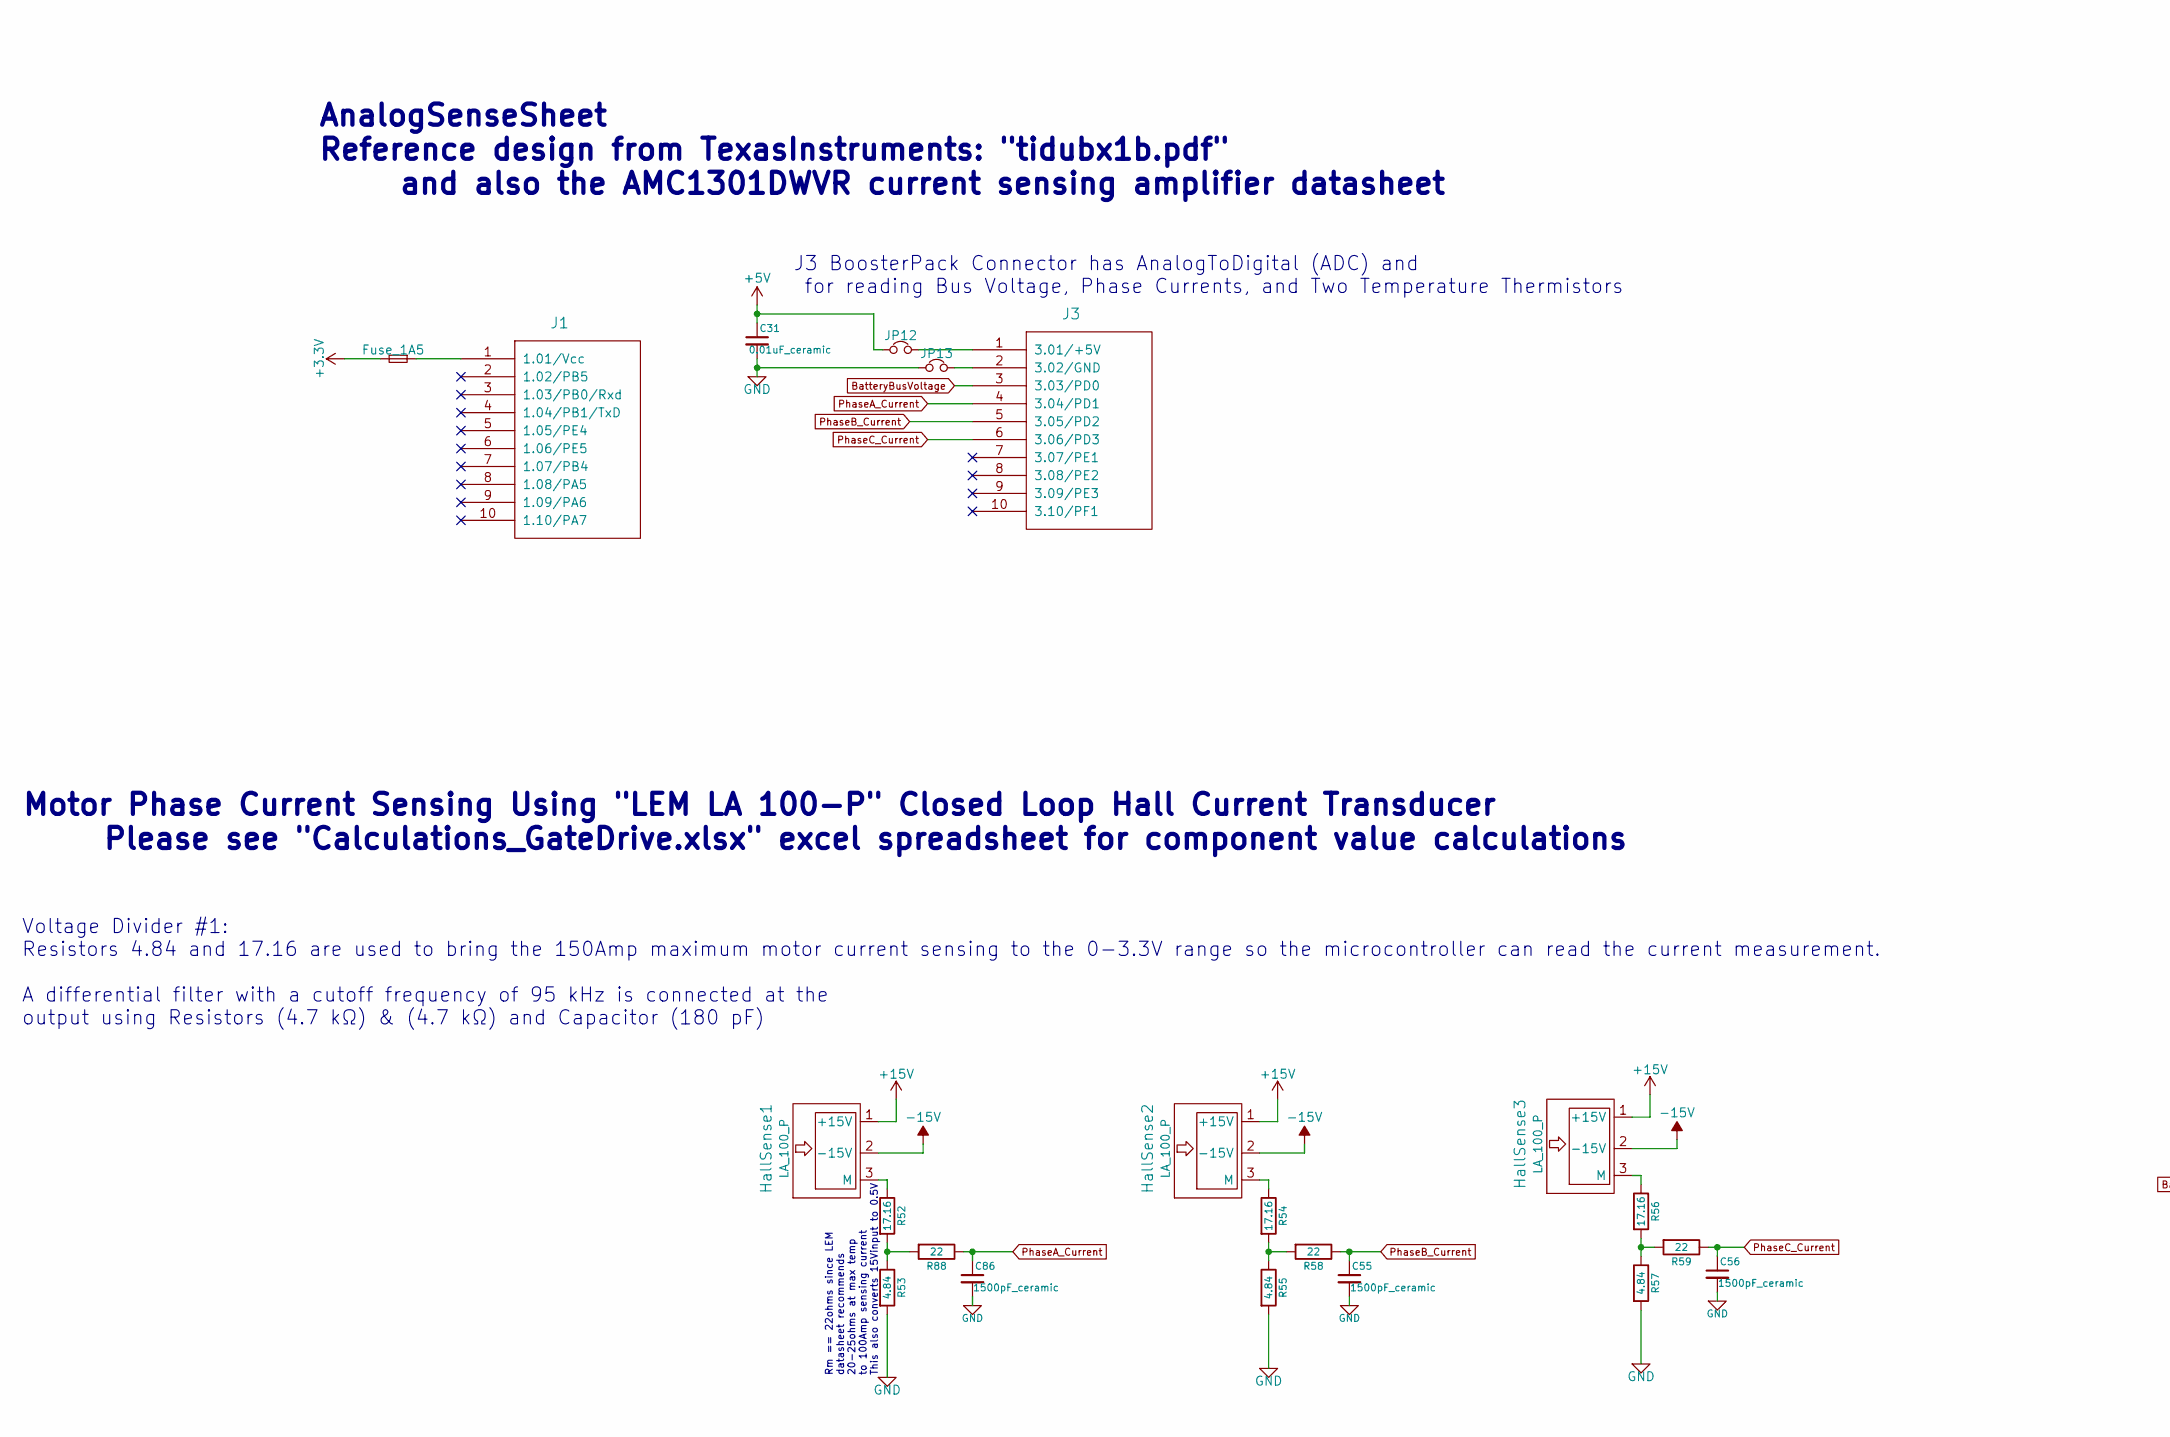
[picture p41: schematic AnalogSenseSheet.sch, part in row 1, column 1]

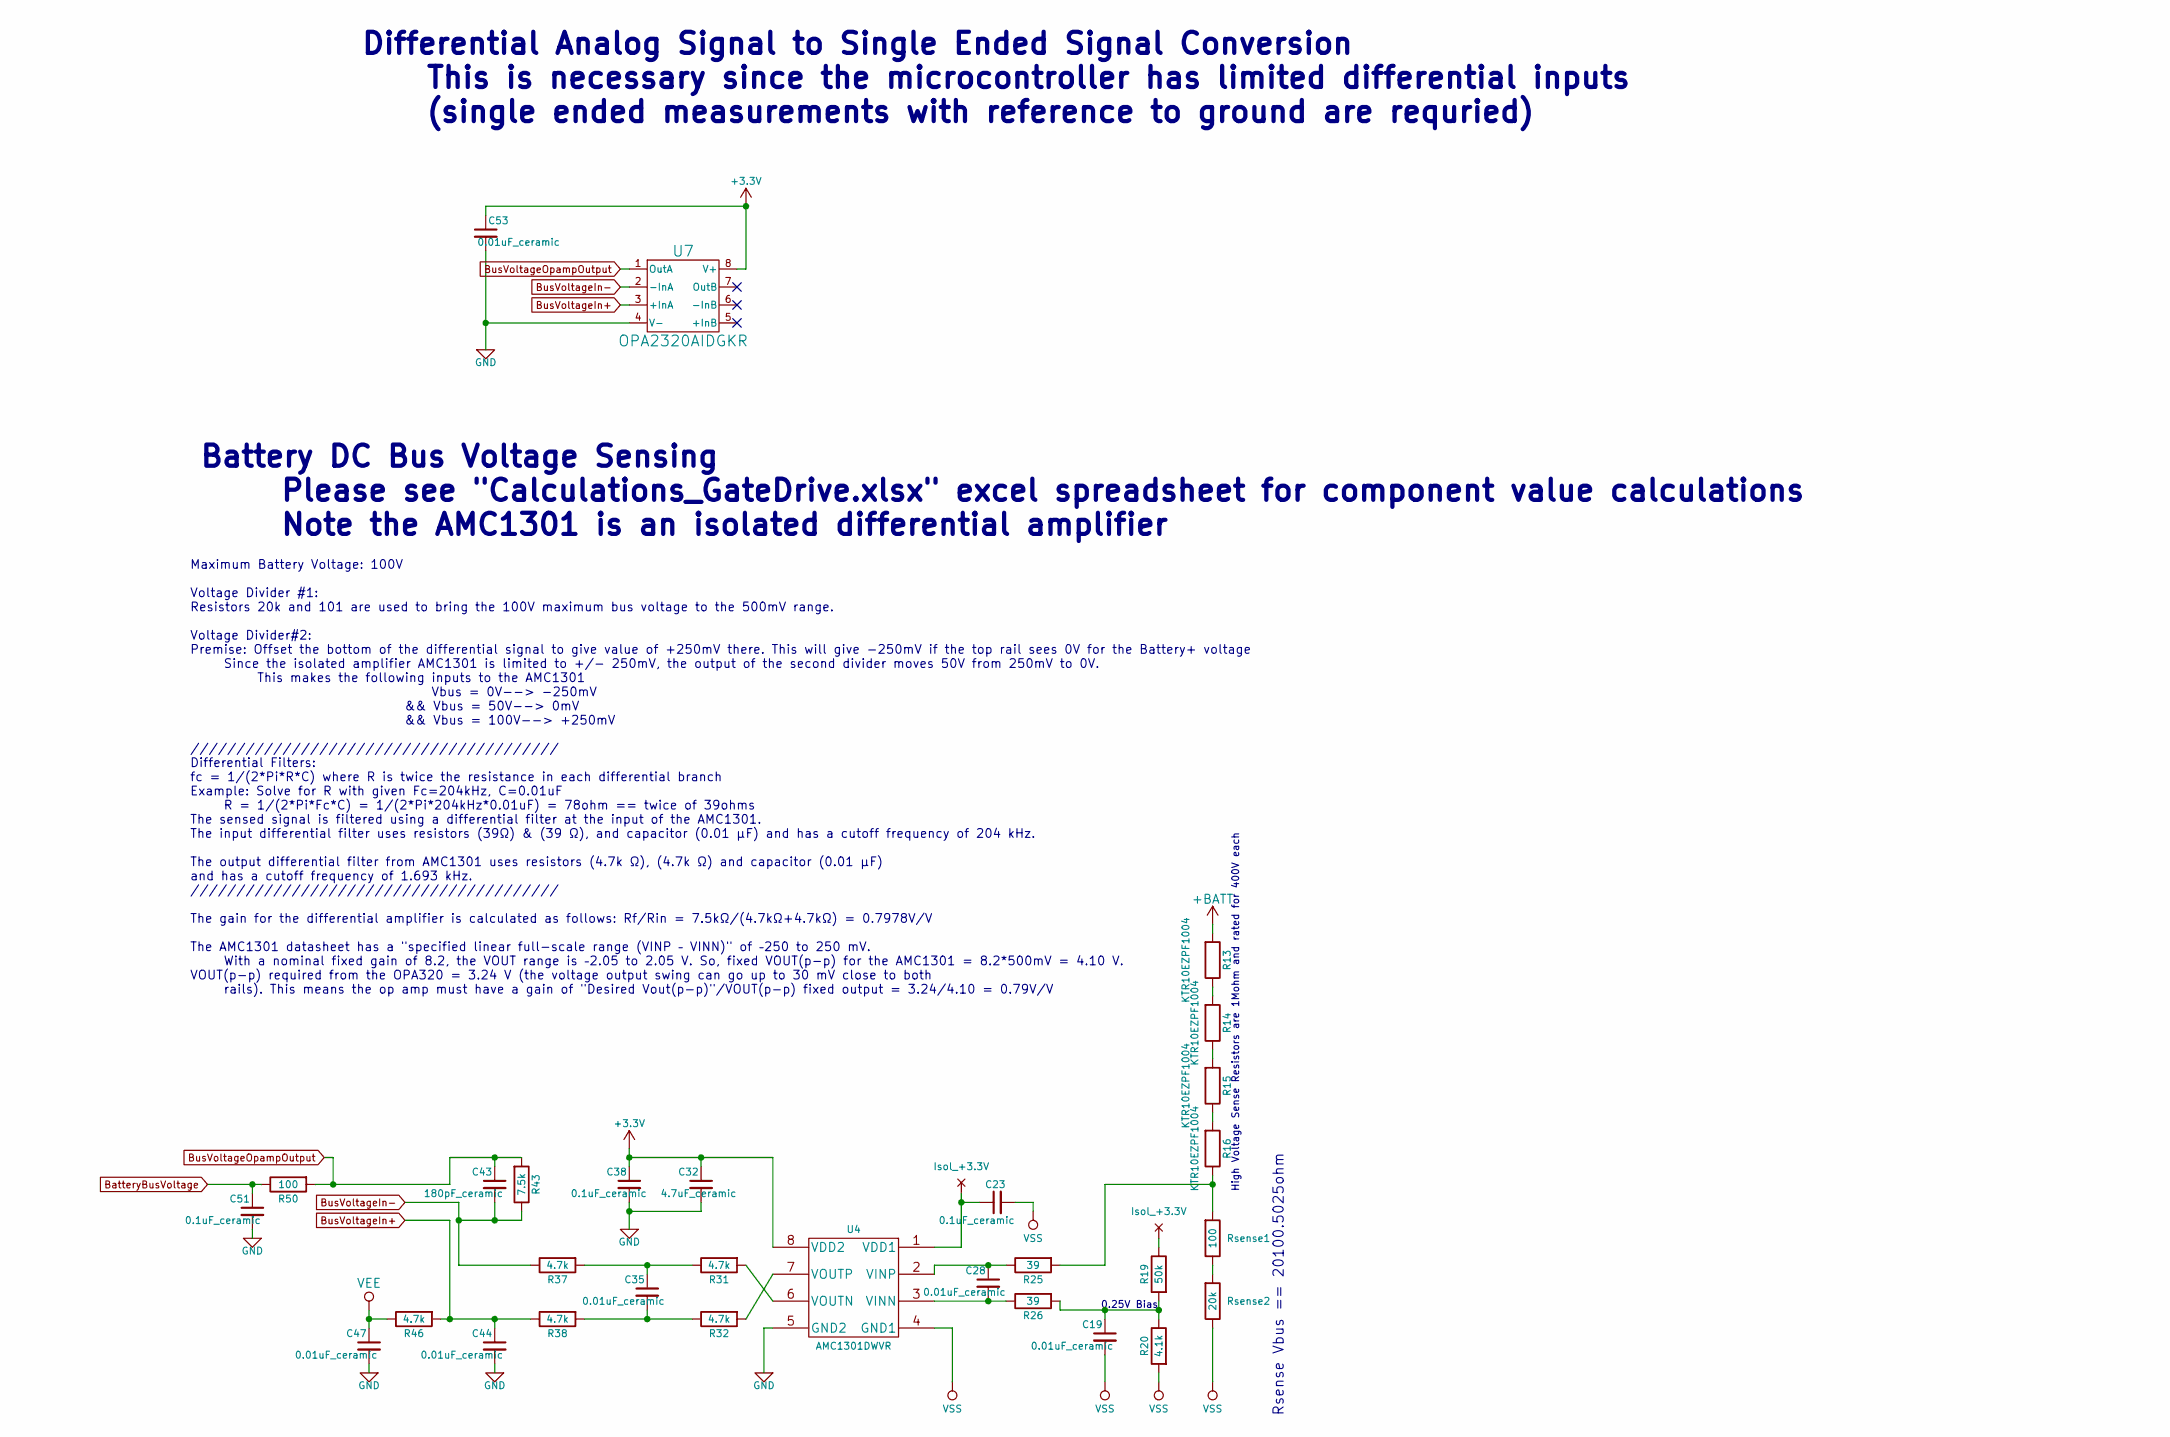
[picture p42: schematic AnalogSenseSheet.sch, part in row 1, column 2]

Parts:
C19, C28, C31, C35, C44, C47, C53: 0.01uF_ceramic; C_0805
C23, C38, C51: 0.1uF_ceramic; C_0805
C32: 4.7uF_ceramic; C_0805
C43: 180pF_ceramic; C_0805
C55, C56, C86: 1500pF_ceramic; C_0805
Fuse_1A5: MFU1206FF01000P100; SMD-1206_Pol
HallSense1, HallSense2, HallSense3: LA_100_P; la_55_p
J1: TI_BOOSTER_40_J1; Socket_Strip_Straight_1x10_Pitch2.54mm
J3: TI_BOOSTER_40_J3; Socket_Strip_Straight_1x10_Pitch2.54mm
JP12, JP13: Jumper_NC_Small; R_0603
R13, R14, R15, R16: KTR10EZPF1004; R_0805
R19: 50k; R_0805
R20: 4.1k; R_0805
R25, R26: 39; R_0805
R31, R32, R37, R38, R46: 4.7k; R_0805
R43: 7.5k; R_0805
R50: 100; R_0805
R52, R54, R56: 17.16; R_0805
R53, R55, R57: 4.84; R_0805
R58, R59, R88: 22; R_0805
Rsense1: 100; R_0805
Rsense2: 20k; R_0805
U4: AMC1301DWVR; SOIC-8-DWV
U7: OPA2320AIDGKR; VSSOP-8

Connections:
+3V3: C32.1, C38.1, C53.1, Fuse_1A5.2, U4.8 (VDD2), U7.8 (V+); also elsewhere on the board
+5V: C31.1, JP12.1; also elsewhere on the board
+15V: HallSense1.1 (+15V), HallSense2.1 (+15V), HallSense3.1 (+15V); also elsewhere on the board
+BATT: R13.2; also elsewhere on the board
-15V: HallSense1.2 (-15V), HallSense2.2 (-15V), HallSense3.2 (-15V); also elsewhere on the board
BatteryBusVoltage: C51.1, J3.3 (3.03/PD0), R50.1
BusVoltageIn+: C44.1, R38.1, R46.2, U7.3 (+InA)
BusVoltageIn-: C43.2, R37.1, R43.1, U7.2 (-InA)
BusVoltageOpampOutput: C43.1, R43.2, R50.2, U7.1 (OutA)
GND: C31.2, C32.2, C38.2, C44.2, C47.2, C51.2, C53.2, C55.2, C56.2, C86.2, JP13.1, R53.2, R55.2, R57.2, U4.5 (GND2), U7.4 (V-); also elsewhere on the board
Isol_+3.3V: C23.1, R19.1, U4.1 (VDD1); also elsewhere on the board
unnamed: C19.1, R19.2, R20.1, R26.2
unnamed: C28.1, R25.1, U4.2 (VINP)
unnamed: C28.2, R26.1, U4.3 (VINN)
unnamed: C35.1, R31.1, R37.2
unnamed: C35.2, R32.1, R38.2
unnamed: Fuse_1A5.1, J1.1 (1.01/Vcc)
unnamed: HallSense1.3 (M), R52.1
unnamed: HallSense2.3 (M), R54.1
unnamed: HallSense3.3 (M), R56.1
unnamed: J3.1 (3.01/+5V), JP12.2
unnamed: J3.2 (3.02/GND), JP13.2
unnamed: R13.1, R14.2
unnamed: R14.1, R15.2
unnamed: R15.1, R16.2
unnamed: R16.1, R25.2, Rsense1.2
unnamed: R31.2, U4.6 (VOUTN)
unnamed: R32.2, U4.7 (VOUTP)
unnamed: R52.2, R53.1, R88.2
unnamed: R54.2, R55.1, R58.2
unnamed: R56.2, R57.1, R59.2
unnamed: Rsense1.1, Rsense2.2
PhaseA_Current: C86.1, J3.4 (3.04/PD1), R88.1
PhaseB_Current: C55.1, J3.5 (3.05/PD2), R58.1
PhaseC_Current: C56.1, J3.6 (3.06/PD3), R59.1
VEE: C47.1, R46.1; also elsewhere on the board
VSS: C19.2, C23.2, R20.2, Rsense2.1, U4.4 (GND1); also elsewhere on the board

Notes on the sheet:
AnalogSenseSheet Reference design from TexasInstruments: "tidubx1b.pdf" and also the AMC1301DWVR current sensing amplifier datasheet
Voltage Divider #1: Resistors 4.84 and 17.16 are used to bring the 150Amp maximum motor current sensing to the 0-3.3V range so the microcontroller can read the current measurement. A differential filter with a cutoff frequency of 95 kHz is connected at the output using Resistors (4.7 kΩ) & (4.7 kΩ)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
Motor Phase Current Sensing Using "LEM LA 100-P" Closed Loop Hall Current Transducer Please see "Calculations_GateDrive.xlsx" excel spreadsheet for component value calculations
Maximum Battery Voltage: 100V Voltage Divider #1: Resistors 20k and 101 are used to bring the 100V maximum bus voltage to the 500mV range. Voltage Divider#2: Premise: Offset the bottom of the differential signal to give value of +250mV there. This will give -250mV if the top rail sees 0V for the Ba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
Battery DC Bus Voltage Sensing Please see "Calculations_GateDrive.xlsx" excel spreadsheet for component value calculations Note the AMC1301 is an isolated differential amplifier
0.25V Bias
Differential Analog Signal to Single Ended Signal Conversion This is necessary since the microcontroller has limited differential inputs (single ended measurements with reference to ground are requried)
J3 BoosterPack Connector has AnalogToDigital (ADC) and for reading Bus Voltage, Phase Currents, and Two Temperature Thermistors
Rsense Vbus == 20100.5025ohm
Rm == 22ohms since LEM datasheet recommends 20-25ohms at max temp to 100Amp sensing current This also converts 15Vinput to 0.5V
High Voltage Sense Resistors are 1Mohm and rated for 400V each

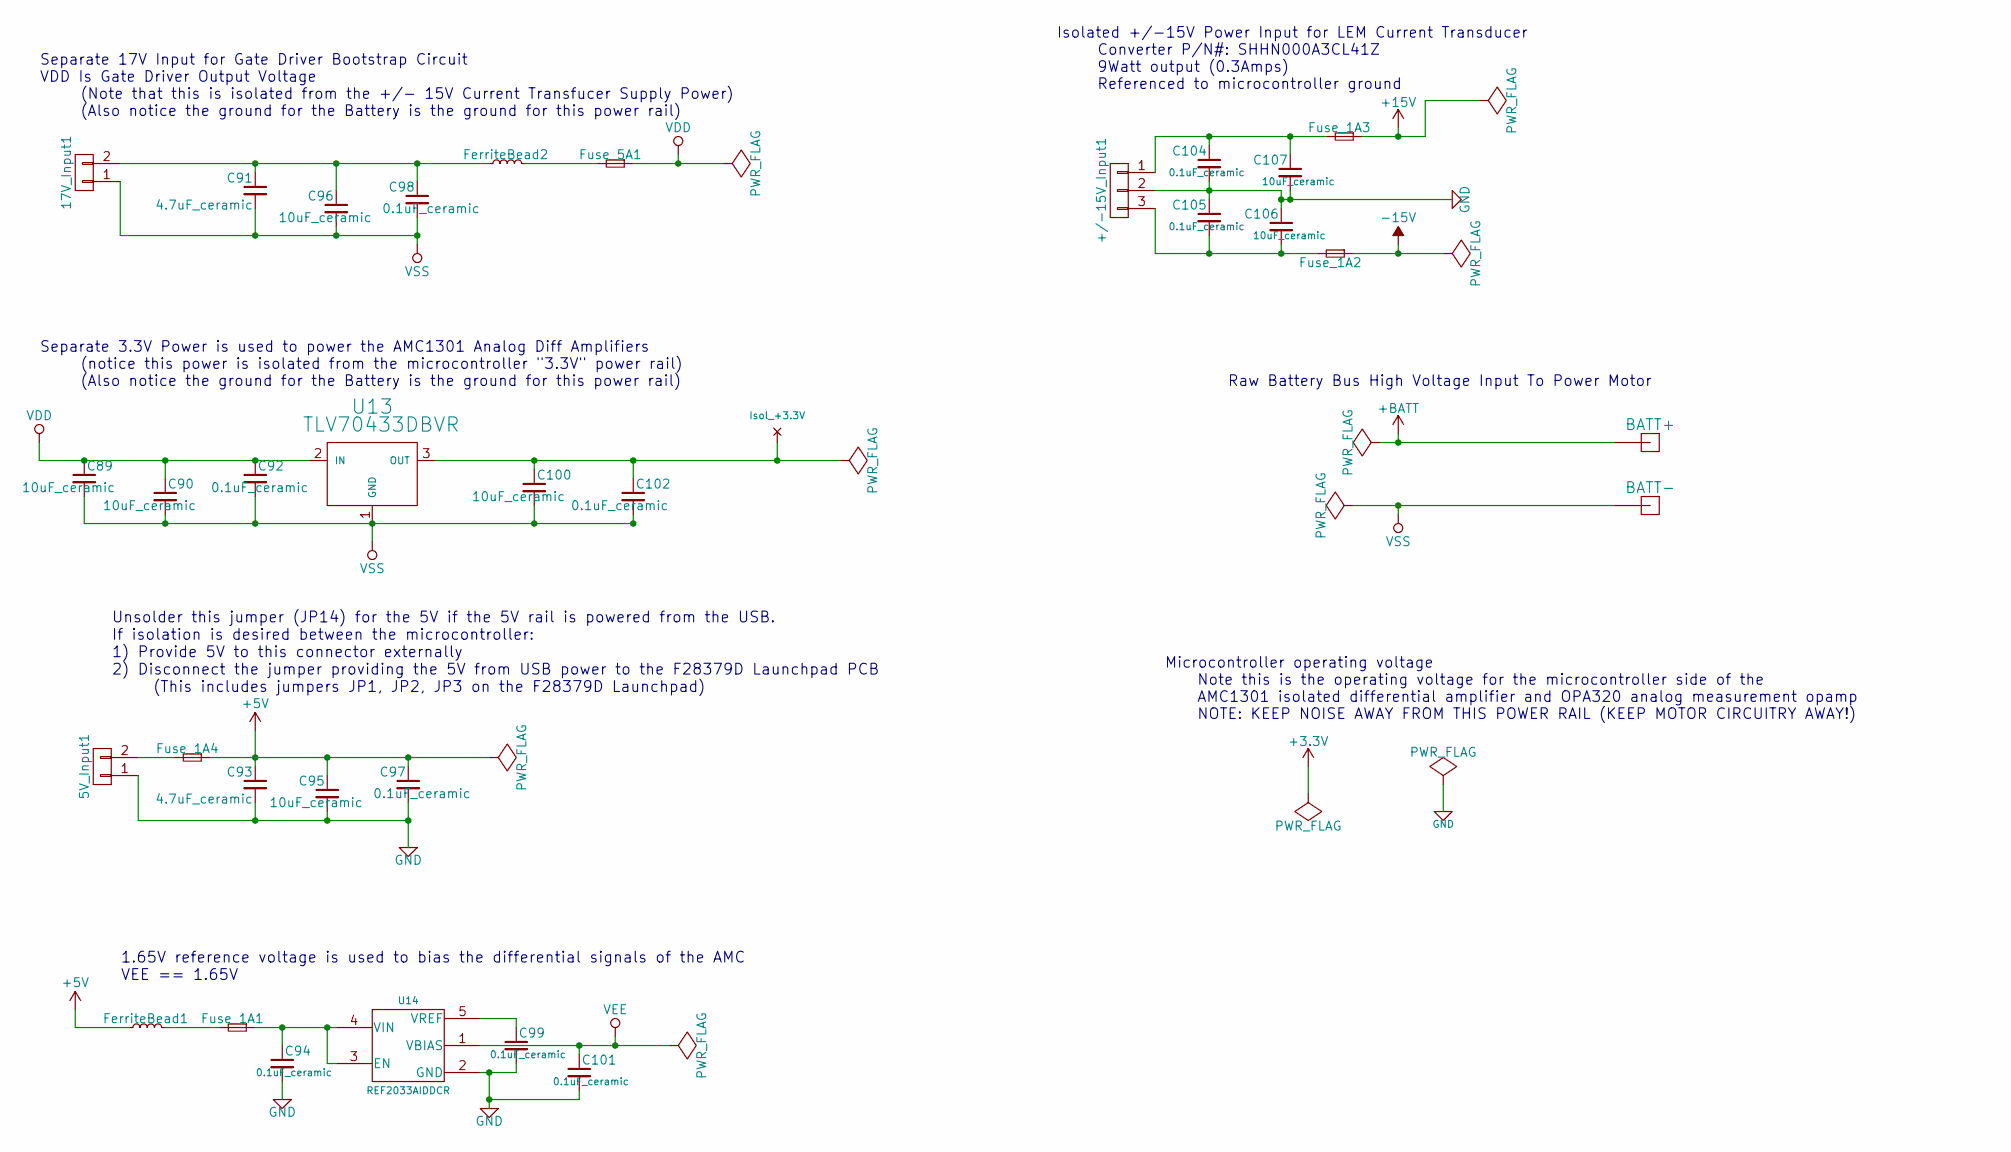
[picture p43: schematic Power_Inputs.sch]

Parts:
5V_Input1, 17V_Input1: CONN_01X02; Socket_Strip_Straight_1x02_Pitch2.54mm
+/-15V_Input1: CONN_01X03; Socket_Strip_Straight_1x03_Pitch2.54mm
BATT+1: BATT+; Socket_Strip_Straight_1x01_Pitch2.54mm
BATT-1: BATT-; Socket_Strip_Straight_1x01_Pitch2.54mm
C89, C90, C95, C96, C100, C106, C107: 10uF_ceramic; C_0805
C91, C93: 4.7uF_ceramic; C_0805
C92, C94, C97, C98, C99, C101, C102, C104, C105: 0.1uF_ceramic; C_0805
FerriteBead1, FerriteBead2: BLM31SN500SH1L; Choke_SMD_1206_Standard
Fuse_1A1, Fuse_1A2, Fuse_1A3, Fuse_1A4: MFU1206FF01000P100; SMD-1206_Pol
Fuse_5A1: MFU1206FF05000P100; SMD-1206_Pol
U13: TLV70433DBVR; SOT-23-5
U14: REF2033AIDDCR; SOT-23-5

Connections:
+5V: C93.1, C95.1, C97.1, FerriteBead1.2, Fuse_1A4.1; also elsewhere on the board
+15V: Fuse_1A3.1; also elsewhere on the board
+BATT: BATT+1.1; also elsewhere on the board
-15V: Fuse_1A2.1; also elsewhere on the board
GND: 5V_Input1.1, +/-15V_Input1.2, C93.2, C94.2, C95.2, C97.2, C99.2, C101.2, C104.2, C105.1, C106.1, C107.2, U14.2 (GND); also elsewhere on the board
Isol_+3.3V: C100.1, C102.1, U13.3 (OUT); also elsewhere on the board
unnamed: 5V_Input1.2, Fuse_1A4.2
unnamed: 17V_Input1.2, C91.1, C96.1, C98.1, FerriteBead2.2
unnamed: +/-15V_Input1.1, C104.1, C107.1, Fuse_1A3.2
unnamed: +/-15V_Input1.3, C105.2, C106.2, Fuse_1A2.2
unnamed: C94.1, Fuse_1A1.1, U14.3 (EN), U14.4 (VIN)
unnamed: C99.1, U14.5 (VREF)
unnamed: FerriteBead1.1, Fuse_1A1.2
unnamed: FerriteBead2.1, Fuse_5A1.2
VDD: C89.1, C90.1, C92.1, Fuse_5A1.1, U13.2 (IN); also elsewhere on the board
VEE: C101.1, U14.1 (VBIAS); also elsewhere on the board
VSS: 17V_Input1.1, BATT-1.1, C89.2, C90.2, C91.2, C92.2, C96.2, C98.2, C100.2, C102.2, U13.1 (GND); also elsewhere on the board

Notes on the sheet:
Raw Battery Bus High Voltage Input To Power Motor
Isolated +/-15V Power Input for LEM Current Transducer Converter P/N#: SHHN000A3CL41Z 9Watt output (0.3Amps) Referenced to microcontroller ground
Separate 17V Input for Gate Driver Bootstrap Circuit VDD Is Gate Driver Output Voltage (Note that this is isolated from the +/- 15V Current Transfucer Supply Power) (Also notice the ground for the Battery is the ground for this power rail)
Separate 3.3V Power is used to power the AMC1301 Analog Diff Amplifiers (notice this power is isolated from the microcontroller "3.3V" power rail) (Also notice the ground for the Battery is the ground for this power rail)
Unsolder this jumper (JP14) for the 5V if the 5V rail is powered from the USB. If isolation is desired between the microcontroller: 1) Provide 5V to this connector externally 2) Disconnect the jumper providing the 5V from USB power to the F28379D Launchpad PCB (This includes jumpers JP1, JP2, JP3 o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
1.65V reference voltage is used to bias the differential signals of the AMC VEE == 1.65V
Microcontroller operating voltage Note this is the operating voltage for the microcontroller side of the AMC1301 isolated differential amplifier and OPA320 analog measurement opamp NOTE: KEEP NOISE AWAY FROM THIS POWER RAIL (KEEP MOTOR CIRCUITRY AWAY!)

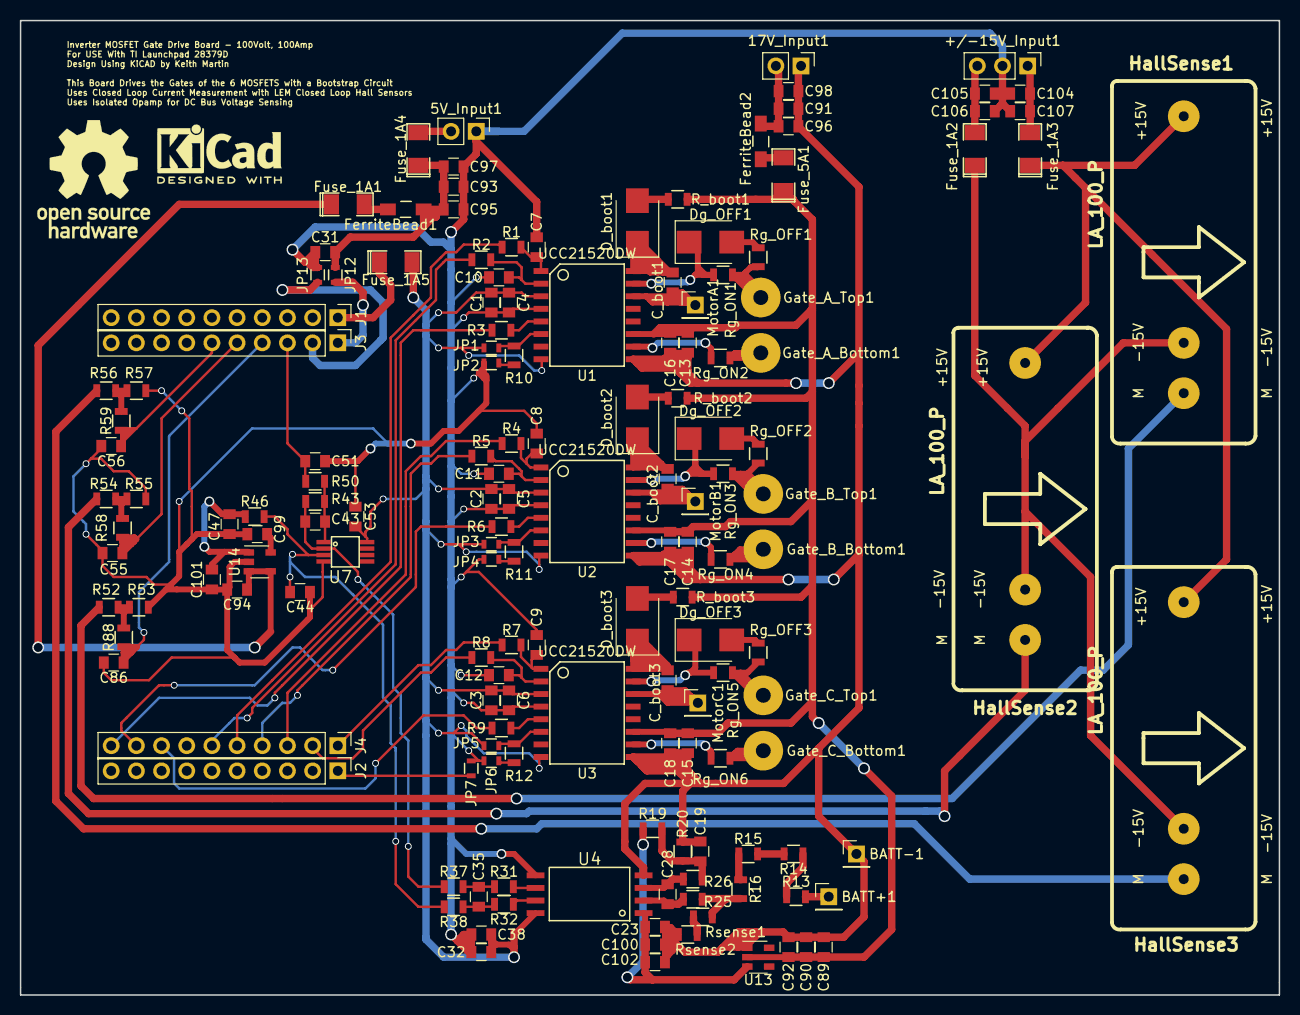
[picture p44: board GateDriver_BLDC_MOSFET.kicad_pcb from above]

Board: 2 copper layers, 127.0 x 98.3 mm, 155 parts (0 on the bottom side), 95 nets.
