ElectronicEnthusiast/ElectricSkateboard/(commit log)

2017-05-28 Added hardware files from old repository
    now I can upload updates from TI's CCS program and still have the
    hardware in the same repository
    [AnalogSenseSheet.sch, BOM1_Mouser.xlsx, Calculations_GateDriverBoard.xlsx, GateDriveSheet.sch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]
2017-05-28 Added More Pictures and Fixed Linking to CCS
    [DLOG_4CH_F.obj, F2837xD_Adc.obj, F2837xD_CodeStartBranch.obj, F2837xD_DefaultISR.obj, F2837xD_EPwm.obj, F2837xD_GlobalVariableDefs.obj, F2837xD_Gpio.obj, F2837xD_PieCtrl.obj]
2017-07-04 Phase2 Working Software_LEM Current Sense on Pins B4&C4
    LEM Current Sensing on Pins B4&C4
    Changed Max Current to 25A (100/4turns through LEM)
    [IDDK_PM_Servo_F2837x.obj, resolver.obj]
2017-07-04 Fixed Frequency Change To Normal & Added Pictures
    [IDDK_PM_Servo_F2837x.obj, resolver.obj]
2017-07-21 Diagnosing GateDriverBoard
    2/3 Gate Drives working.
    U3 is not working right.
    [AnalogSenseSheet.sch, IDDK_PM_Servo_F2837x.obj, _saved_AnalogSenseSheet.sch, config.txt, resolver.obj]
